CopperPilot/desktop-computer-retro/reviews/README.md

# Reviews

- [Design gates](gates.md): every deterministic check and its result.
- [Compact all-in-one CM5 desktop computer: main board](review-desktop-main.md): 0 P0, 0 P1, 0 P2
- [Compact all-in-one CM5 desktop computer: front SD card and brightness encoder sub-board](review-desktop-front_io.md): 0 P0, 0 P1, 0 P2
- [Compact 58-key mechanical desktop keyboard: main board](review-keyboard-main.md): 0 P0, 0 P1, 1 P2
- [Single-button rectangular optical USB mouse: main board](review-mouse-main.md): 0 P0, 0 P1, 0 P2
- [Independent judge](judge.md): the build compared with the reference photos.
- [Build film review](film.md): the film watched frame by frame by a separate critic.
- [KiCad ERC and DRC](kicad): the raw JSON reports for every board.
