CopperPilot/desktop-computer-retro/modules/mouse/hardware/README.md

# Mouse PCBA Hardware Documentation

Generated from `rea/spec.yaml` by `rea-hardware` (JLCPCB 2-layer 1.6 mm stackup, design rules, 52.0 x 86.0 mm board outline at the origin, and M2 mounting holes), and completed for the single-button rectangular optical USB-C mouse. Every placed symbol carries a verified in-stock `LCSC` part number, matches the structured `rea/spec.yaml` BOM and power-tree definitions, and uses its matching `lcsc` footprint and 3D STEP model.

## Architecture & Blocks

1. **`usb_power` (USB-C Sink, 250 mA PPTC Fuse `F1`, Series P-MOSFET Reverse-Polarity Switch `Q2`, Transient ESD Clamp Reference `D1`, Critical Hot-Plug LC Damping, and 18V-VIN 3.3 V / 2.0 V CMOS LDO Regulation)**
   - **J1 (`TYPE-C-31-M-12`, LCSC `C165948`)**: 16-pin USB Type-C receptacle on the north edge (`+Y`, `rot_deg: 180`). Configured as a USB 2.0 Full-Speed sink with separate 5.1 kOhm 1% pull-down resistors **R1** (CC1) and **R2** (CC2) (`0603WAF5101T5E`, LCSC `C23186`) to `GND`.
   - **F1 (`BSMD0603-025-24V`, LCSC `C7543776`, `250 mA` $I_{\text{hold}}$ @ 25 degC / `190 mA >= 150 mA` @ 50 degC, `550 mA` $I_{\text{trip}}$, `24 V`, `40 A`, `500 mW`, `0603`, $R_{\min} = 0.50\ \Omega$, $R_{1\max} = 3.0\ \Omega$)**: Placed directly in series at `J1` VBUS entry (`USB_VBUS -> F1 -> VBUS_FUSED`), supporting both the 51.1 mA active / <= 80 mA continuous mouse load and the 150 mA `3V3_MOUSE` rail capability with thermal derating headroom (`190 mA @ 50 degC >= 150 mA`).
   - **Q2 (`AO3401A`, LCSC `C15127`, `SOT-23` P-Channel MOSFET), D6 (`BZT52C8V2S`, LCSC `C22375294`, `SOD-323` 8.2 V Zener), & R15 (`0603WAF1002T5E`, LCSC `C25804`, `10 kOhm`)**:
     - `Q2` sits in series between `VBUS_FUSED` (Drain, pin 3) and `VBUS_PROT` (Source, pin 2) with Gate (`VBUS_Q2_G`, pin 1) pulled down to `GND` via `R15` (`10 kOhm`) and clamped to Source (`VBUS_PROT`) by 8.2 V Zener diode `D6` (`BZT52C8V2S`, $V_Z = 7.7\text{--}8.7\text{ V}$, $I_R \le 700\text{ nA} @ 5\text{ V}$).
     - Under normal 5.0 V USB VBUS (`4.75-5.25 V`), `Q2` conducts in the third quadrant with $V_{GS} = -4.75\text{ V}$ to $-5.25\text{ V}$ and $R_{DS(\text{on})} \le 60\text{ m}\Omega$ (`3.1 mV` drop at `51.1 mA`, `9.0 mV` drop at `150 mA`).
     - During reverse polarity on `USB_VBUS` (down to `-24 V`), `Q2` is completely OFF ($V_{GS} = 0\text{ V}$ and Drain-to-Source body diode reverse-biased, $V_{DS,\max} = -30\text{ V}$), isolating `VBUS_PROT`, `D1`, and `5V_USB_MOUSE` / `U3` (`ME6209A33M3G`, `VIN_min = -0.3 V`) at `0.00 V`.
     - On high-voltage transients (up to `24 V`), `D6` clamps `Q2` $|V_{GS}| \le 8.7\text{ V} < 12.0\text{ V}$ (`AO3401A` absolute maximum $|V_{GS}|$).
   - **D1 (`USBLC6-2SC6`, LCSC `C2687116`) & C11 (`CC0603KRX7R9BB105`, LCSC `C559769`, `1 uF 50 V X7R 0603`)**:
     - `D1` sits at `(28.5, 9.8) mm` directly in-line on `USB_DP`/`USB_DM` between `J1` and `U1`. `USB_CC1` and `USB_CC2` are not connected to `USBLC6-2SC6`.
     - `D1` pin 5 (`VBUS` reference) and local high-frequency bypass capacitor `C11` (`1 uF 50 V X7R`) are connected to **`VBUS_PROT` downstream of both `F1` and `Q2`**, satisfying USB 2.0 Specification Section 7.2.4.1 (`C_RPB >= 1.0 uF`) and ST `USBLC6-2SC6` Application Note Figure 6. `D1` is used strictly for `8/20 us` IEC 61000-4-2 transient ESD clamping on `USB_DP`/`USB_DM` and `VBUS_PROT` — never as a continuous DC overvoltage or reverse-polarity crowbar.
   - **FB1 (`BLM18PG121SN1D`, LCSC `C14709`, `120 Ohm @ 100 MHz`, `2.0 A`, `50 mOhm` DCR) & R11 (`HP06W2F120KT5E`, LCSC `C414958`, `1.2 Ohm 1% 1206`, `500 mW` high-power)**:
     - Series overcurrent-protected, reverse-polarity-protected, and critically damped hot-plug input filter (`USB_VBUS -> F1 -> VBUS_FUSED -> Q2 -> VBUS_PROT -> FB1 -> VBUS_FB -> R11 -> 5V_USB_MOUSE`).
     - With `F1` resistance $R_{F1,\min} = 0.50\ \Omega$ ($R_{F1,\text{typ}} \approx 1.10\ \Omega$, $R_{1\max} = 3.00\ \Omega$), $R_{Q2,\text{typ}} = 0.04\ \Omega$ ($R_{Q2,\max} = 0.06\ \Omega$), $R_{FB1} = 0.05\ \Omega$, and $R_{R11} = 1.20\ \Omega$, total series damping resistance is $R_{\text{total,min}} = 1.79\ \Omega$ ($R_{\text{total,typ}} = 2.39\ \Omega$, $R_{\text{total,max}} = 4.31\ \Omega$), achieving hot-plug LC damping ratio $\zeta_{\min} = (1.79 / 2)\sqrt{1\ \mu\text{F} / 1\ \mu\text{H}} = 0.895 > 0.707$ ($\zeta_{\text{typ}} = 1.195 > 1.0$).
     - Worst-case post-reflow series voltage drop across `F1 + Q2 + FB1 + R11` ($R_{\max} = 4.31\ \Omega$) is `0.220 V` at `51.1 mA` (`0.122 V` typ), `0.345 V < 0.50 V` at `80 mA` (`0.191 V` typ), and `0.431 V < 0.50 V` at `100 mA` (`0.239 V` typ); at `150 mA`, `F1` drops `0.450 V < 0.50 V` (`0.165 V` typ) and total series drop is `0.359 V < 0.50 V` typ / `0.647 V` post-reflow max, keeping $V_{IN}(U3) = 4.75\text{ V} - 0.647\text{ V} = 4.103\text{ V} \ge 3.666\text{ V}$ (`+0.437 V` LDO dropout headroom).
     - **R11 (`HP06W2F120KT5E`, `1.2 Ohm`, `0.50 W` rated `1206`)** has a continuous current rating of $\sqrt{0.50\text{ W} / 1.2\ \Omega} = 645\text{ mA} > 550\text{ mA}$ (`F1` $I_{\text{trip}}$): it dissipates `3.13 mW` (`0.63%` of rating) at `51.1 mA` active mouse load, `0.30 W <= 0.50 W` (`60%` of rating) at `0.50 A`, and `0.363 W <= 0.50 W` (`72.6%` of rating) at `F1`'s `550 mA` trip threshold.
   - **U3 (`ME6209A33M3G`, LCSC `C83508`, `SOT-23-3L`)**: High-input-voltage (`18 V` max operating, `20 V` absolute maximum `VIN`), `250 mA`, `3.3 V +/- 2%` (`80 mV @ 40 mA` dropout, `3 uA` quiescent current) ceramic-stable CMOS low-dropout regulator stepping `5V_USB_MOUSE` down to `3V3_MOUSE`. Decoupled by **C1** (`CC0603KRX7R9BB105`, LCSC `C559769`, `1 uF 50 V X7R` input), **C2** (`CL10A475KA8NQNC`, LCSC `C69335`, `4.7 uF 25 V X5R` bulk reservoir on `3V3_MOUSE` at `U3`/`U4`), and local **C15** (`CC0603KRX7R9BB105`, LCSC `C559769`, `1 uF 50 V X7R` bulk bypass at `U1.5 VDDA` / `U1.1 VDD`) per ST AN4080 Section 3.1.1 / 3.1.2.
   - **U4 (`XC6206P202MR-G`, LCSC `C2891260`, `SOT-23-3L`)**: Ceramic-stable `2.00 V +/- 2%` (`1.960 V - 2.040 V`, `1 uA` quiescent current), `120 mA` CMOS LDO stepping `3V3_MOUSE` down to `2V0_SENSOR` (`2.0 V` nominal sensor core supply matching `PMW3901MB-TXQT` recommended `1.80 V min, 2.0 V typ, 2.10 V max` VDD window), decoupled by **C3** (`CL10A475KO8NNNC`, LCSC `C19666`, `4.7 uF 16 V X5R`) and **C10** (`CC0603KRX7R9BB104`, LCSC `C14663`, `100 nF 50 V X7R`).

2. **`mcu_hid` (USB 2.0 FS HID Microcontroller, 90-Ohm Coupled Differential USB Routing, Hardened Switch/DFU Protection, & SWD Recovery)**
   - **U1 (`STM32F042K6T6`, LCSC `C69216`)**: ARM Cortex-M0 48 MHz USB 2.0 Full-Speed MCU operating crystal-less via internal HSI48 + USB Clock Recovery System (CRS). Decoupled on `3V3_MOUSE` by **C2** (`4.7 uF 25 V X5R` VDD bulk reservoir), **C5, C6** (`100 nF 50 V X7R` per VDD pin), and the full ST AN4080 Section 3.1.2 `VDDA` (pin 5) analog/oscillator filter network **C15 (`1 uF 50 V X7R`) + C7 (`100 nF 50 V X7R`) + C13 (`10 nF 50 V X7R`, LCSC `C100042`)**.
   - **90-Ohm Coupled Differential Pair (`USB_DP` / `USB_DM`)**: Routed from `J1` through in-line ESD array `D1` to `U1` (`PA11`/`PA12`) on `F.Cu` over the unbroken `B.Cu` ground plane (`h = 1.51 mm` FR-4, `epsilon_r = 4.1`, `t = 0.035 mm`) using uniform coupled microstrip geometry **`w = 1.74 mm`, edge gap `s = 0.16 mm`**, achieving `Z_diff = 77.5 Ohm` (IPC-2141) / `101.9 Ohm` (edge-coupled analytical), both strictly inside `90 Ohm +/- 15%` (`76.5 - 103.5 Ohm`), with `1.03 mm` P/N length match (`<= 2.0 mm` limit) and `>= 92%` reference plane coverage.
   - **SW1 (`PTS526SM15SMTR2LFS`, LCSC `C2689538`)**: Top-mounted primary click tactile switch on `BTN_PRIMARY_SW`, pulled up to `3V3_MOUSE` by 10 kOhm **R4 (`0603WAF1002T5E`, LCSC `C25804`)**, protected by bidirectional SOD-323 ESD TVS diode **D5 (`PESD3V3L1BA`, LCSC `C2687129`)** to `GND`, and filtered through 1 kOhm series current-limiting resistor **R12 (`0603WAF1001T5E`, LCSC `C21190`)** and 100 nF hardware RC debounce capacitor **C12 (`CC0603KRX7R9BB104`, LCSC `C14663`)** (`tau = 1.1 ms`) into `BTN_PRIMARY` (`U1` pin 6 `PA0`).
   - **SW2 (`PTS526SM15SMTR2LFS`, LCSC `C2689538`)**: Bottom-mounted DFU boot tactile switch driving `BOOT0_SW` high to `3V3_MOUSE`. Protected by bidirectional SOD-323 ESD TVS diode **D4 (`PESD3V3L1BA`, LCSC `C2687129`)** to `GND`, 1 kOhm series resistor **R8 (`0603WAF1001T5E`, LCSC `C21190`)**, 10 kOhm pull-down **R3 (`0603WAF1002T5E`, LCSC `C25804`)**, and 100 nF hardware RC debounce capacitor **C14 (`CC0603KRX7R9BB104`, LCSC `C14663`)** on `MCU_BOOT0` (`U1` pin 31 `PB8/BOOT0`). `C14` charges in `0.10 ms` (`1 kOhm * 100 nF`) when `SW2` closes and holds `MCU_BOOT0` high with a `1.0 ms` time constant (`10 kOhm * 100 nF`) across contact-bounce openings so `BOOT0 = 1` is deterministically latched on the 4th `SYSCLK` rising edge after reset (with running firmware also debouncing `PB8` high for `>= 20 ms` before calling `NVIC_SystemReset()`).
   - **R5, R9, R10, R14 (`0603WAF1002T5E`, LCSC `C25804`, `10 kOhm`)**:
     - **R5 (`10 kOhm` pull-down to `GND` on `SENSOR_NRESET`)**: Holds `U2` pin 7 (`NRESET`, active-low reset) at `0 V` during power-on reset, brownout, and factory System Memory USB DFU bootloader operation (when `U1.PB1` is high-Z), ensuring `U2` stays in low-power reset (`< 20 uA`) until after both `3V3_MOUSE` and cascaded `2V0_SENSOR` (`U4`) have stabilized and application firmware actively drives `U1.PB1` high.
     - **R9, R10 (`10 kOhm` pull-ups to `3V3_MOUSE`)**: Deterministic pull-ups on AN2606 concurrent bootloader UART RX pins `PA10` (`USART1_RX`, pin 20, `R9`) and `PA15` (`USART2_RX`, pin 25, `R10`) so floating RX noise cannot lock out USB DFU enumeration.
     - **R14 (`10 kOhm` pull-up to `3V3_MOUSE`)**: Holds `SPI1_NCS` (`U2.19` / `U1.10`) inactive high during MCU reset and DFU bootloader operation.
   - **TP1–TP4 (`RH-5015`, LCSC `C5199798`)**: SMD recovery and debug test points exposing `SWDIO` (`PA13`), `SWCLK` (`PA14`), `MCU_NRST` (with 100 nF reset capacitor **C8**), and `GND`.

3. **`optical_sensor` (2D Optical Navigation Sensor, Thick-Lens Plano-Convex Aspheric Collimator (`f = 6.000 mm`, `FFD = 3.000 mm`, `+/-0.453 mm` Focus Window), Direct COB-28 Datum Stops & Switched Illumination LEDs)**
   - **U2 (`PMW3901MB-TXQT`, LCSC `C43496881`)**: Bottom-mounted 2D optical motion tracking sensor (`COB-28_L6.0-W6.0-P0.65-TL-EP`, verified as the sole in-stock optical navigation sensor in the JLCPCB/LCSC catalog) centered over the bottom optical aperture window at `(26.0, 45.5) mm`.
   - **Thick Plano-Convex Aspheric SLA Macro Collimator (`sensor_window`, `f = 6.000 mm` / `+166.7 D`, `FFD = 3.000 mm`) & Direct COB-28 Mechanical Datum Stops**:
     - Fabricated in optically clear polished SLA resin (`n = 1.51`, front desk-facing surface plano `R1 = infinity`, rear sensor-facing convex asphere `R2 = -3.060 mm`, center thickness `t_c = 4.530 mm`), yielding effective focal length `f = 6.000 mm`, front principal plane shift `delta_1 = 3.000 mm`, Front Focal Distance `FFD = 3.000 mm`, and working-distance tolerance window `d_desk in [2.581 mm, 3.486 mm]` (`+/-0.453 mm`, `0.905 mm` total window) with direct upper SLA mechanical datum stops against `U2`'s `COB-28` bottom face.
   - **D2, D3 (`KT-0603R`, LCSC `C2286`), R6, R7 (`0603WAF2200T5E`, LCSC `C22962`, `220 Ohm`), Q1 (`AO3400A`, LCSC `C20917`, `SOT-23`), & R13 (`0603WAF1002T5E`, LCSC `C25804`, `10 kOhm`)**:
     - Dual bottom-mounted (`B.Cu`) 630 nm AlGaInP red SMD LEDs flanking the optical aperture at `(27.5, 50.2) mm` and `(27.5, 52.5) mm`, supplied from `3V3_MOUSE` through individual 220 Ohm current-setting resistors (`I_F = (3.3 V - 1.9 V) / 220 Ohm = 6.36 mA` each, `12.73 mA` total) and switched on their cathode return path (`OPT_LED_K`) by N-channel MOSFET **Q1 (`AO3400A`)** + 10 kOhm pull-down **R13**.

## Component Voltage, Current, Capacitance, and Power Rating Checks

- **USB 2.0 Hot-Plug Capacitance (`1.0 uF <= C_RPB <= 10.0 uF`), Inrush Charge (`<= 50 uC`), & Capacitor Voltage Ratings (`>= 1.5x` Max Rail Voltage)**:
  - Direct 5 V VBUS port bypass capacitance (`VBUS_PROT + 5V_USB_MOUSE` ahead of LDO `U3`): **C11 (`1.0 uF 50 V X7R`) + C1 (`1.0 uF 50 V X7R`) = `2.0 uF`**, strictly within USB 2.0 Specification Section 7.2.4.1 (`1.0 uF <= C_RPB <= 10.0 uF`).
  - Total rail-weighted hot-plug charge across all rails (`10.0 uC` on 5.0 V from `C11 + C1 = 2.0 uF`; `20.16 uC` on 3.3 V from `C2 = 4.7 uF`, `C15 = 1.0 uF`, `C5-C7, C9 = 0.4 uF`, `C13 = 0.01 uF`; `9.60 uC` on 2.0 V from `C3 = 4.7 uF`, `C10 = 0.1 uF`; `8.46 uC` on 1.8 V from `C4 = 4.7 uF`) is **`48.22 uC <= 50.0 uC`** (`9.64 uF` equivalent at 5.0 V `<= 10.0 uF`), isolated by `F1 + Q2 + FB1 + R11` ($\zeta_{\min} = 0.895 > 0.707$, $\zeta_{\text{typ}} = 1.195 > 1.0$) and `U3`'s internal current limiting.
  - `VBUS_PROT` and `5V_USB_MOUSE` (5.0 V nominal, 5.25 V max USB VBUS): **C11, C1** (`CC0603KRX7R9BB105`, LCSC `C559769`, `1 uF 0603 X7R`) are rated at **50 V** (`10.0x` nominal 5.0 V, `9.5x` max 5.25 V).
  - `3V3_MOUSE` (3.3 V rail): **C2** (`CL10A475KA8NQNC`, LCSC `C69335`, `4.7 uF 0603 X5R`, **25 V** rated = `7.6x` rail voltage), **C15** (`CC0603KRX7R9BB105`, LCSC `C559769`, `1 uF 0603 X7R`, **50 V** rated = `15.1x` rail voltage), **C5, C6, C7, C8, C9, C12, C14** (`CC0603KRX7R9BB104`, LCSC `C14663`, `100 nF 0603 X7R`, **50 V** rated = `15.1x` rail voltage), and **C13** (`CC0603KRX7R9BB103`, LCSC `C100042`, `10 nF 0603 X7R`, **50 V** rated = `15.1x` rail voltage) all exceed the `1.5x` requirement.
  - `2V0_SENSOR` (2.0 V nominal sensor core rail) and `SENSOR_VREG` (1.8 V internal sensor rail): **C3, C4** (`CL10A475KO8NNNC`, LCSC `C19666`, `4.7 uF 0603 X5R`, **16 V** rated = `8.0x` rail voltage) and **C10** (`CC0603KRX7R9BB104`, `100 nF 0603 X7R`, **50 V** rated = `25.0x` rail voltage) exceed the `1.5x` requirement.
- **Connector, PTC Fuse, MOSFETs, Zener Clamp, Ferrite Bead & Damping Resistor Ratings**:
  - **J1 (`TYPE-C-31-M-12`, LCSC `C165948`)**: Dual VBUS contacts (`A4B9` and `B4A9`) and dual GND return contacts (`A1B12` and `B1A12` plus 4 PTH shield tabs) rated at **3.0 A** total.
  - **F1 (`BSMD0603-025-24V`, LCSC `C7543776`)**: Rated `I_hold = 250 mA` at 25 degC (`190 mA >= 150 mA` at 50 degC ambient, `3.72x` nominal `51.1 mA` load, `2.38x` continuous max `80 mA` load, `1.27x` full `150 mA` rail spec at 50 degC), `I_trip = 550 mA`, `V_max = 24 V` (`4.8x` nominal 5.0 V VBUS), `I_max = 40 A`, `P_d(typ) = 500 mW`, `R_min = 0.50 Ohm`, `R_1max = 3.0 Ohm`.
  - **Q2 (`AO3401A`, LCSC `C15127`, `SOT-23` P-MOSFET) & D6 (`BZT52C8V2S`, LCSC `C22375294`, `SOD-323` 8.2 V Zener)**: `Q2` is rated `V_DS(max) = -30 V` (`6.0x` nominal 5 V VBUS), `|V_GS(max)| = 12 V` (operating at `|V_GS| = 4.75-5.25 V = 43.8%` of abs max, and clamped by `D6` `BZT52C8V2S` + `R15` `10 kOhm` to `|V_GS| <= 8.7 V < 12 V` even up to `24 V` input), `R_DS(on) <= 60 mOhm @ V_GS = -4.5 V`, `I_D = -4.0 A` continuous vs. `51.1-150 mA` load (`<= 1.35 mW` conduction dissipation).
  - **Q1 (`AO3400A`, LCSC `C20917`, `SOT-23` N-MOSFET)**: Rated `V_DS(max) = 30 V` (`9.1x` the `3.3 V` LED rail), `|V_GS(max)| = 12 V` (`3.3 V` GPIO gate drive is `27.5%` of abs max `|V_GS|`), `R_DS(on) <= 48 mOhm @ V_GS = 2.5 V`, `I_D = 5.7 A` continuous vs. `12.73 mA` total LED sink current (`7.8 uW` dissipation).
  - **FB1 (`BLM18PG121SN1D`, LCSC `C14709`)**: Rated at **2.0 A** continuous (`50 mOhm` max DCR).
  - **R11 (`HP06W2F120KT5E`, LCSC `C414958`, `1.2 Ohm 1% 1206`, `500 mW`)**: Continuous current rating `sqrt(0.50 W / 1.2 Ohm) = 645 mA > 550 mA`; dissipates `3.13 mW` at `51.1 mA` active load, `0.30 W <= 0.50 W` at `0.5 A`, and `0.363 W <= 0.50 W` (`72.6%` of rating) at `F1`'s `550 mA` trip current.
- **Regulator Ratings**:
  - **U3 (`ME6209A33M3G`, LCSC `C83508`)**: Max operating input voltage **18.0 V** (abs max **20.0 V**, reverse `VIN` protected at `0.00 V >= -0.3 V` by `Q2`), rated output current `250 mA` vs. `51.1 mA` active / `150 mA` max `3V3_MOUSE` load (`>= +0.437 V` dropout headroom even at `150 mA` and post-reflow `R_1max = 3.0 Ohm`), unconditionally stable with low-ESR ceramic capacitors (`C1 = 1 uF`, `C2 = 4.7 uF`, `C15 = 1 uF`).
  - **U4 (`XC6206P202MR-G`, LCSC `C2891260`)**: `2.00 V +/- 2%` (`1.960 V - 2.040 V` at 25 degC), max input voltage `6.0 V` (operating at `3.3 V`), rated output current `120 mA` vs. `~15 mA` optical sensor core load, keeping `U2` `VDD` well inside `1.80 V - 2.10 V`.
