CopperPilot/desktop-computer-retro/reviews/judge.md

# Independent judge

A separate agent compares the renders of the finished design with the reference photos, without seeing the design files or the other agents' notes.

**Overall 8/10** · form 8 · features 8 · requirements 8 (pass mark 7).

## Differences from the reference

- The desktop uses an 8.0-inch 4:3 IPS LCD panel (162.6x122.0 mm active window) instead of a full 9-inch 4:3 CRT-style display (184x138 mm), resulting in slightly wider front bezel margins around the screen.
- The external black 65 W USB-C PD power adapter block (psu) sits beside the rear-left of the desktop and is partially visible sticking out to the left of the desktop housing in docs/render-front.png.
- On the desktop front face, the 3.5-inch media recess houses a narrower 26x4.5 mm SD card slot opening where coplanar XY mounting of the front_io PCB leaves the green board surface visible behind the 3 mm slot collar, and an extra 20x10 mm rectangular recess sits on the lower-left front bezel above the under-chin brightness wheel.
- The keyboard enclosure has vertical slab-sided outer walls with keycaps recessed nearly flush inside the top cutout rather than standing tall above a broadly chamfered two-step bezel frame.
- On the mouse, the taupe primary button cap stands ~1.7 mm proud of the top shell rather than sitting flush within a recessed pocket.

## Requirements

| Id | Verdict | Note |
|---|---|---|
| R1 | met | The 247x300x346 mm vertical beige all-in-one desktop enclosure matches the 1984 reference silhouette and proportions, including the backward-tilted upper screen plane, deep sloped 4:3 CRT bezel recess, front horizontal media drive groove with diskette notch, under-chin brightness control wheel, top carry handle recess, side louvers, and rear I/O ports. |
| R2 | met | Raspberry Pi Compute Module 5 sits on dual 100-pin DF40C mezzanine sockets on the 4-layer rear carrier PCB with a complete end-to-end power path from the external 65 W USB-C PD adapter (autonomous resistor-strapped 15 V CH224A PD sink -> AO3407A P-FET load switch -> SY8205FCC 5 V / 5 A synchronous buck feeding CM5 5 V pins, TLV62569DBVR 3.3 V buck, and switched 5 V USB VBUS to the keyboard and mouse), MIPI DSI display drive with TPS61165 backlight boost, dedicated USB-C OTG flashing port + nRPIBOOT button, and RP1 USB host ports. |
| R3 | met | The separate 338x148x48 mm beige compact mechanical keyboard rests flat in front of the desktop in the proper desk orientation, populated with 58 Cherry MX-style switches in a 5x14 RP2040 diode matrix, 58 sculpted keycaps with dark legends, and a rear USB-C cable connecting P_KB_DEV to desktop host port P_KB. |
| R4 | met | The separate 62x97x37 mm rectangular beige single-button optical USB mouse rests flat to the right of the keyboard, with a wide taupe rectangular primary click button actuating SW1, bottom PMW3901MB-TXQT optical navigation sensor over the bottom lens window, STM32F042K6T6 USB HID MCU with 3.3 V LDO, and a north-edge USB-C cable connecting P_MOUSE_DEV to desktop host port P_MOUSE. |

## Features

| Id | Verdict | Note |
|---|---|---|
| F1 | approximate | Recessed 4:3 CRT-style display window and IPS LCD panel are properly seated inside the sloped upper front bezel recess, but use an 8.0-inch 4:3 panel (162.6x122.0 mm active area) rather than the full 9-inch (184x138 mm) window. |
| F2 | approximate | Horizontal 3.5-inch media slot recess with right-side diskette notch frames the push-push SD card socket (J_SD) facing straight out through the front bezel opening, though coplanar XY mounting of the front_io PCB leaves the flat green board surface visible at the back of the 3 mm slot collar. |
| F3 | approximate | Knurled brightness control wheel engages rotary encoder SW_ENC on front_io and protrudes 5 mm under the lower-left chin overhang, though an extra 20x10 mm rectangular recess is cut into the front bezel face above the chin. |
| F4 | ok | All 58 sculpted mechanical keycaps with dark legends and Cherry MX switches sit in the classic 5-row stepped layout (14+14+13+12+5) facing upward on the desk with push actuators aligned over every switch stem. |
| F5 | ok | Wide 36x22 mm taupe rectangular primary button cap sits near the front-top edge of the sloped mouse shell and its internal plunger directly actuates top-mounted tactile switch SW1. |
| F6 | ok | Rear USB-C PD power input receptacle (P_PWR / J_PWR) faces straight out through the rear desktop opening with its oval mouth and tongue visible and connects via power_cable to the external 65 W USB-C PD adapter. |
