CopperPilot/desktop-computer-retro/reviews/review-desktop-front_io.md

# Design review: Compact all-in-one CM5 desktop computer: front SD card and brightness encoder sub-board

Datasheet-level review of the schematic and layout by CopperPilot's independent review agent (`validate`). Severity: **P0** must be fixed before fabrication, **P1** should be fixed, **P2** worth a look.

Result: **0 P0**, **0 P1**, **0 P2**.

No findings.
