CopperPilot/desktop-computer-retro/reference/README.md

# Reference

What the CopperPilot agents were given: the prompt in [prompt.md](prompt.md) and the photos below.

Reference photos of a commercial product, used here only for comparison. All rights belong to their owners; this project is not affiliated with or endorsed by the product's maker.

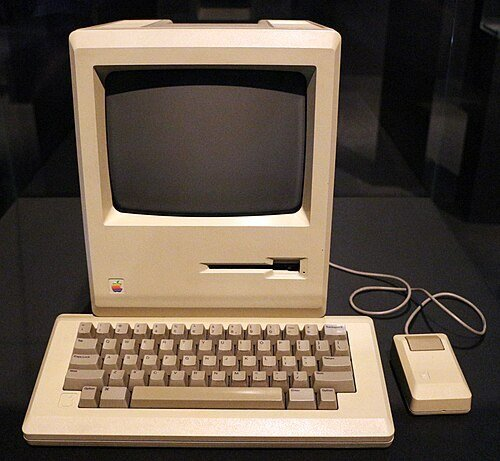
[picture p9: reference/photos/front.jpg]
front

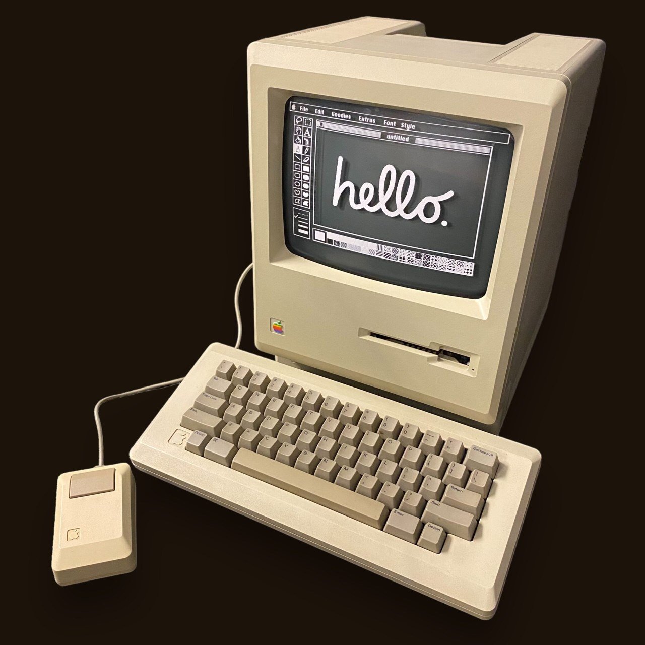
[picture p10: reference/photos/three_quarter_dark.jpg]
three_quarter_dark

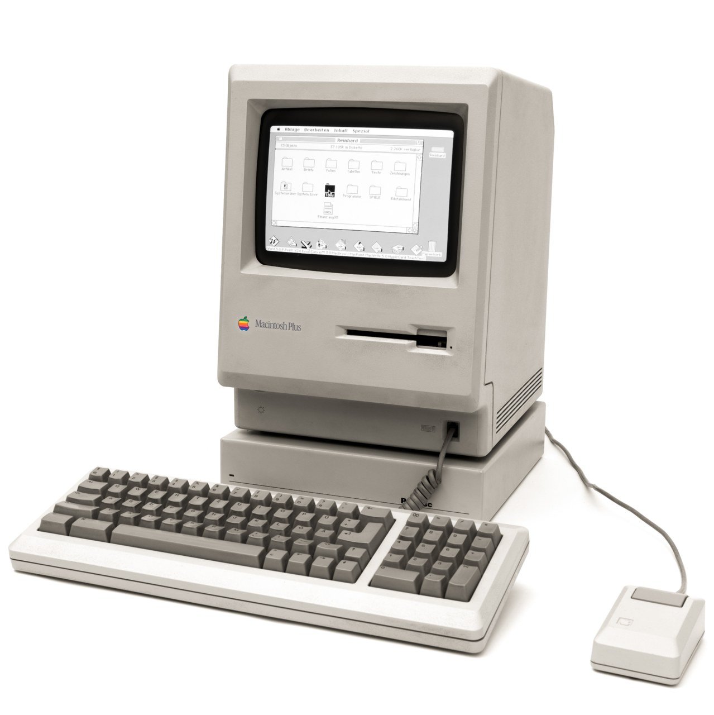
[picture p11: reference/photos/three_quarter_light.jpg]
three_quarter_light
