CopperPilot/desktop-computer-retro/docs/images/thumbnail.gif

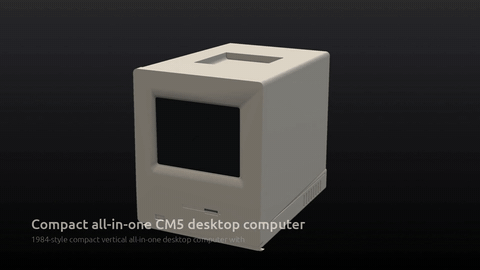
docs/images/thumbnail.gif
