CopperPilot/desktop-computer-retro/modules/mouse/fab/mouse-bom.csv

Comment | Designator | Footprint | LCSC Part #
1uF | C1,C11,C15 | C0603 | C559769
100nF | C5,C6,C7,C8,C9,C10,C12,C14 | C0603 | C14663
10nF | C13 | C0603 | C100042
4.7uF | C2 | C0603 | C69335
4.7uF | C3,C4 | C0603 | C19666
USBLC6-2SC6 | D1 | SOT-23-6_L2.9-W1.6-P0.95-LS2.8-BL | C2687116
KT-0603R | D2,D3 | LED-SMD_L1.6-W0.8-R-RD | C2286
PESD3V3L1BA | D4,D5 | SOD-323_L1.7-W1.3-LS2.6-BI | C2687129
BZT52C8V2S | D6 | SOD-323_L1.7-W1.3-LS2.6-RD-1 | C22375294
BSMD0603-025-24V | F1 | F0603 | C7543776
BLM18PG121SN1D | FB1 | L0603 | C14709
TYPE-C-31-M-12 | J1 | USB-C_SMD-TYPE-C-31-M-12_1 | C165948
AO3400A | Q1 | SOT-23-3_L2.9-W1.3-P1.90-LS2.4-BR | C20917
AO3401A | Q2 | SOT-23_L2.9-W1.3-P1.90-LS2.4-BR | C15127
5.1k | R1,R2 | R0603 | C23186
10k | R3,R4,R5,R9,R10,R13,R14,R15 | R0603 | C25804
1.2R | R11 | R1206 | C414958
1k | R8,R12 | R0603 | C21190
220R | R6,R7 | R0603 | C22962
PTS526SM15SMTR2LFS | SW1,SW2 | SW-SMD_4P-L5.2-W5.2-P3.70-LS6.4 | C2689538
STM32F042K6T6 | U1 | LQFP-32_L7.0-W7.0-P0.80-LS9.0-BL | C69216
PMW3901MB-TXQT | U2 | COB-28_L6.0-W6.0-P0.65-TL-EP | C43496881
ME6209A33M3G | U3 | SOT-23-3_L2.9-W1.6-P1.90-LS2.8-BR | C83508
XC6206P202MR-G | U4 | SOT-23-3_L2.9-W1.6-P1.90-LS2.8-BR | C2891260
