CopperPilot/desktop-computer-retro/modules/desktop/fab/compact-cm5-desktop-bom.csv

Comment | Designator | Footprint | LCSC Part #
10uF | C_3V3_1,C_3V3_IN,C_3V3_OUT1,C_3V3_OUT2,C_BL_IN,C_KB_VBUS,C_MOUSE_VBUS,C_VIN1,C_VIN2 | C0805 | C33546007
100nF | C_3V3_2,C_3V3_3,C_3V3_HF,C_5V4,C_BOOT_VBUS,C_BUCK_BST,C_BUCK_EN,C_CC_KB,C_CC_MOUSE,C_CM5_1V8,C_CM5_5V,C_DSI_3V3,C_HDMI_5V,C_KB_DEC,C_MOUSE_DEC,C_PD_SS,C_VIN3 | C0402 | C307331
47uF | C_5V1,C_5V2,C_5V3 | C0805 | C76636
220nF | C_BL_COMP | C0402 | C915854
1uF 50V | C_BL_OUT | C0805 | C91185
22nF | C_BUCK_SS | C0402 | C1532
1uF | C_BUCK_VREG,C_DSI_IN,C_HDMI_IN,C_PD_VHV | C0603 | C15849
100uF | C_CM5_BULK | CAP-SMD_L7.3-W4.3_SA11CM470A19R55XXX | C135491
47uF | C_PD_BULK | CAP-SMD_L7.3-W4.3-FD | C2761441
1uF | C_PD_IN | C0805 | C91185
B5819W | D_3V3_CLAMP | SOD-123F_L2.7-W1.6-LS3.8-RD-1 | C2943878
MBR0560 | D_BL | SOD-123_L2.8-W1.8-LS3.7-RD | C77338
PTVS36VS1UR,115 | D_BL_A | SOD-123_L2.6-W1.7-LS3.5-RD | C171823
PTVSLC3D3V3B | D_BL_FB | SOD-323_L1.8-W1.3-LS2.5-BI | C246774
TSD05CDYFR | D_BOOT_CC1,D_BOOT_CC2,D_KB_TVS1,D_KB_TVS2,D_MOUSE_TVS1,D_MOUSE_TVS2,D_PD_CC1,D_PD_CC2,D_SW_BOOT,D_SW_PWR | SOD-323_L1.8-W1.3-LS2.5-BI | C20611048
USBLC6-2SC6 | D_ESD_BOOT,D_ESD_KB,D_ESD_MOUSE | SOT-23-6_L2.9-W1.6-P0.95-LS2.8-BL | C2827654
TPD4E05U06DQAR | D_ESD_PWR,D_HDMI_ESD1,D_HDMI_ESD2,D_HDMI_ESD3 | USON-10_L2.5-W1.0-P0.50-BL | C138714
PTVS15VS1UR,115 | D_PD_VBUS | SOD-123_L2.6-W1.7-LS3.5-RD | C513104
B4B-PH-SM4-TB | J_BL | CONN-SMD_B4B-PH-SM4-TB-LF-SN | C160354
TYPE-C-31-D-06 | J_BOOT,J_KB,J_MOUSE,J_PWR | USB-C-SMD_TYPE-C-31-D-06 | C2689964
FH12-22S-0.5SH | J_DSI,J_FIO | FPC-SMD_22P-P0.50_FH12-22S-0.5SH-55 | C597981
HYC79-HDMIA19-105 | J_HDMI | HDMI-SMD_HYC79-HDMIA19-105 | C711353
2.2uH | L_3V3 | IND-SMD_L4.0-W4.0 | C370436
22uH | L_BL | IND-SMD_L4.0-W4.0_SLW4010S | C83472
4.7uH | L_BUCK | IND-SMD_L5.4-W5.2 | C436535
BSS138 | Q_3V3_DIS,Q_3V3_INV | SOT-23-3_L2.9-W1.3-P1.90-LS2.4-BR | C78284
2N7002 | Q_KB_EN,Q_MOUSE_EN | SOT-23-3_L2.9-W1.3-P1.90-LS2.4-BR | C8545
AO3407A | Q_PD_SW | SOT-23_L2.9-W1.3-P1.90-LS2.4-BR | C347478
1k | R_3V3_BLEED,R_DSI_DIS,R_ENC_A,R_ENC_B,R_ENC_SW,R_PD_VHV | R0402 | C11702
33R | R_3V3_DIS,R_SD_CLK,R_SD_CMD,R_SD_DAT0,R_SD_DAT1,R_SD_DAT2,R_SD_DAT3 | R0402 | C25105
10k | R_3V3_DIS_PU,R_3V3_EN,R_BUCK_FB2,R_DSI_OC,R_KB_DIS,R_KB_OC,R_MOUSE_DIS,R_MOUSE_OC | R0402 | C25744
100k | R_3V3_EN_PD,R_3V3_FB1,R_BL_PD,R_BUCK_EN1,R_DSI_EN,R_KB_EN,R_MOUSE_EN,R_PD_PG,R_PD_PG2,R_SD_CMD_PU,R_SD_DAT0_PU,R_SD_DAT1_PU,R_SD_DAT2_PU,R_SD_DAT3_PU,R_SD_PWR_PD,R_VBUS_EN | R0402 | C25741
22.1k | R_3V3_FB2 | R0402 | C43473
4.7k | R_BL_FB,R_KB_PORT,R_MOUSE_PORT | R0402 | C25900
0.91R | R_BL_SET | R0805 | C17478
5.1k | R_BOOT_CC1,R_BOOT_CC2 | R0402 | C25905
20k | R_BUCK_EN2 | R0402 | C25765
73.2k | R_BUCK_FB1 | R0402 | C26986
1.8k | R_DSI_SCL,R_DSI_SDA | R0402 | C25871
0R | R_FIO_RET1,R_FIO_RET2 | R0402 | C17168
910k | R_KB_VDET,R_MOUSE_VDET | R0402 | C25800
56k | R_PD_CFG1 | R0402 | C114756
PTS526SM15SMTR2LFS | SW_BOOT,SW_PWR | SW-SMD_4P-L5.2-W5.2-P3.70-LS6.4 | C2689538
TLV62569DBVR | U_3V3 | SOT-23-5_L3.0-W1.7-P0.95-LS2.8-BR | C141836
TPS61165DBVR | U_BL | SOT-23-6_L2.9-W1.6-P0.95-LS2.8-BR | C58756
SY8205FCC | U_BUCK | SOIC-8_L5.0-W4.0-P1.27-LS6.0-BL-EP2.0 | C111875
TUSB320LIRWBR | U_CC_KB,U_CC_MOUSE | X2QFN-12_L1.6-W1.6-P0.40-TL | C2836598
DF40C-100DS-0.4V(51) | U_CM5 | Raspberry-Pi-5-Compute-Module | C597931
CH224A | U_PD | ESSOP-10_L4.9-W3.9-P1.0-LS6.0-TL-EP | C42459160
TPS2051BDBVR | U_SW_DSI | SOT-23-5_L3.0-W1.7-P0.95-LS2.8-BR | C24593
AP2331SA-7 | U_SW_HDMI | SOT-23-3_L2.9-W1.3-P1.90-LS2.4-BR | C500764
TPS2041BDBVR | U_SW_KB,U_SW_MOUSE | SOT-23-5_L3.0-W1.7-P0.95-LS2.8-BR | C51386
