CopperPilot/desktop-computer-retro/modules/keyboard/fab/compact-58key-keyboard-bom.csv

Comment | Designator | Footprint | LCSC Part #
2.2uF | C1 | C0805 | C19110
100nF | C5,C6,C7,C8,C9,C10,C11,C12,C13,C14,C17 | C0402 | C1525
12pF | C15,C16 | C0402 | C1547
4.7uF | C2 | C0805 | C1779
1uF | C3,C4 | C0402 | C52923
1N4148W | D1,D2,D3,D4,D5,D6,D7,D8,D9,D10,D11,D12,D13,D14,D15,D16,D17,D18,D19,D20,D21,D22,D23,D24,D25,D26,D27,D28,D29,D30,D31,D32,D33,D34,D35,D36,D37,D38,D39,D40,D41,D42,D43,D44,D45,D46,D47,D48,D49,D50,D51,D52,D53,D54,D55,D56,D57,D58 | SOD-123F_L2.7-W1.6-LS3.8-RD | C81598
PTVS5V0S1UR-FS | D60 | SOD-123FL_L2.7-W1.8-LS3.8-RD | C5380694
500mA | F1 | F0805 | C910822
TYPE-C-31-M-12 | J1 | USB-C_SMD-TYPE-C-31-M-12_1 | C165948
5.1k | R1,R2 | R0402 | C25905
27R | R3,R4 | R0402 | C25156
1k | R5,R6 | R0402 | C11702
10k | R7,R8 | R0402 | C25744
CPG151101D06 | SW1,SW2,SW3,SW4,SW5,SW6,SW7,SW8,SW9,SW10,SW11,SW12,SW13,SW16,SW17,SW18,SW19,SW20,SW21,SW22,SW23,SW24,SW25,SW26,SW27,SW30,SW31,SW32,SW33,SW34,SW35,SW36,SW37,SW38,SW39,SW40,SW43,SW44,SW45,SW46,SW47,SW48,SW49,SW50,SW51,SW52 | SW_Cherry_MX_1.00u_PCB | C49234237
CPG151101D06 | SW14 | SW_Cherry_MX_2.00u_PCB | C49234237
CPG151101D06 | SW15,SW28,SW55,SW57 | SW_Cherry_MX_1.50u_PCB | C49234237
CPG151101D06 | SW29 | SW_Cherry_MX_1.75u_PCB | C49234237
CPG151101D06 | SW41,SW42 | SW_Cherry_MX_2.25u_PCB | C49234237
CPG151101D06 | SW53 | SW_Cherry_MX_2.75u_PCB | C49234237
CPG151101D06 | SW54,SW58 | SW_Cherry_MX_1.25u_PCB | C49234237
CPG151101D06 | SW56 | SW_Cherry_MX_6.25u_PCB | C49234237
TS-1187A-B-A-B | SW59 | SW-SMD_4P-L5.1-W5.1-P3.70-LS6.5-TL_H1.5 | C318884
RP2040 | U1 | LQFN-56_L7.0-W7.0-P0.4-EP | C2040
W25Q128JVSIQ | U2 | SOIC-8_L5.3-W5.3-P1.27-LS8.0-BL | C97521
LDL1117S33R | U3 | SOT-223-4_L6.5-W3.5-P2.30-LS7.0-BR | C435835
USBLC6-2SC6 | U4 | SOT-23-6_L2.9-W1.6-P0.95-LS2.8-BL | C2827654
ABM8-272-T3 | Y1 | CRYSTAL-SMD_4P-L3.2-W2.5-BL | C20625731
