CopperPilot/desktop-computer-retro/modules/desktop/fab/front_io/compact-cm5-desktop-front_io-bom.csv

Comment | Designator | Footprint | LCSC Part #
10uF | C1,C8 | C0603 | C3038124
100nF | C2,C3,C4,C5,C6,C9,C10,C11,C12,C13,C14,C17,C18 | C0402 | C131394
100pF | C15,C16 | C0402 | C1546
22uF | C7 | C0805 | C45783
PTVSLC3D3V3B | D1 | SOD-323_L1.8-W1.3-LS2.5-BI | C246774
RB751V40T1G | D2,D3,D4,D5,D6 | SOD-323_L1.8-W1.3-LS2.5-RD | C154819
SD-106M | J_SD | SD-SMD_SD-106M | C266603
FH12-22S-0.5SH | J_SUB_FIO | FPC-SMD_22P-P0.50_FH12-22S-0.5SH-55 | C597981
BSS138 | Q1,Q2,Q3,Q4 | SOT-23-3_L2.9-W1.3-P1.90-LS2.4-BR | C78284
47k | R1,R2,R3,R4,R5 | R0402 | C25792
10k | R6,R7,R8,R9,R10,R11,R18,R19,R20,R21,R23,R24,R34,R39 | R0402 | C25744
22R | R12,R14,R15,R37,R38,R40 | R0402 | C25092
470R | R13,R29,R30,R32 | R0402 | C25117
33R | R16,R17,R25,R26,R27 | R0402 | C25105
56k | R22,R35 | R0402 | C25796
0R | R28,R36 | R0402 | C17168
1k | R31,R33 | R0402 | C11702
EC11J1525402 | SW_ENC | SW-SMD_EC11J1525402 | C209762
AP22653W6-7 | U1 | SOT-23-6_L2.9-W1.6-P0.95-LS2.8-BR | C2158037
RCLAMP3324P.TNT | U2,U3,U4,U6 | DFN2510-10_L2.5-W1.0-P0.50-BL | C1976652
SN74LVC3G17DCTR | U5,U8 | MSOP-8_L2.9-W2.8-P0.65-LS4.0-BL | C18213
SN74CB3Q3245PWR | U7 | TSSOP-20_L6.5-W4.4-P0.65-LS6.4-BL | C470961
SN74LVC1G97DBVR | U9 | SOT-23-6_L2.9-W1.6-P0.95-LS2.8-BR | C128411
