CopperPilot/desktop-computer-retro/modules/desktop/case/out/rf_vent_window.stl

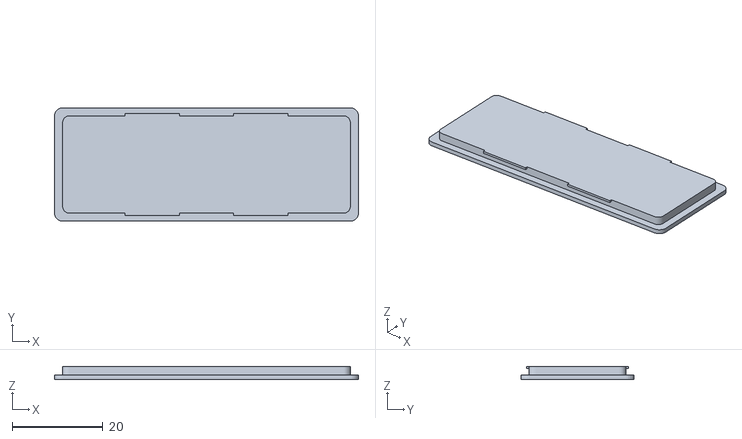
[picture p13: CAD file, 2026-11-03]
modules/desktop/case/out/rf_vent_window.stl
67.0 x 25.0 x 2.90
