CopperPilot/desktop-computer-retro/modules/desktop/fab/compact-cm5-desktop.step

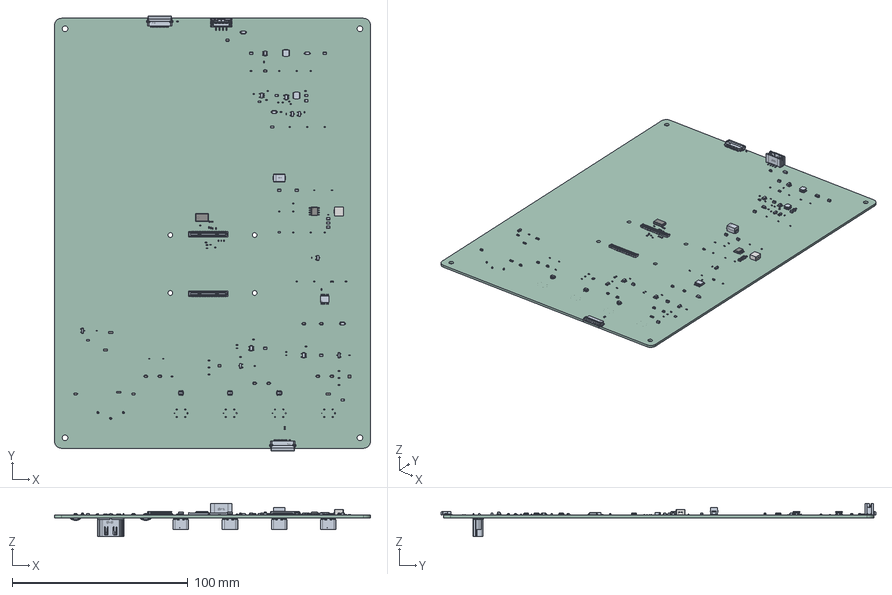
[picture p14: CAD file, 2026-11-03]
modules/desktop/fab/compact-cm5-desktop.step
180.0 x 247.7 x 18.9 mm
R0402_L1.0-W0.5-H0.4 x 52
USON-10_L2.5-W1.0-H0.6-P0.50 x 4
SOD-323_L1.8-W1.3-LS2.5-BI x 11
R0805_L2.0-W1.3-H0.6
10164227-1001A1RLF x 2
零件39
IND-SMD_L5.4-W5.2-H3.0
CAP-SMD_L7.3-W4.3_SA11CM470A19R55XXX
X2QFN-12_L1.6-W1.6-H0.4-P0.40-TL x 2
compact-cm5-desktop_PCB
