CopperPilot/desktop-computer-retro/modules/desktop/fab/front_io/compact-cm5-desktop-front_io.step

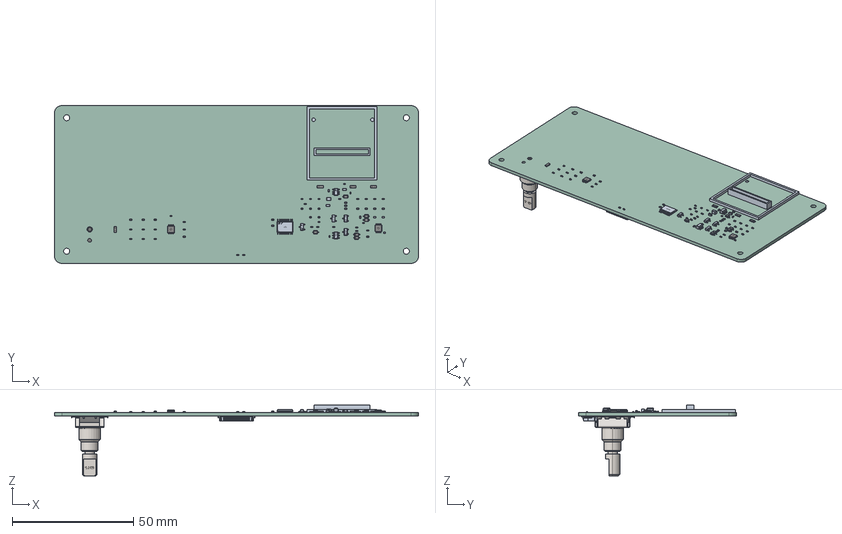
[picture p15: CAD file, 2026-11-03]
modules/desktop/fab/front_io/compact-cm5-desktop-front_io.step
150.0 x 65.0 x 29.1 mm
R0402_L1.0-W0.5-H0.4 x 40
MSOP-8_L2.9-W2.8-P0.65-LS4.0-BL x 2
零件2 x 5
DFN-10_L2.5-W1.0-H0.5-P0.50 x 4
SOD-323_L1.8-W1.3-LS2.5-BI
SW-SMD_EC11J1525402-L15.0-W18.0-H24.5-P2.5
compact-cm5-desktop-front_io_PCB
