CopperPilot/desktop-computer-retro/modules/desktop/fab/mech/display_window.step

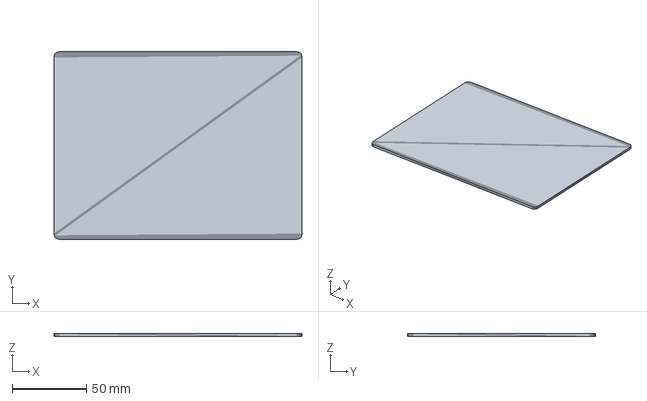
[picture p16: CAD file, 2026-11-03]
modules/desktop/fab/mech/display_window.step
166.6 x 126.0 x 2.00 mm
