CopperPilot/desktop-computer-retro/modules/keyboard/case/out/bootsel_button.stl

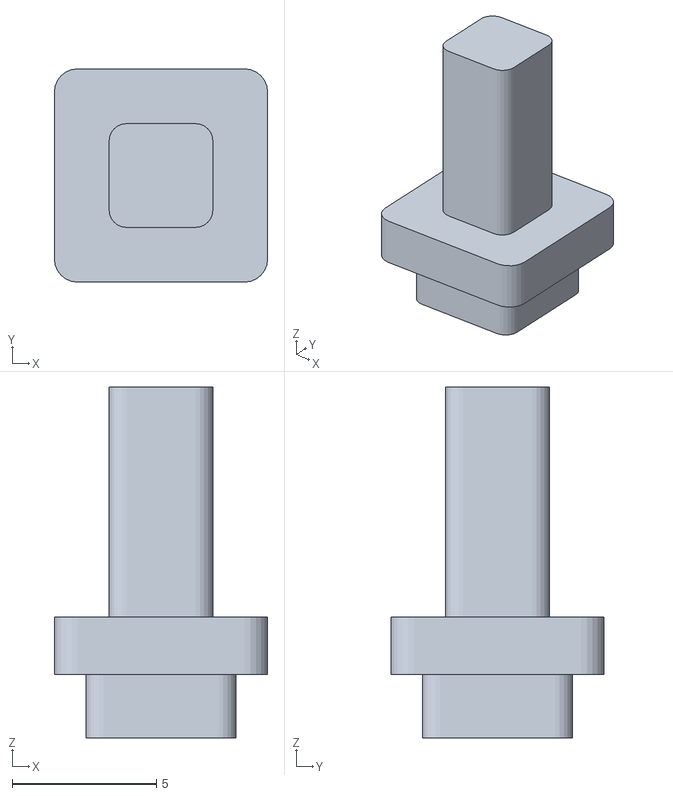
[picture p17: CAD file, 2026-11-03]
modules/keyboard/case/out/bootsel_button.stl
7.40 x 7.40 x 12.2
