CopperPilot/desktop-computer-retro/modules/keyboard/fab/compact-58key-keyboard.step

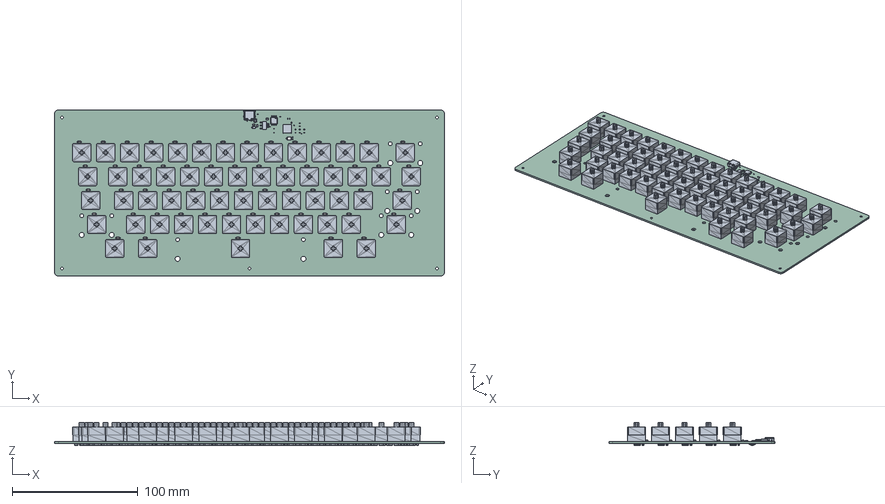
[picture p18: CAD file, 2026-11-03]
modules/keyboard/fab/compact-58key-keyboard.step
310.0 x 132.0 x 18.5 mm
SOD-123F_L2.7-W1.6-LS3.8-RD x 58
R0402_L1.0-W0.5-H0.4 x 8
F0805_L2.1-W1.4-H0.8
OSC-SMD_L3.2-W1.5-H0.8
compact-58key-keyboard_PCB
