CopperPilot/desktop-computer-retro/modules/keyboard/fab/mech/bottom_shell.stl

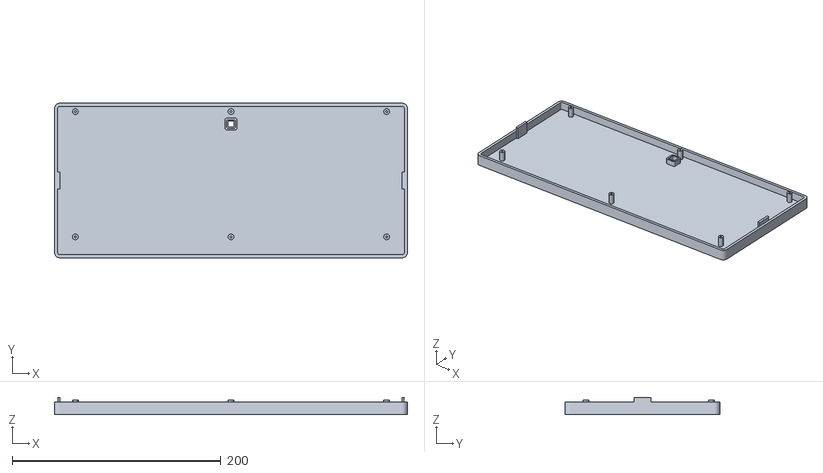
[picture p19: CAD file, 2026-11-03]
modules/keyboard/fab/mech/bottom_shell.stl
338.0 x 148.0 x 16.5
