CopperPilot/desktop-computer-retro/modules/keyboard/hardware/3d/keyswitch_mx.step

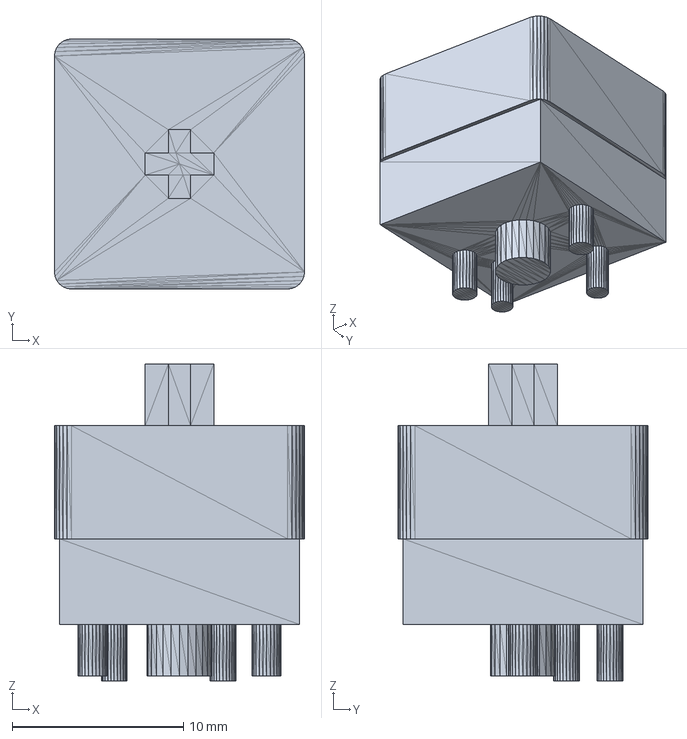
[picture p20: CAD file, 2026-11-03]
modules/keyboard/hardware/3d/keyswitch_mx.step
14.6 x 14.6 x 18.5 mm
