CopperPilot/desktop-computer-retro/modules/mouse/case/out/top_shell.stl

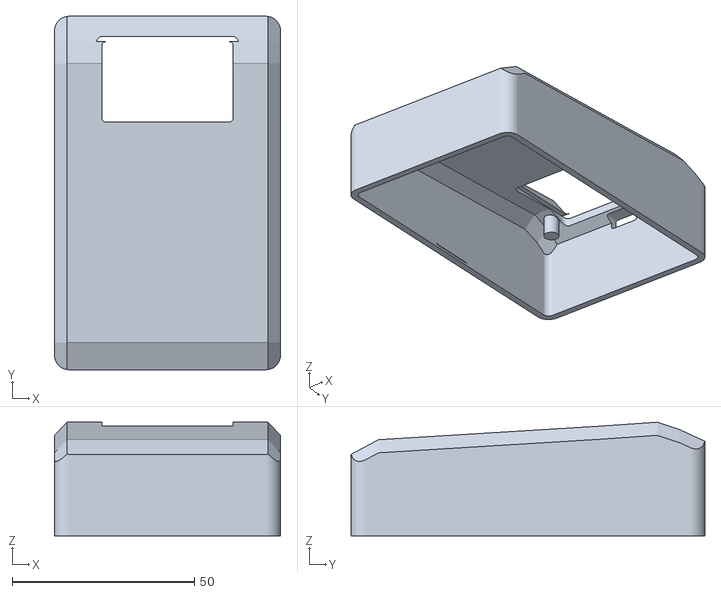
[picture p21: CAD file, 2026-11-03]
modules/mouse/case/out/top_shell.stl
62.0 x 97.0 x 31.2
