CopperPilot/desktop-computer-retro/modules/mouse/fab/mech/primary_button.stl

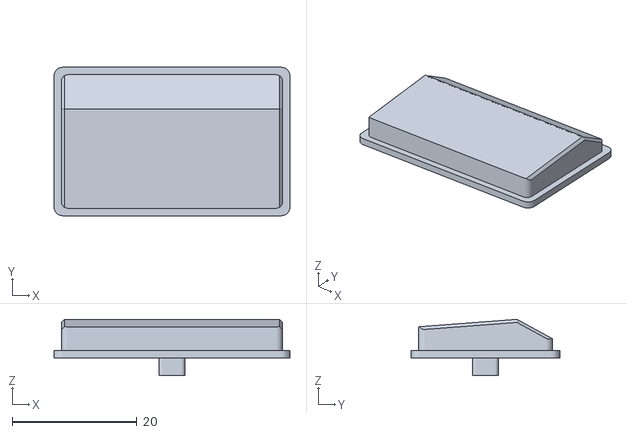
[picture p22: CAD file, 2026-11-03]
modules/mouse/fab/mech/primary_button.stl
37.8 x 23.8 x 9.04
