CopperPilot/desktop-computer-retro/modules/mouse/fab/mouse.step

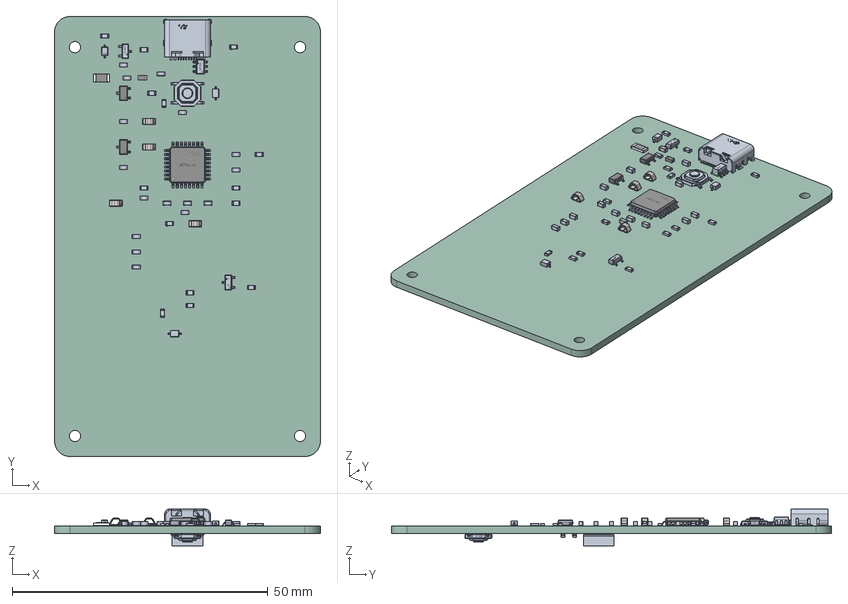
[picture p23: CAD file, 2026-11-03]
modules/mouse/fab/mouse.step
52.0 x 86.0 x 7.21 mm
SOT-23-3L_L2.9-W1.6-H1.1-LS2.8-P0.95 x 2
SMD_RH-5015 x 4
LQFP-32_L7.0-W7.0-H1.4-LS9.0-P0.80
R1206_L3.2-W1.6-H0.6
F0603_L1.7-W0.9-H0.7
LED0603_L1.6-W0.8-H0.6 x 2
mouse_PCB
