CopperPilot/desktop-computer-retro/modules/desktop/case/out/brightness_wheel.stl

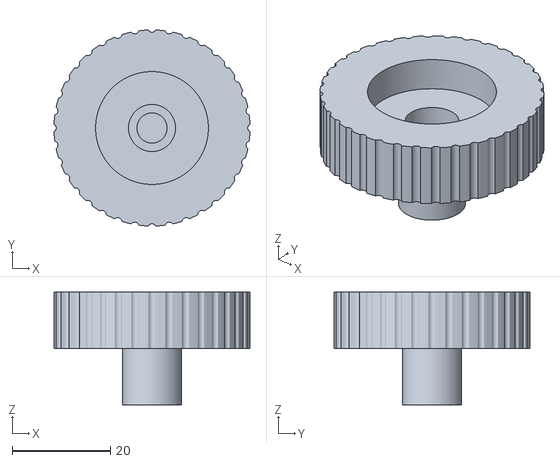
[picture p24: CAD file, 2026-11-03]
modules/desktop/case/out/brightness_wheel.stl
40.0 x 40.0 x 23.0
