CopperPilot/desktop-computer-retro/modules/desktop/fab/mech/front_bezel.stl

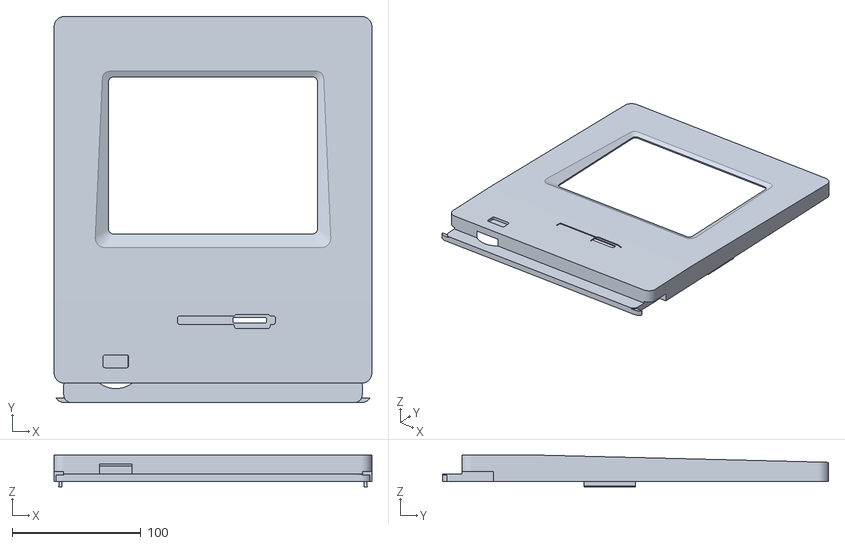
[picture p25: CAD file, 2026-11-03]
modules/desktop/fab/mech/front_bezel.stl
247.0 x 300.0 x 24.5
