CopperPilot/desktop-computer-retro/modules/keyboard/case/out/keycaps_legends.stl

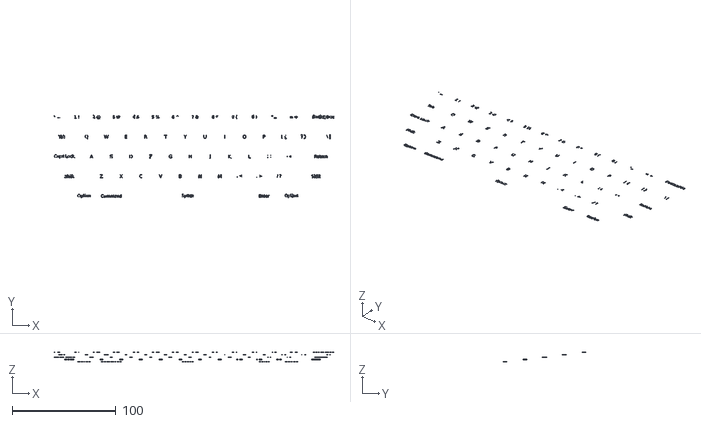
[picture p26: CAD file, 2026-11-03]
modules/keyboard/case/out/keycaps_legends.stl
270.3 x 80.0 x 9.35
