CopperPilot/desktop-computer-retro/modules/mouse/case/out/boot_button.stl

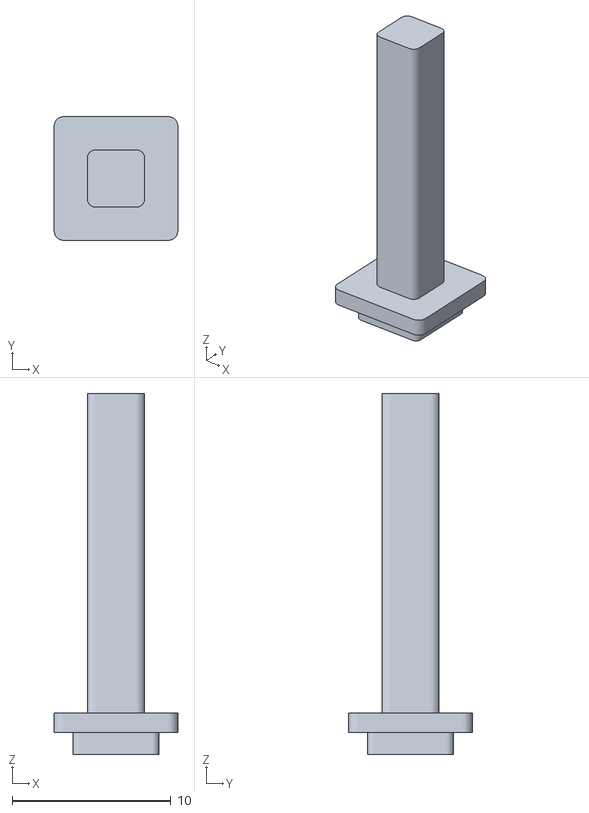
[picture p27: CAD file, 2026-11-03]
modules/mouse/case/out/boot_button.stl
7.80 x 7.80 x 22.7
