CopperPilot/desktop-computer-retro/modules/mouse/fab/mech/sensor_window.stl

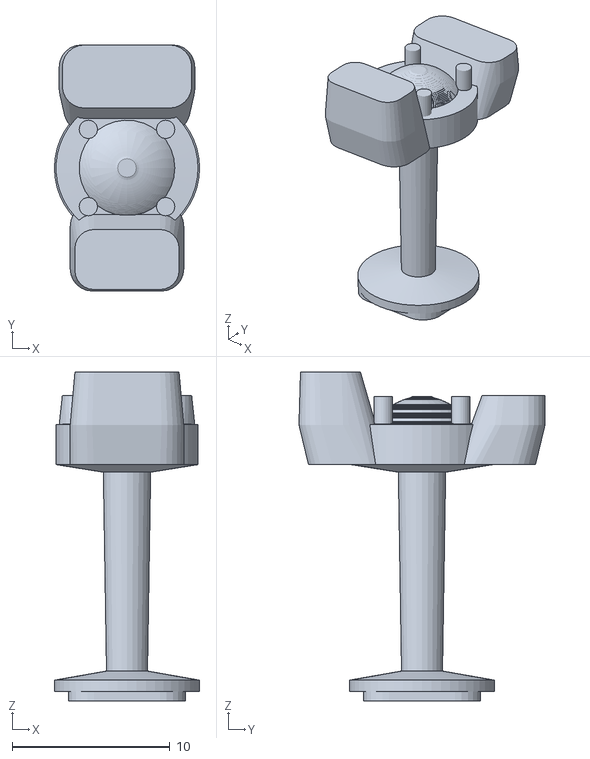
[picture p28: CAD file, 2026-11-03]
modules/mouse/fab/mech/sensor_window.stl
9.20 x 15.6 x 20.9
