CopperPilot/desktop-computer-retro/modules/desktop/fab/mech/rear_bucket.stl

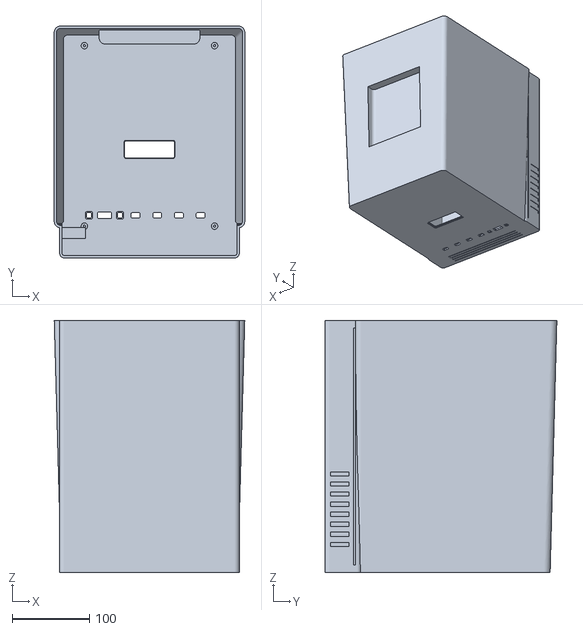
[picture p29: CAD file, 2026-11-03]
modules/desktop/fab/mech/rear_bucket.stl
246.0 x 299.2 x 325.3
