CopperPilot/desktop-computer-retro/modules/keyboard/case/out/top_shell.stl

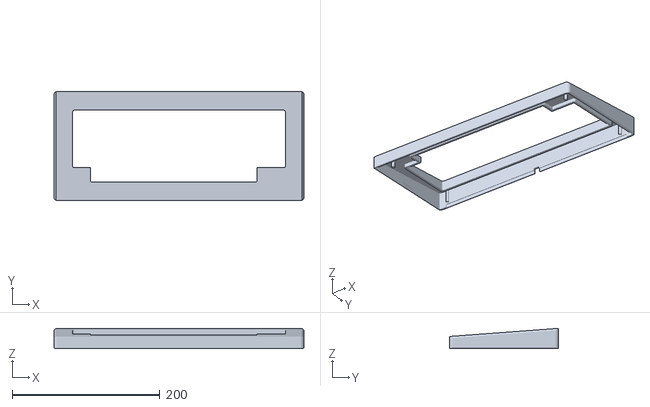
[picture p30: CAD file, 2026-11-03]
modules/keyboard/case/out/top_shell.stl
338.0 x 148.0 x 27.5
