CopperPilot/desktop-computer-retro/modules/mouse/fab/mech/bottom_shell.stl

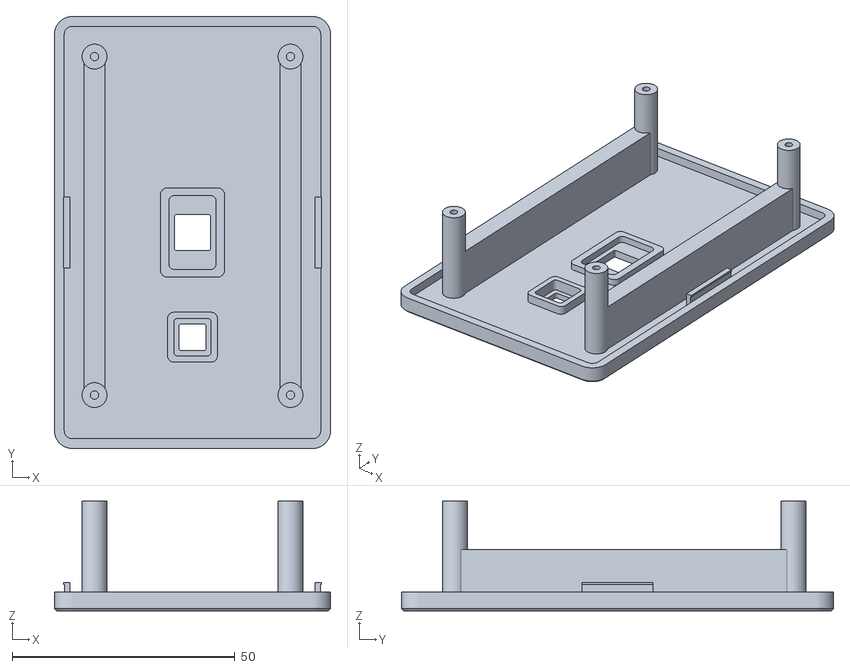
[picture p31: CAD file, 2026-11-03]
modules/mouse/fab/mech/bottom_shell.stl
62.0 x 97.0 x 24.6
