CopperPilot/desktop-computer-retro/modules/keyboard/fab/mech/keycaps.stl

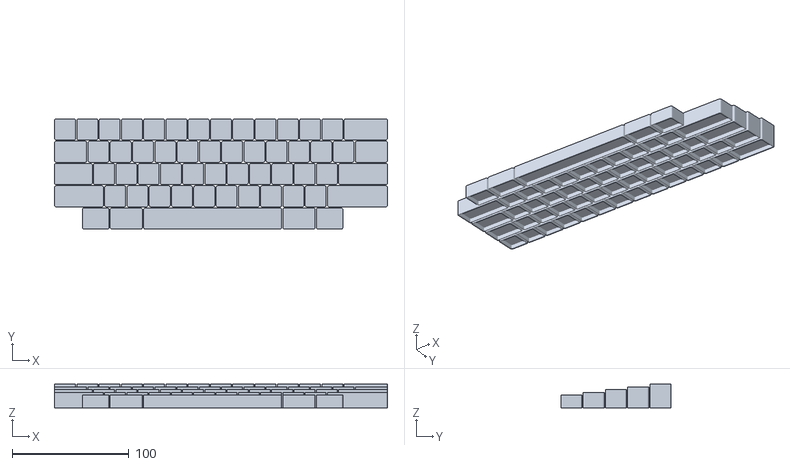
[picture p32: CAD file, 2026-11-03]
modules/keyboard/fab/mech/keycaps.stl
284.8 x 94.2 x 20.4
