CopperPilot/desktop-computer-retro/modules/desktop/fab/mech/rear_buttons.stl

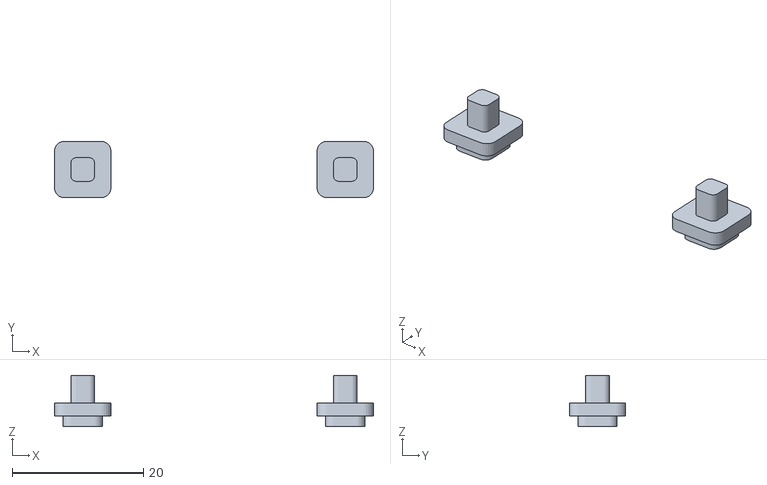
[picture p33: CAD file, 2026-11-03]
modules/desktop/fab/mech/rear_buttons.stl
48.6 x 8.60 x 7.80
