CopperPilot/desktop-computer-retro/(list of files, cad)

Other CAD files:
modules/desktop/case/out/display_window.stl
modules/desktop/case/purchased/cm5_module.stl
modules/desktop/case/purchased/lcd_panel.stl
modules/desktop/fab/mech/display_window.stl
