CopperPilot/desktop-computer-retro/modules/desktop/fab/compact-cm5-desktop-schematic.pdf

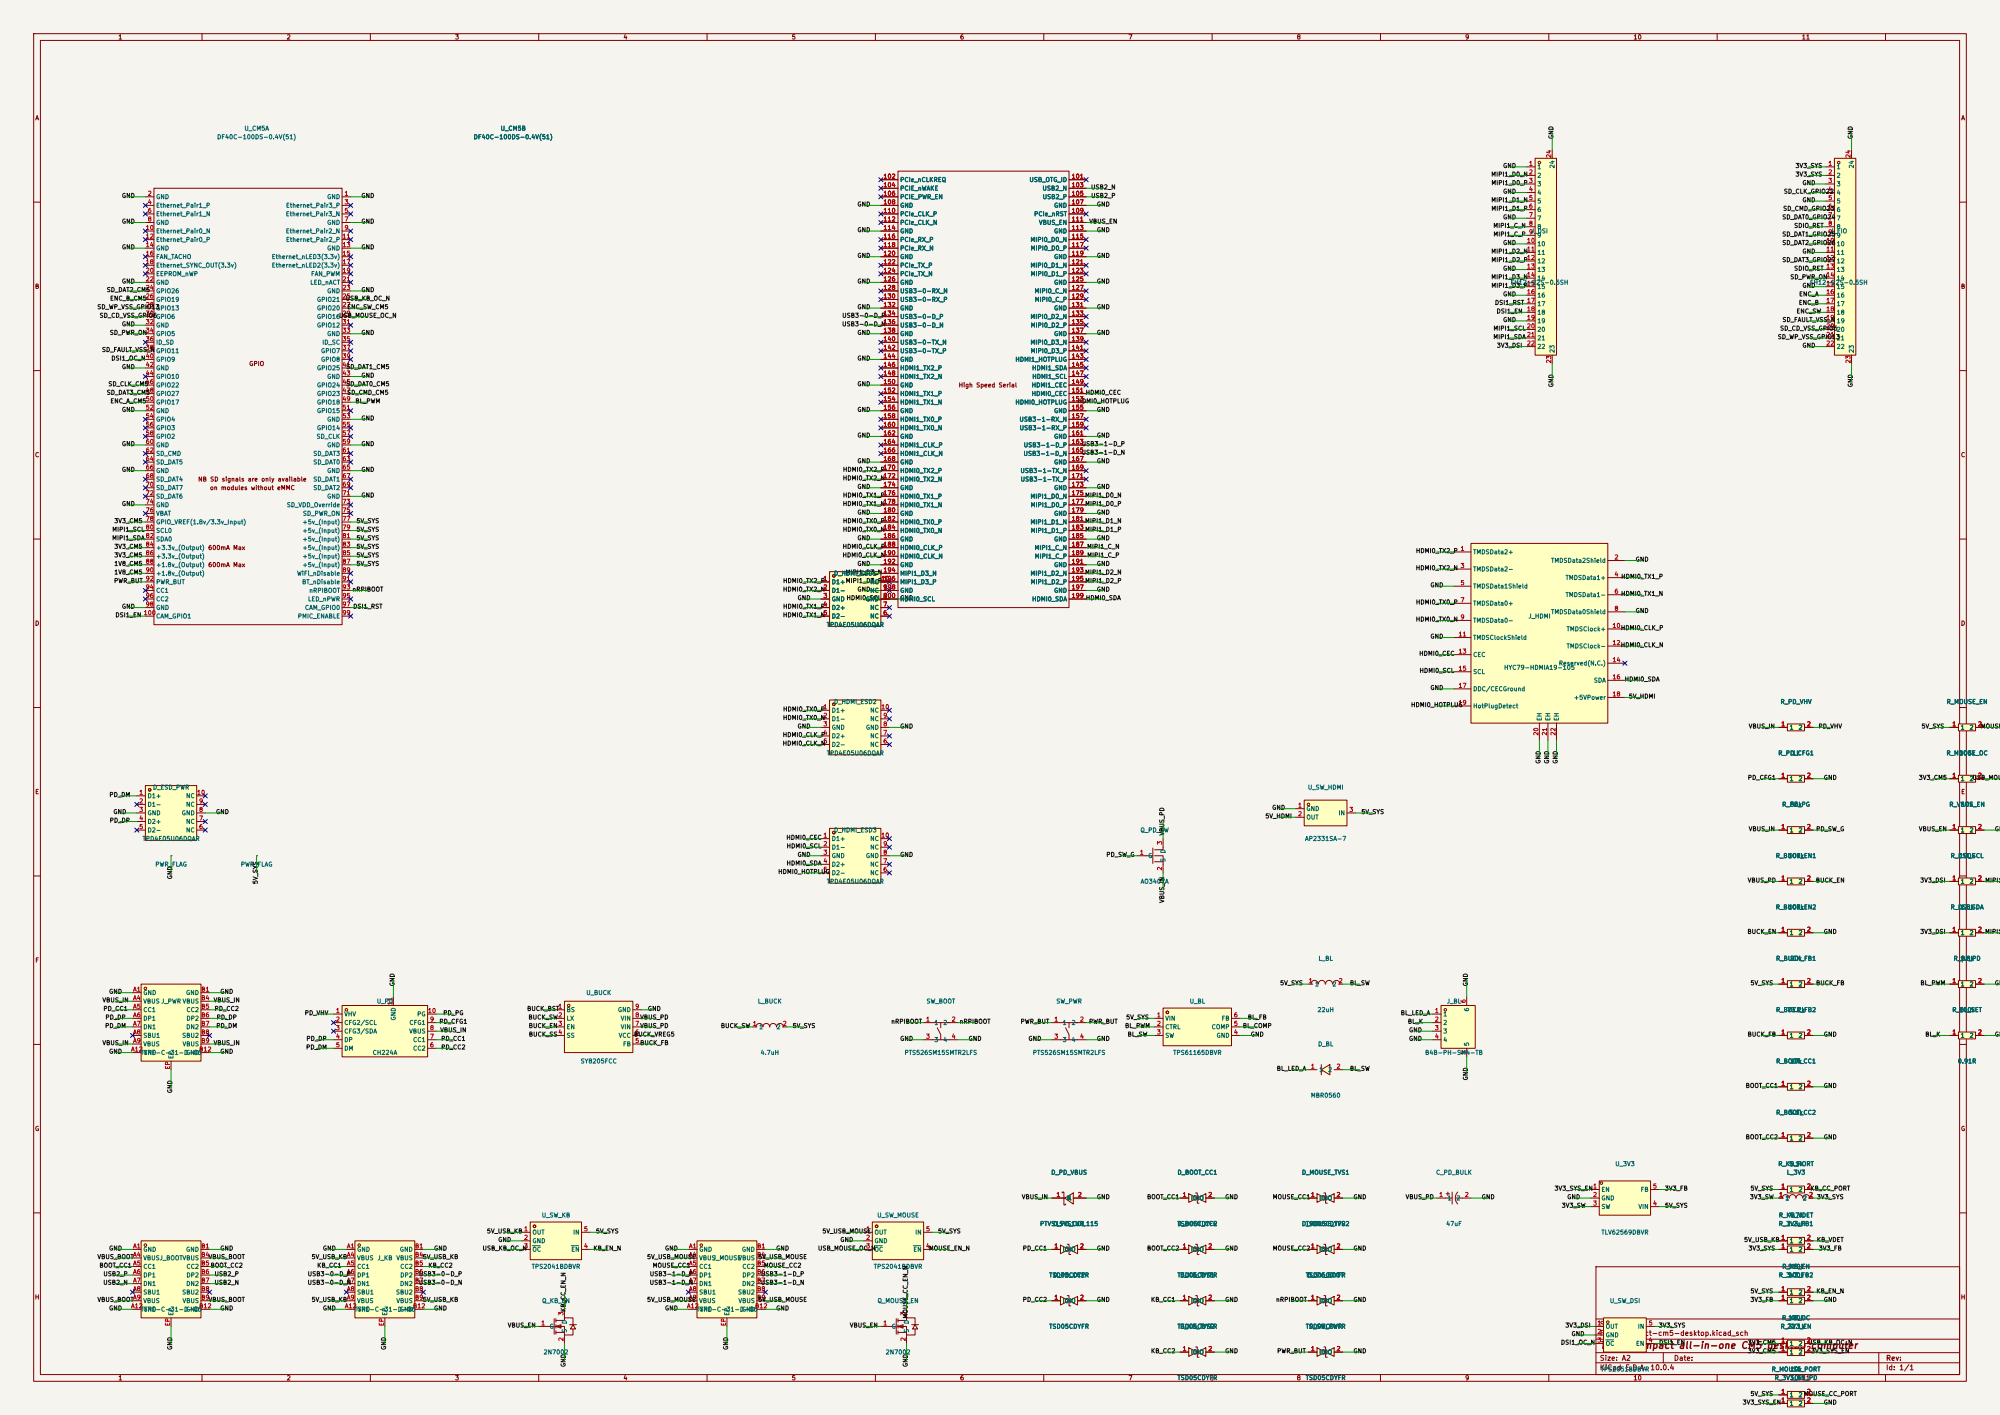
[picture p34: page 1]

600mA Max 600mA Max NB SD signals are only available on modules without eMMC

Sheet: / 2 File: compact-cm5-desktop.kicad_sch | OUT 1 GND IN OC | 5 U_SW_DSI TPS2051BDBVR 2 R_KB_OC 3V3_SYS 22.1k 2 R_3V3_EN 2 R_3V3_EN

3 Title: Compact all-in-one CM5 desktop computer | EN | 4 1 1 3V3_CM5 1 1 | 1 2 2 | USB_KB_OC_N
Size: A2 | 10k 1 | Rev:

KiCad E.D.A. 10.0.4 | | Id: 1/1
