CopperPilot/desktop-computer-retro/modules/keyboard/fab/compact-58key-keyboard-schematic.pdf

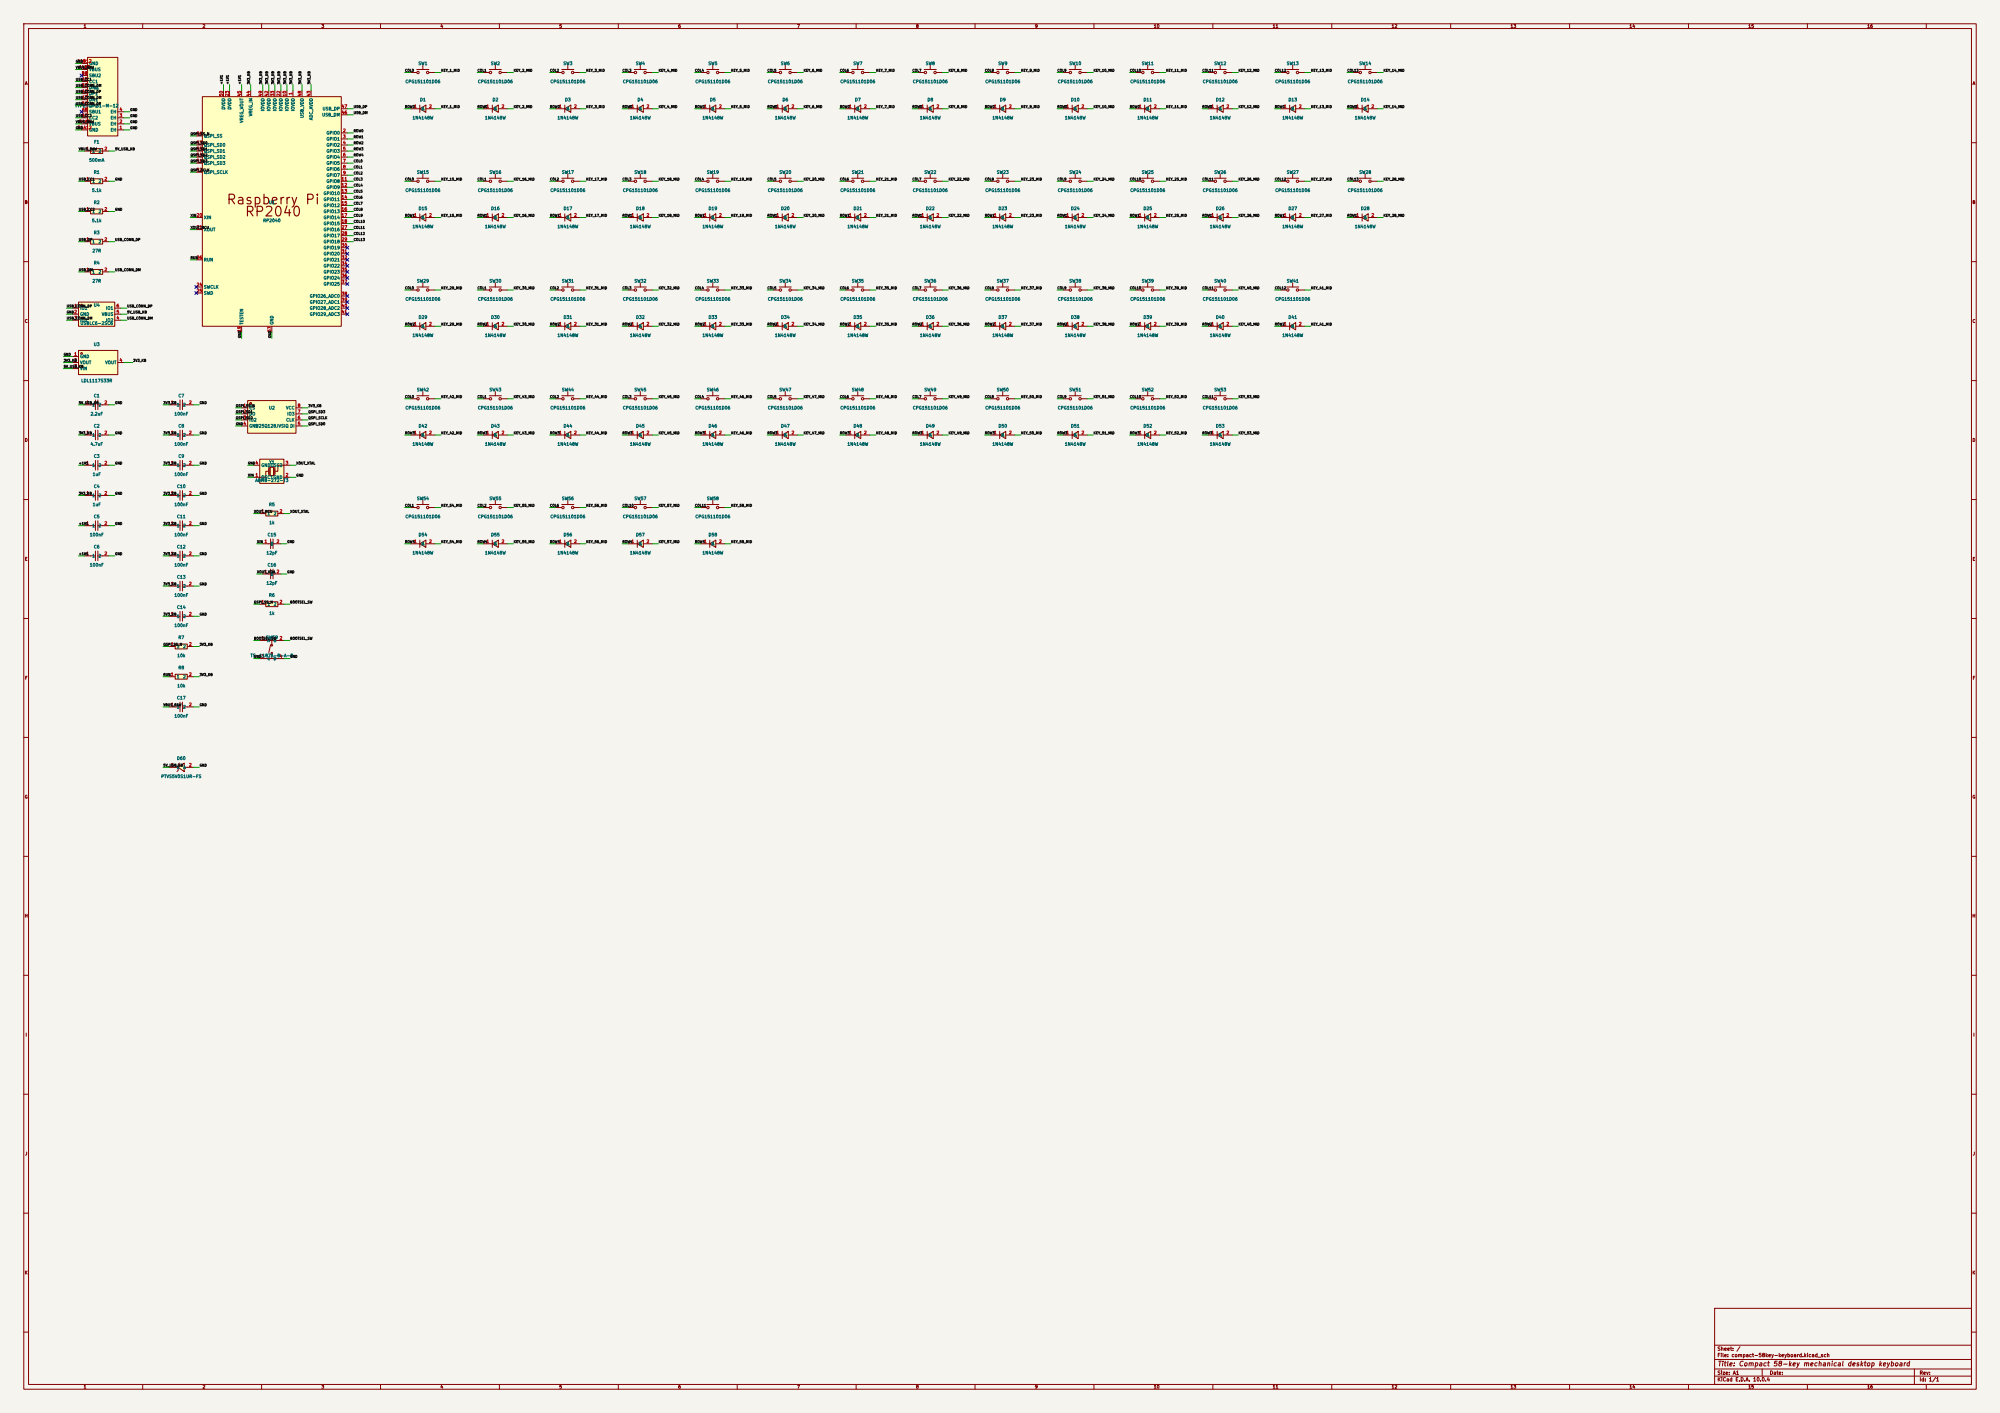
[picture p35: page 1]

Sheet: /
File: compact-58key-keyboard.kicad_sch
Title: Compact 58-key mechanical desktop keyboard

Size: A1 | Rev:
KiCad E.D.A. 10.0.4 | Id: 1/1
