CopperPilot/desktop-computer-retro/modules/mouse/fab/mouse-schematic.pdf

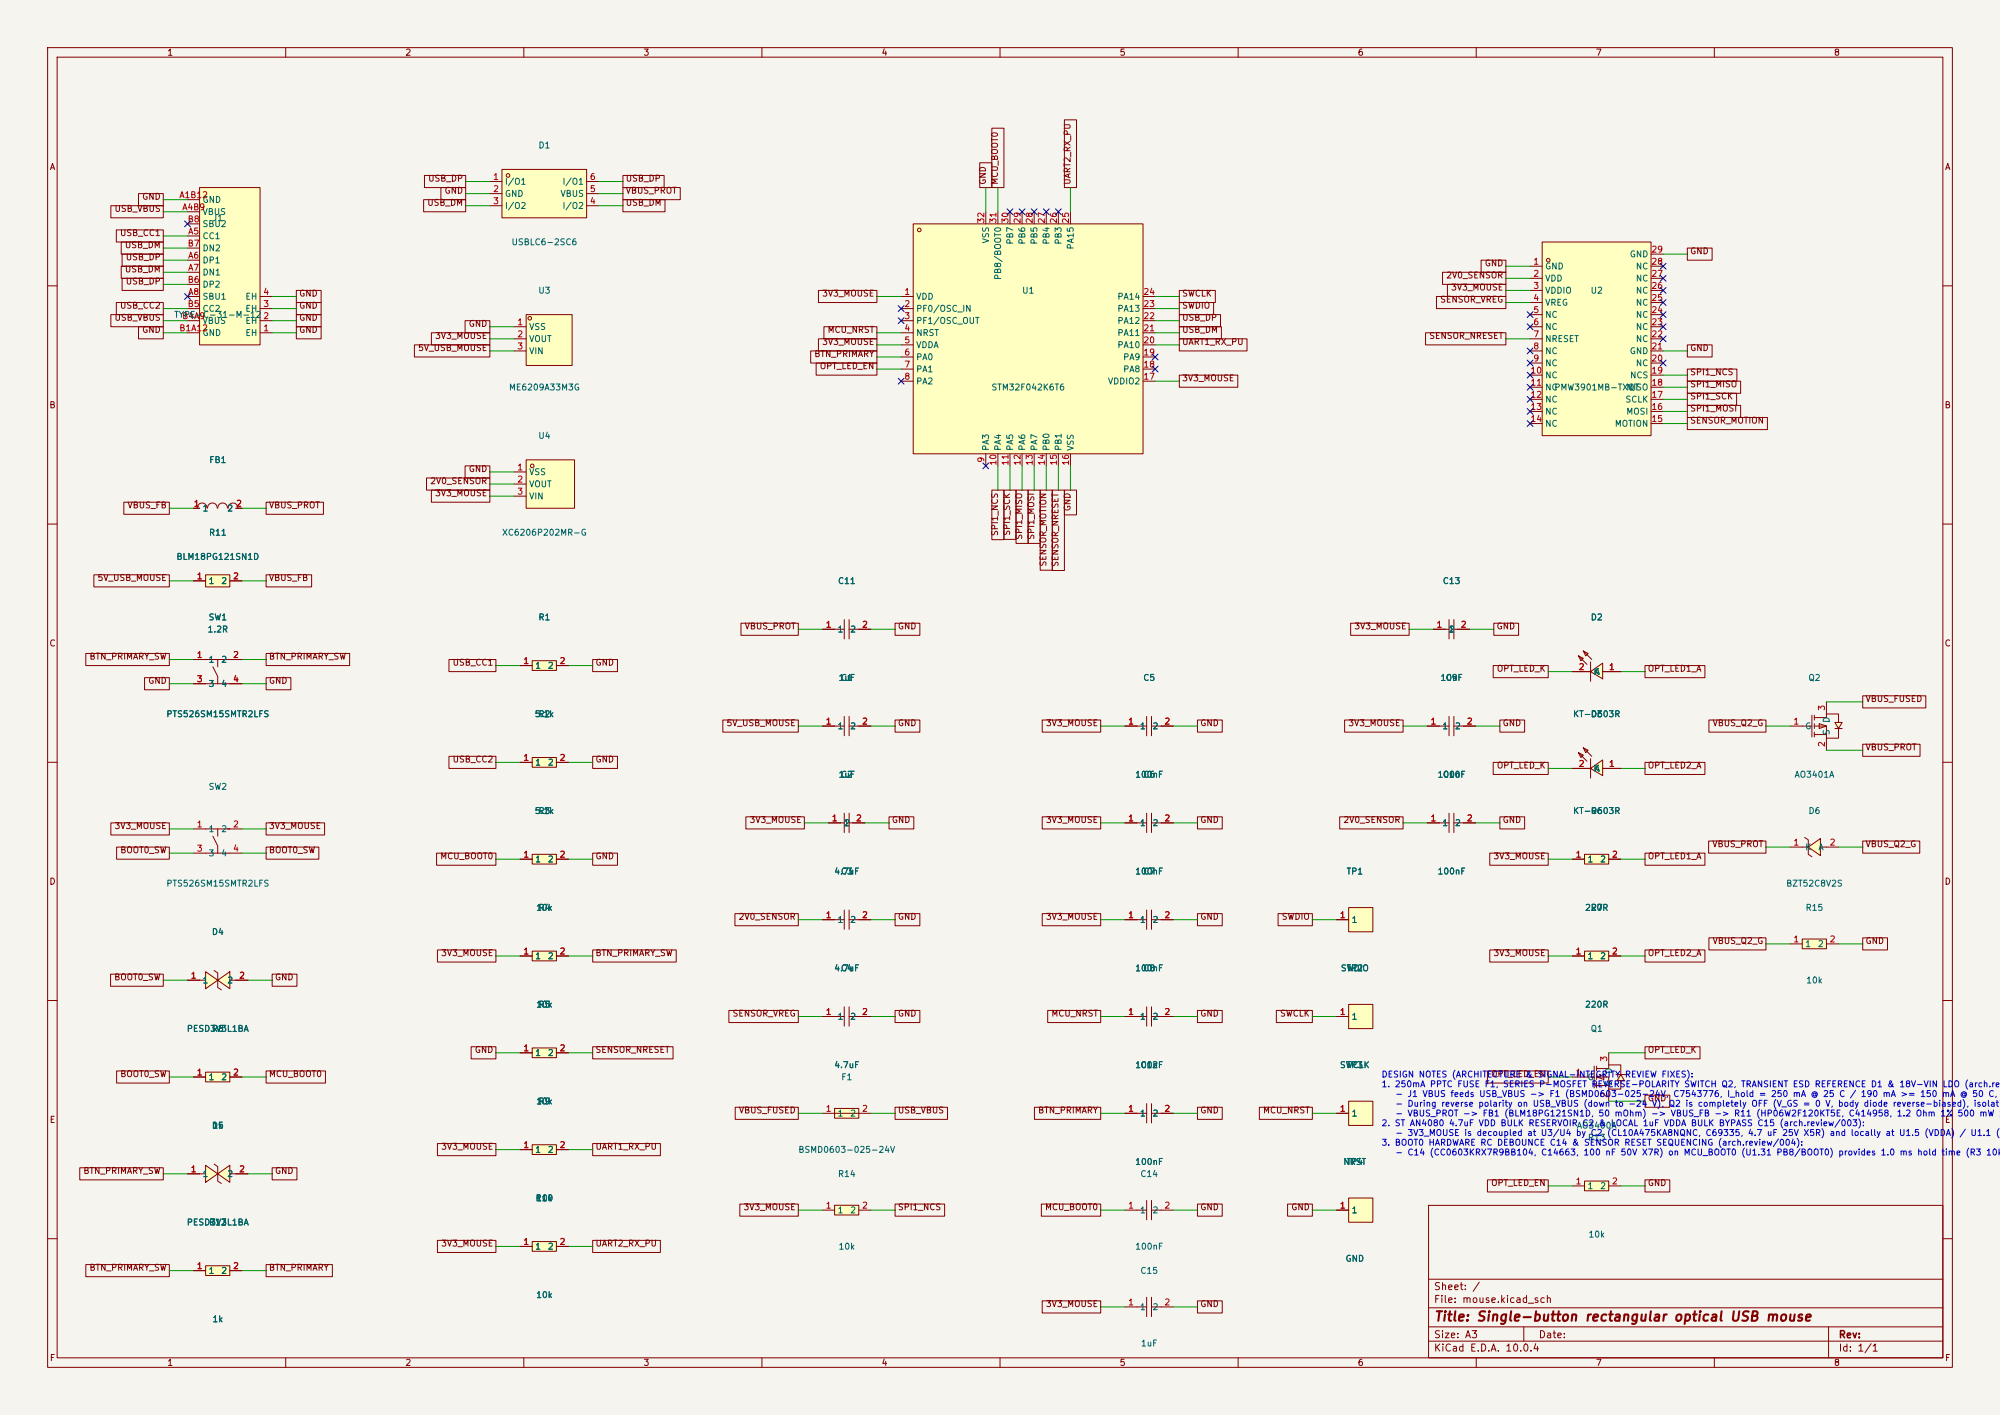
[picture p36: page 1]

Sheet: /
File: mouse.kicad_sch
Title: Single-button rectangular optical USB mouse

Size: A3 | Rev:
KiCad E.D.A. 10.0.4 | Id: 1/1 | F Date:
