CopperPilot/desktop-computer-retro/modules/desktop/hardware/front_io/compact-cm5-desktop-front_io.kicad_pcb

## KiCad design modules/desktop/hardware/front_io/compact-cm5-desktop-front_io.kicad_pcb (2026-11-03)

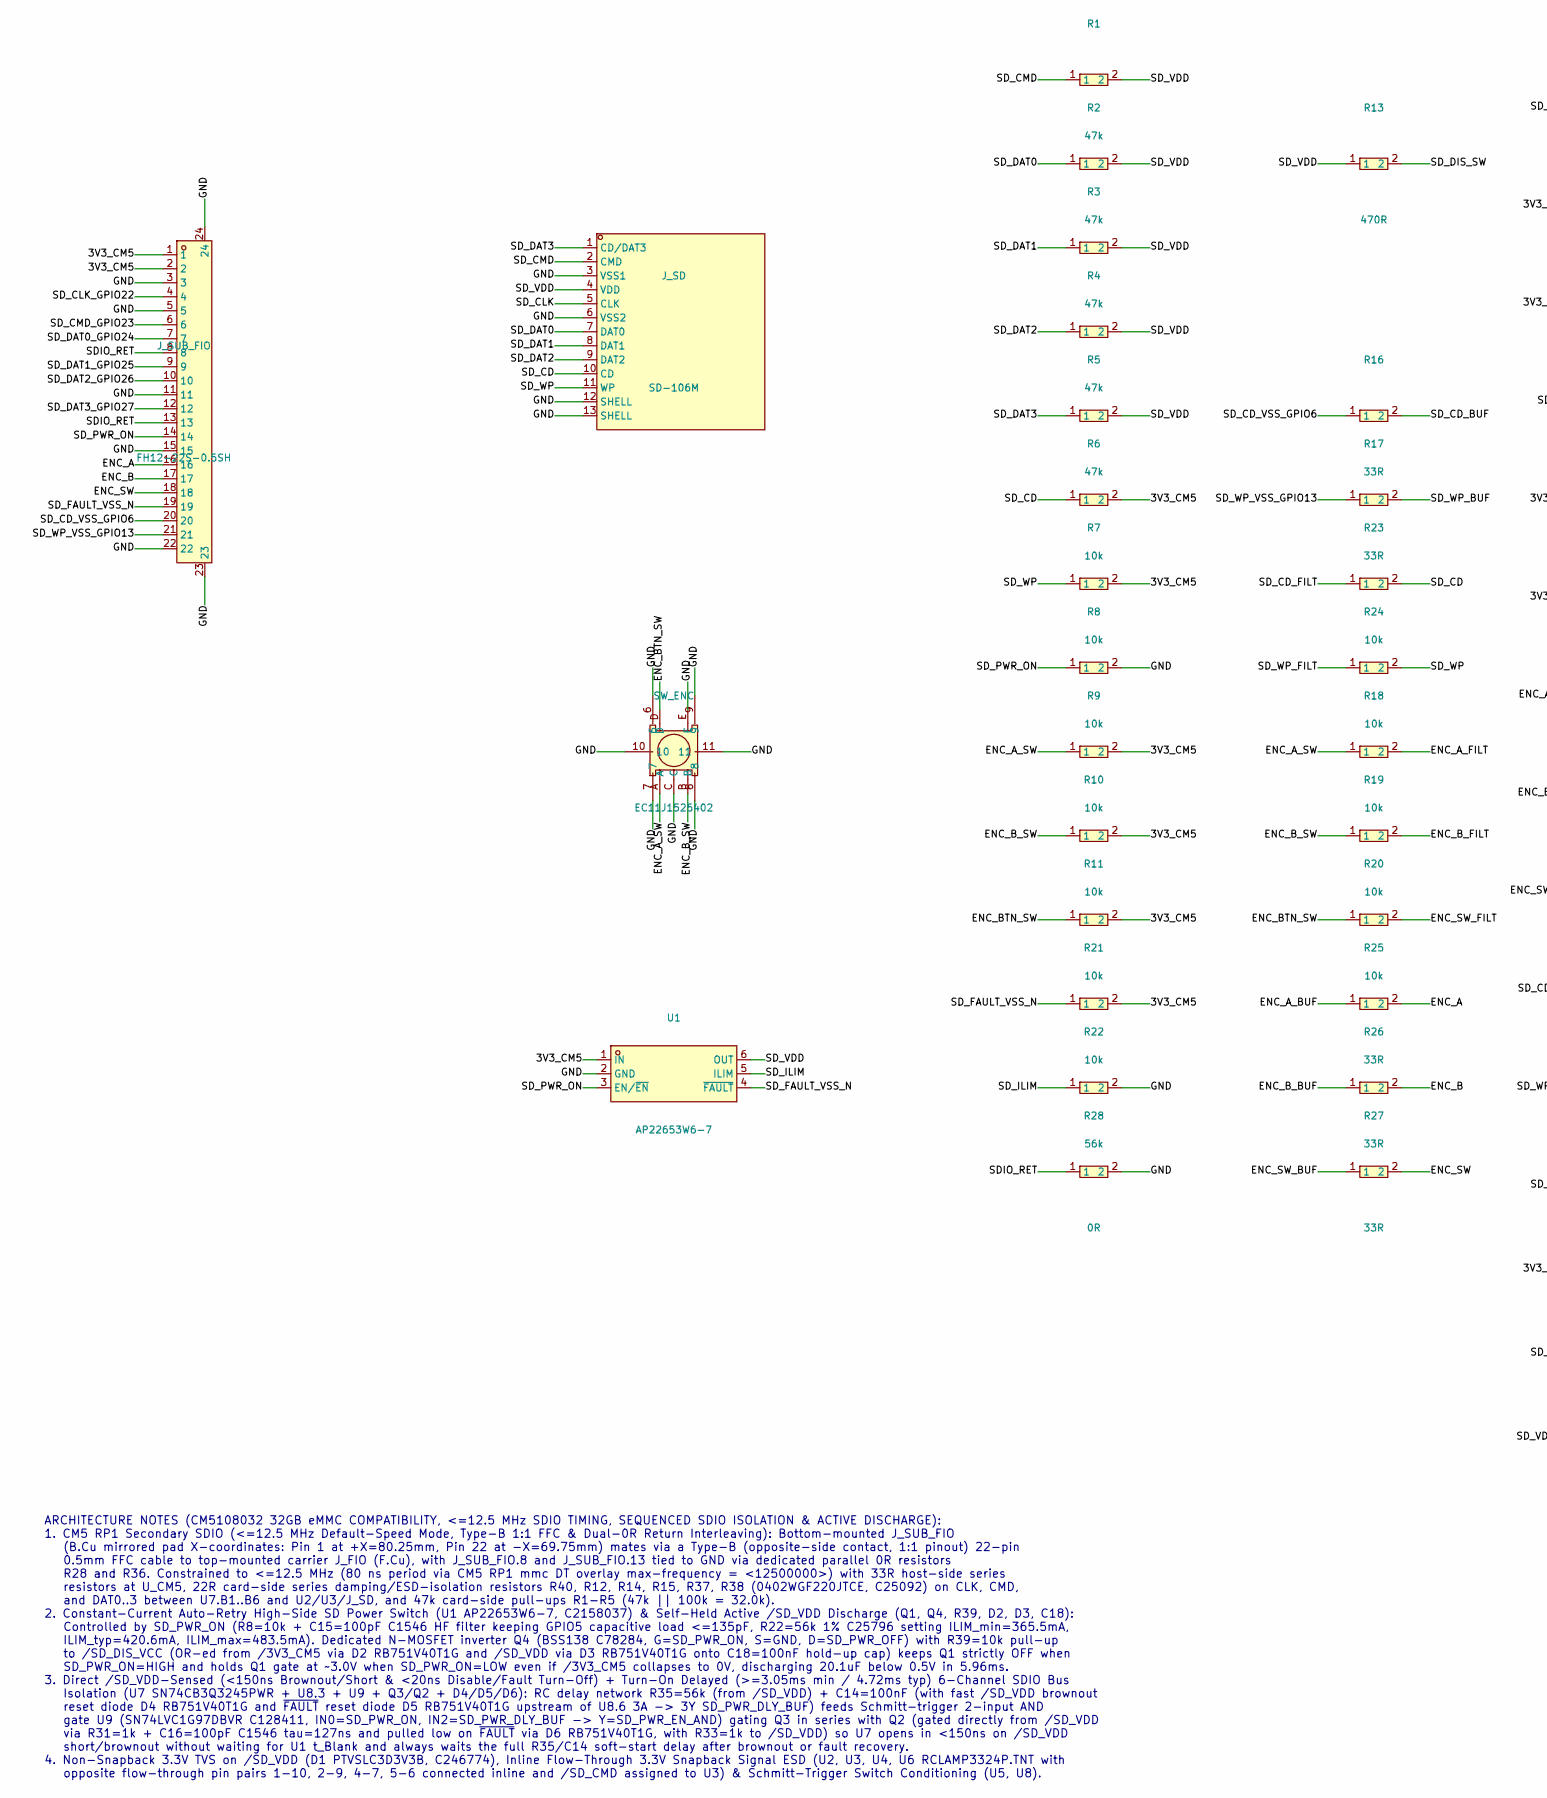
[picture p38: schematic compact-cm5-desktop-front_io.kicad_sch, Compact all-in-one CM5 desktop computer - Front I/O Sub-boa…, part in row 1, column 1]

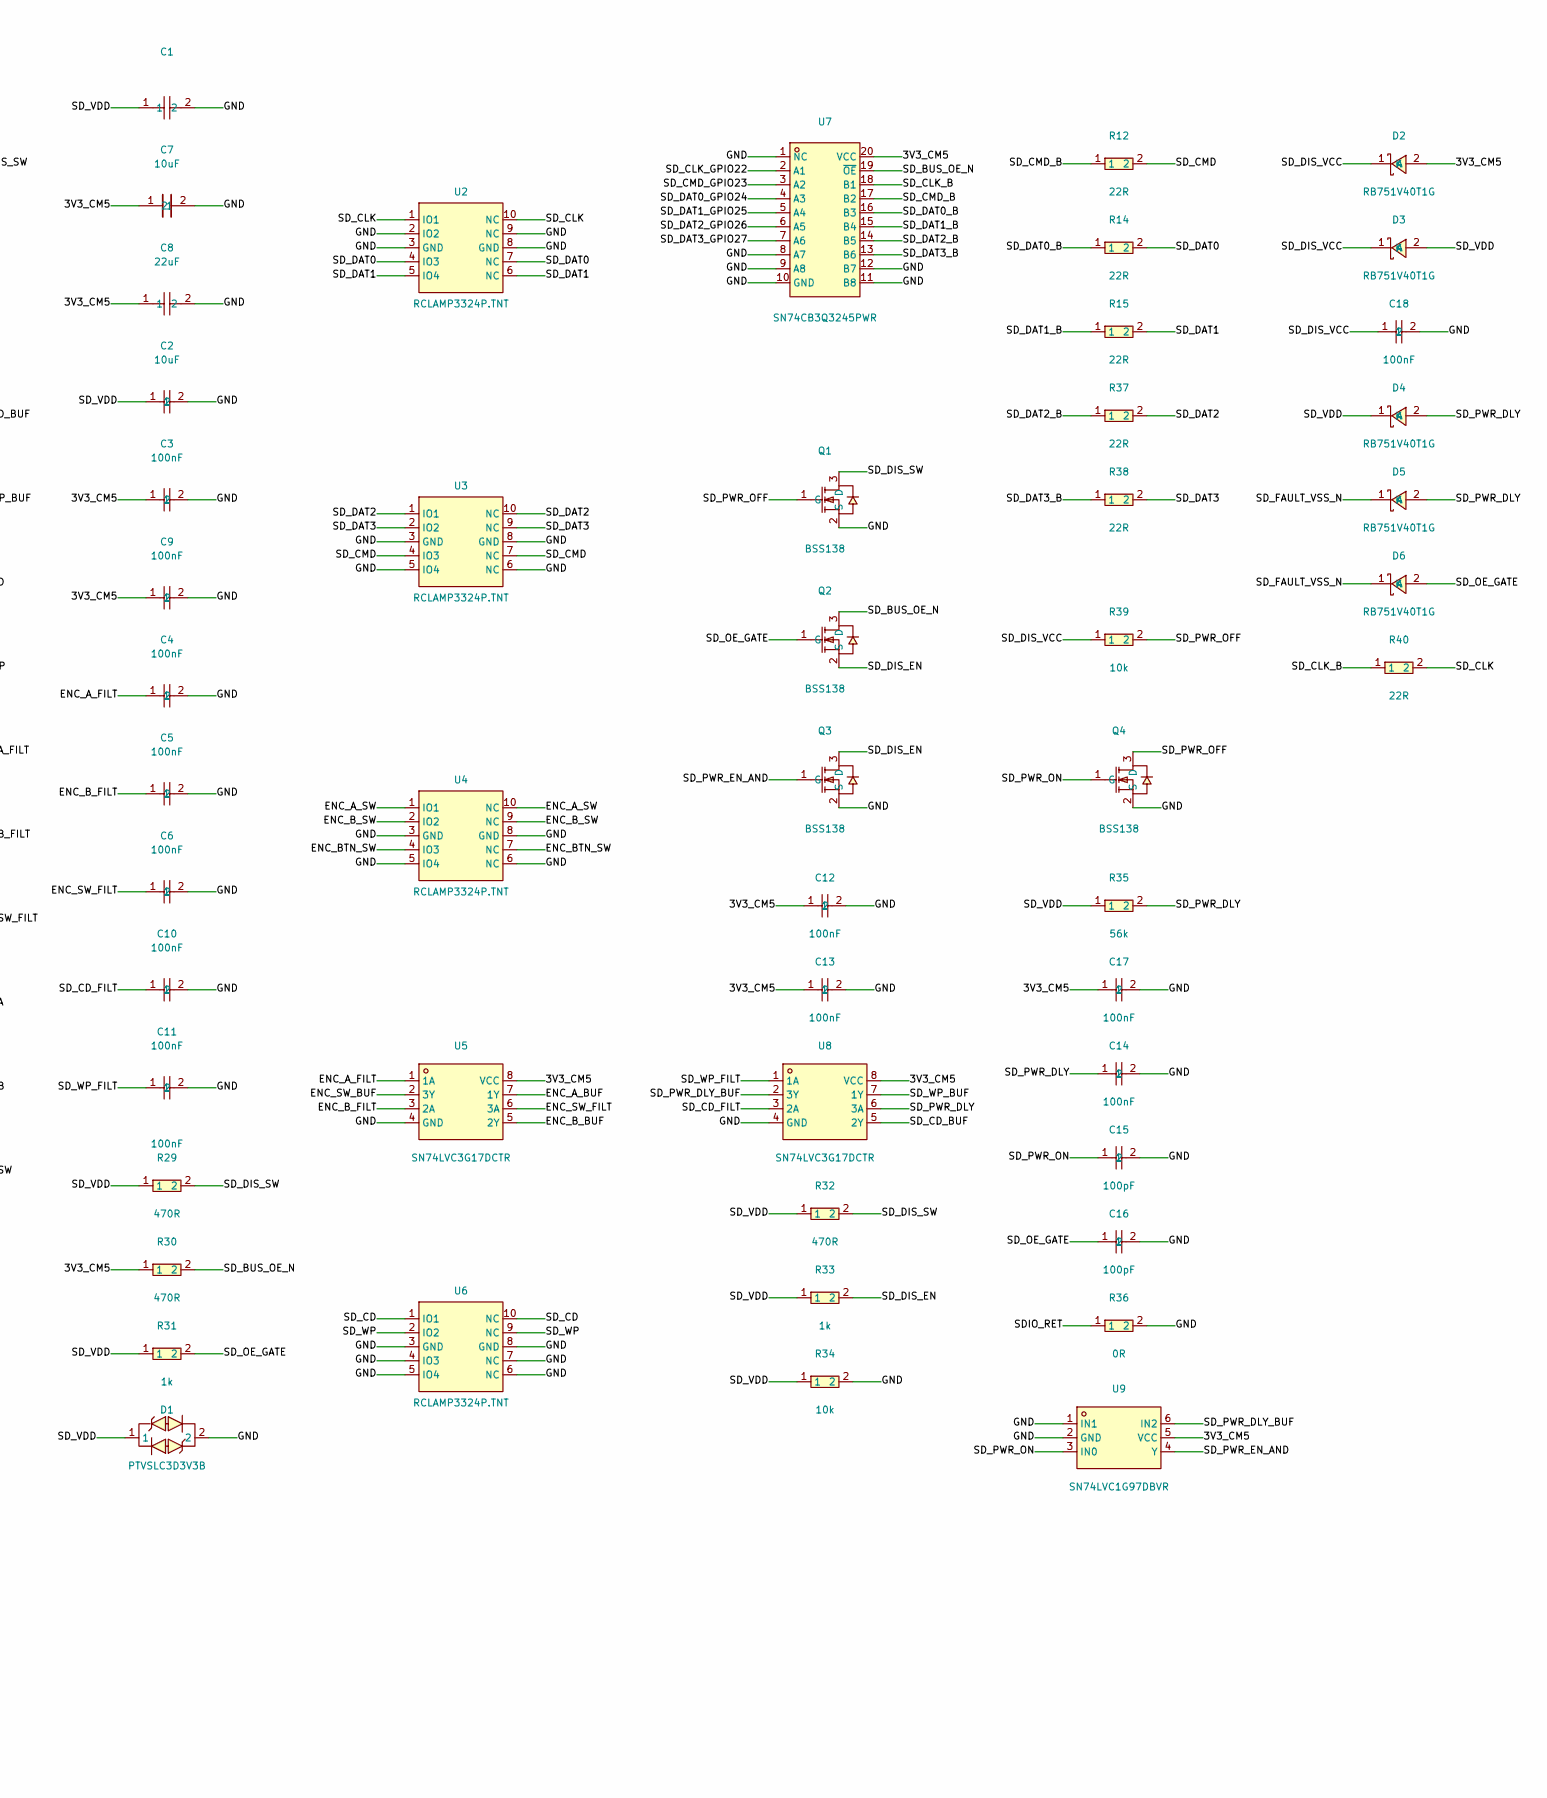
[picture p39: schematic compact-cm5-desktop-front_io.kicad_sch, Compact all-in-one CM5 desktop computer - Front I/O Sub-boa…, part in row 1, column 2]

Parts:
C1, C8: 10uF; C0603; MPN CM105X5R106M25AT; LCSC C3038124
C2, C3, C4, C5, C6, C9, C10, C11, C12, C13, C14, C17, C18: 100nF; C0402; MPN CC0402KRX7R9BB104; LCSC C131394
C7: 22uF; C0805; MPN CL21A226MAQNNNE; LCSC C45783
C15, C16: 100pF; C0402; MPN 0402CG101J500NT; LCSC C1546
D1: PTVSLC3D3V3B; SOD-323_L1.8-W1.3-LS2.5-BI; MPN PTVSLC3D3V3B; LCSC C246774
D2, D3, D4, D5, D6: RB751V40T1G; SOD-323_L1.8-W1.3-LS2.5-RD; MPN RB751V40T1G; LCSC C154819
J_SD: SD-106M; SD-SMD_SD-106M; MPN SD-106M; LCSC C266603
J_SUB_FIO: FH12-22S-0.5SH; FPC-SMD_22P-P0.50_FH12-22S-0.5SH-55; MPN FH12-22S-0.5SH(55); LCSC C597981
Q1, Q2, Q3, Q4: BSS138; SOT-23-3_L2.9-W1.3-P1.90-LS2.4-BR; MPN BSS138; LCSC C78284
R1, R2, R3, R4, R5: 47k; R0402; MPN 0402WGF4702TCE; LCSC C25792
R6, R7, R8, R9, R10, R11, R18, R19, R20, R21, R23, R24, R34, R39: 10k; R0402; MPN 0402WGF1002TCE; LCSC C25744
R12, R14, R15, R37, R38, R40: 22R; R0402; MPN 0402WGF220JTCE; LCSC C25092
R13, R29, R30, R32: 470R; R0402; MPN 0402WGF4700TCE; LCSC C25117
R16, R17, R25, R26, R27: 33R; R0402; MPN 0402WGF330JTCE; LCSC C25105
R22, R35: 56k; R0402; MPN 0402WGF5602TCE; LCSC C25796
R28, R36: 0R; R0402; MPN 0402WGF0000TCE; LCSC C17168
R31, R33: 1k; R0402; MPN 0402WGF1001TCE; LCSC C11702
SW_ENC: EC11J1525402; SW-SMD_EC11J1525402; MPN EC11J1525402; LCSC C209762
U1: AP22653W6-7; SOT-23-6_L2.9-W1.6-P0.95-LS2.8-BR; MPN AP22653W6-7; LCSC C2158037
U2, U3, U4, U6: RCLAMP3324P.TNT; DFN2510-10_L2.5-W1.0-P0.50-BL; MPN RCLAMP3324P.TNT; LCSC C1976652
U5, U8: SN74LVC3G17DCTR; MSOP-8_L2.9-W2.8-P0.65-LS4.0-BL; MPN SN74LVC3G17DCTR; LCSC C18213
U7: SN74CB3Q3245PWR; TSSOP-20_L6.5-W4.4-P0.65-LS6.4-BL; MPN SN74CB3Q3245PWR; LCSC C470961
U9: SN74LVC1G97DBVR; SOT-23-6_L2.9-W1.6-P0.95-LS2.8-BR; MPN SN74LVC1G97DBVR; LCSC C128411

Connections:
/3V3_CM5: C3.1, C7.1, C8.1, C9.1, C12.1, C13.1, C17.1, D2.2 (A), J_SUB_FIO.1, J_SUB_FIO.2, R6.2, R7.2, R9.2, R10.2, R11.2, R21.2, R30.1, U1.1 (IN), U5.8 (VCC), U7.20 (VCC), U8.8 (VCC), U9.5 (VCC)
/ENC_A: J_SUB_FIO.16, R25.2
/ENC_A_BUF: R25.1, U5.7 (1Y)
/ENC_A_FILT: C4.1, R18.2, U5.1 (1A)
/ENC_A_SW: R9.1, R18.1, SW_ENC.A, U4.1 (IO1), U4.10 (NC)
/ENC_B: J_SUB_FIO.17, R26.2
/ENC_BTN_SW: R11.1, R20.1, SW_ENC.D, U4.4 (IO3), U4.7 (NC)
/ENC_B_BUF: R26.1, U5.5 (2Y)
/ENC_B_FILT: C5.1, R19.2, U5.3 (2A)
/ENC_B_SW: R10.1, R19.1, SW_ENC.B, U4.2 (IO2), U4.9 (NC)
/ENC_SW: J_SUB_FIO.18, R27.2
/ENC_SW_BUF: R27.1, U5.2 (3Y)
/ENC_SW_FILT: C6.1, R20.2, U5.6 (3A)
/GND: C1.2, C2.2, C3.2, C4.2, C5.2, C6.2, C7.2, C8.2, C9.2, C10.2, C11.2, C12.2, C13.2, C14.2, C15.2, C16.2, C17.2, C18.2, D1.2, J_SD.3 (VSS1), J_SD.6 (VSS2), J_SD.12 (SHELL), J_SD.13 (SHELL), J_SUB_FIO.3, J_SUB_FIO.5, J_SUB_FIO.11, J_SUB_FIO.15, J_SUB_FIO.22, J_SUB_FIO.23, J_SUB_FIO.24, Q1.2 (S), Q3.2 (S), Q4.2 (S), R8.2, R22.2, R28.2, R34.2, R36.2, SW_ENC.6, SW_ENC.7, SW_ENC.8, SW_ENC.9, SW_ENC.10, SW_ENC.11, SW_ENC.C, SW_ENC.E, U1.2 (GND), U2.2 (IO2), U2.3 (GND), U2.8 (GND), U2.9 (NC), U3.3 (GND), U3.5 (IO4), U3.6 (NC), U3.8 (GND), U4.3 (GND), U4.5 (IO4), U4.6 (NC), U4.8 (GND), U5.4 (GND), U6.3 (GND), U6.4 (IO3), U6.5 (IO4), U6.6 (NC), U6.7 (NC), U6.8 (GND), U7.1 (NC), U7.8 (A7), U7.9 (A8), U7.10 (GND), U7.11 (B8), U7.12 (B7), U8.4 (GND), U9.1 (IN1), U9.2 (GND)
/SDIO_RET: J_SUB_FIO.8, J_SUB_FIO.13, R28.1, R36.1
/SD_BUS_OE_N: Q2.3 (D), R30.2, U7.19 (~OE)
/SD_CD: J_SD.10 (CD), R6.1, R23.2, U6.1 (IO1), U6.10 (NC)
/SD_CD_BUF: R16.2, U8.5 (2Y)
/SD_CD_FILT: C10.1, R23.1, U8.3 (2A)
/SD_CD_VSS_GPIO6: J_SUB_FIO.20, R16.1
/SD_CLK: J_SD.5 (CLK), R40.2, U2.1 (IO1), U2.10 (NC)
/SD_CLK_B: R40.1, U7.18 (B1)
/SD_CLK_GPIO22: J_SUB_FIO.4, U7.2 (A1)
/SD_CMD: J_SD.2 (CMD), R1.1, R12.2, U3.4 (IO3), U3.7 (NC)
/SD_CMD_B: R12.1, U7.17 (B2)
/SD_CMD_GPIO23: J_SUB_FIO.6, U7.3 (A2)
/SD_DAT0: J_SD.7 (DAT0), R2.1, R14.2, U2.4 (IO3), U2.7 (NC)
/SD_DAT0_B: R14.1, U7.16 (B3)
/SD_DAT0_GPIO24: J_SUB_FIO.7, U7.4 (A3)
/SD_DAT1: J_SD.8 (DAT1), R3.1, R15.2, U2.5 (IO4), U2.6 (NC)
/SD_DAT1_B: R15.1, U7.15 (B4)
/SD_DAT1_GPIO25: J_SUB_FIO.9, U7.5 (A4)
/SD_DAT2: J_SD.9 (DAT2), R4.1, R37.2, U3.1 (IO1), U3.10 (NC)
/SD_DAT2_B: R37.1, U7.14 (B5)
/SD_DAT2_GPIO26: J_SUB_FIO.10, U7.6 (A5)
/SD_DAT3: J_SD.1 (CD/DAT3), R5.1, R38.2, U3.2 (IO2), U3.9 (NC)
/SD_DAT3_B: R38.1, U7.13 (B6)
/SD_DAT3_GPIO27: J_SUB_FIO.12, U7.7 (A6)
/SD_DIS_EN: Q2.2 (S), Q3.3 (D), R33.2
/SD_DIS_SW: Q1.3 (D), R13.2, R29.2, R32.2
/SD_DIS_VCC: C18.1, D2.1 (K), D3.1 (K), R39.1
/SD_FAULT_VSS_N: D5.1 (K), D6.1 (K), J_SUB_FIO.19, R21.1, U1.4 (~FAULT)
/SD_ILIM: R22.1, U1.5 (ILIM)
/SD_OE_GATE: C16.1, D6.2 (A), Q2.1 (G), R31.2
/SD_PWR_DLY: C14.1, D4.2 (A), D5.2 (A), R35.2, U8.6 (3A)
/SD_PWR_DLY_BUF: U8.2 (3Y), U9.6 (IN2)
/SD_PWR_EN_AND: Q3.1 (G), U9.4 (Y)
/SD_PWR_OFF: Q1.1 (G), Q4.3 (D), R39.2
/SD_PWR_ON: C15.1, J_SUB_FIO.14, Q4.1 (G), R8.1, U1.3 (EN/~EN), U9.3 (IN0)
/SD_VDD: C1.1, C2.1, D1.1, D3.2 (A), D4.1 (K), J_SD.4 (VDD), R1.2, R2.2, R3.2, R4.2, R5.2, R13.1, R29.1, R31.1, R32.1, R33.1, R34.1, R35.1, U1.6 (OUT)
/SD_WP: J_SD.11 (WP), R7.1, R24.2, U6.2 (IO2), U6.9 (NC)
/SD_WP_BUF: R17.2, U8.7 (1Y)
/SD_WP_FILT: C11.1, R24.1, U8.1 (1A)
/SD_WP_VSS_GPIO13: J_SUB_FIO.21, R17.1

Notes on the sheet:
ARCHITECTURE NOTES (CM5108032 32GB eMMC COMPATIBILITY, <=12.5 MHz SDIO TIMING, SEQUENCED SDIO ISOLATION & ACTIVE DISCHARGE): 1. CM5 RP1 Secondary SDIO (<=12.5 MHz Default-Speed Mode, Type-B 1:1 FFC & Dual-0R Return Interleaving): Bottom-mounted J_SUB_FIO (B.Cu mirrored pad X-coordinates: Pin 1 at +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

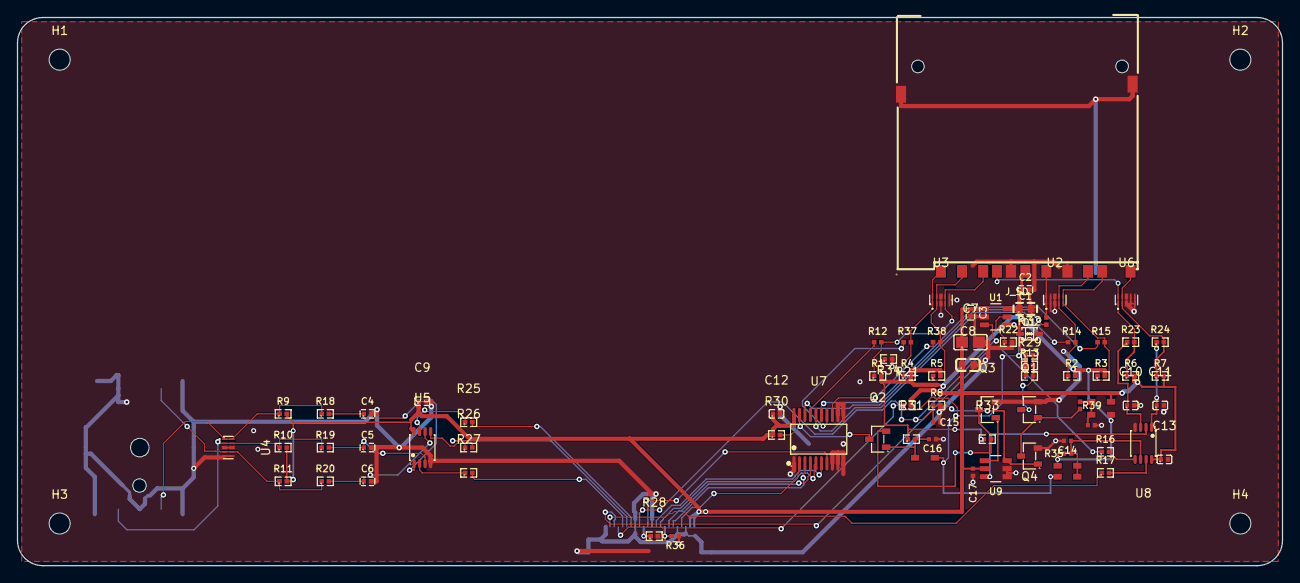
[picture p40: board compact-cm5-desktop-front_io.kicad_pcb from above]

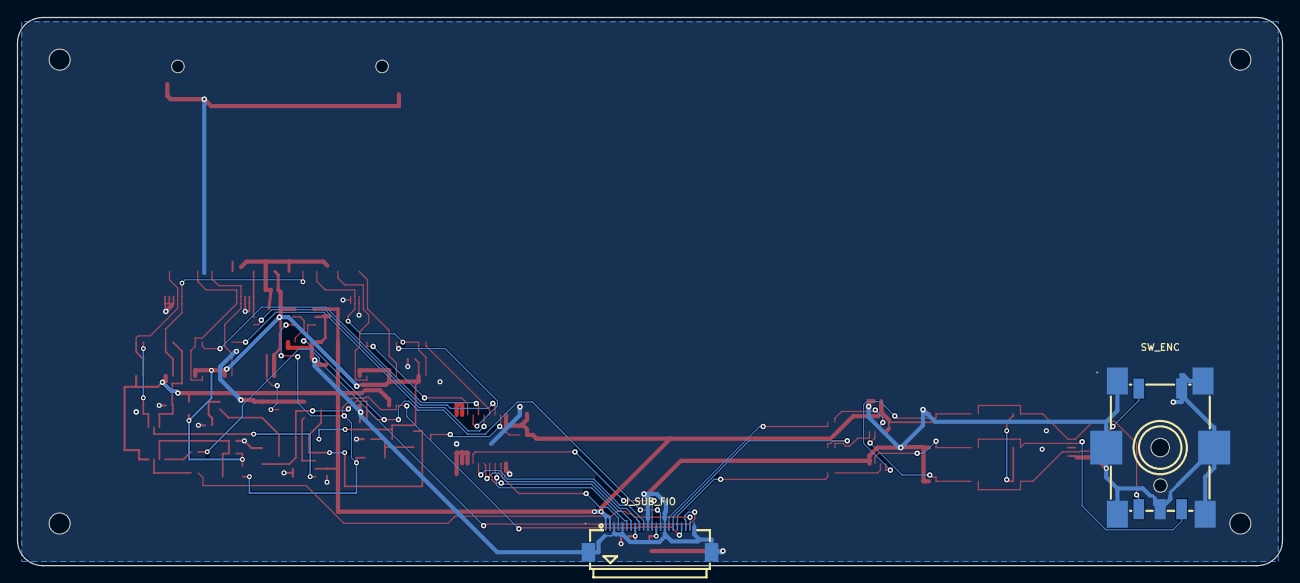
[picture p41: board compact-cm5-desktop-front_io.kicad_pcb from below]

Board: 2 copper layers, 150.0 x 65.0 mm, 84 parts (2 on the bottom side), 54 nets.

Other parts of the board:
H1, H2, H3, H4: 47k; MountingHole_2.5mm
