CopperPilot/desktop-computer-retro/modules/mouse/hardware/mouse.kicad_pcb

## KiCad design modules/mouse/hardware/mouse.kicad_pcb (2026-11-03)

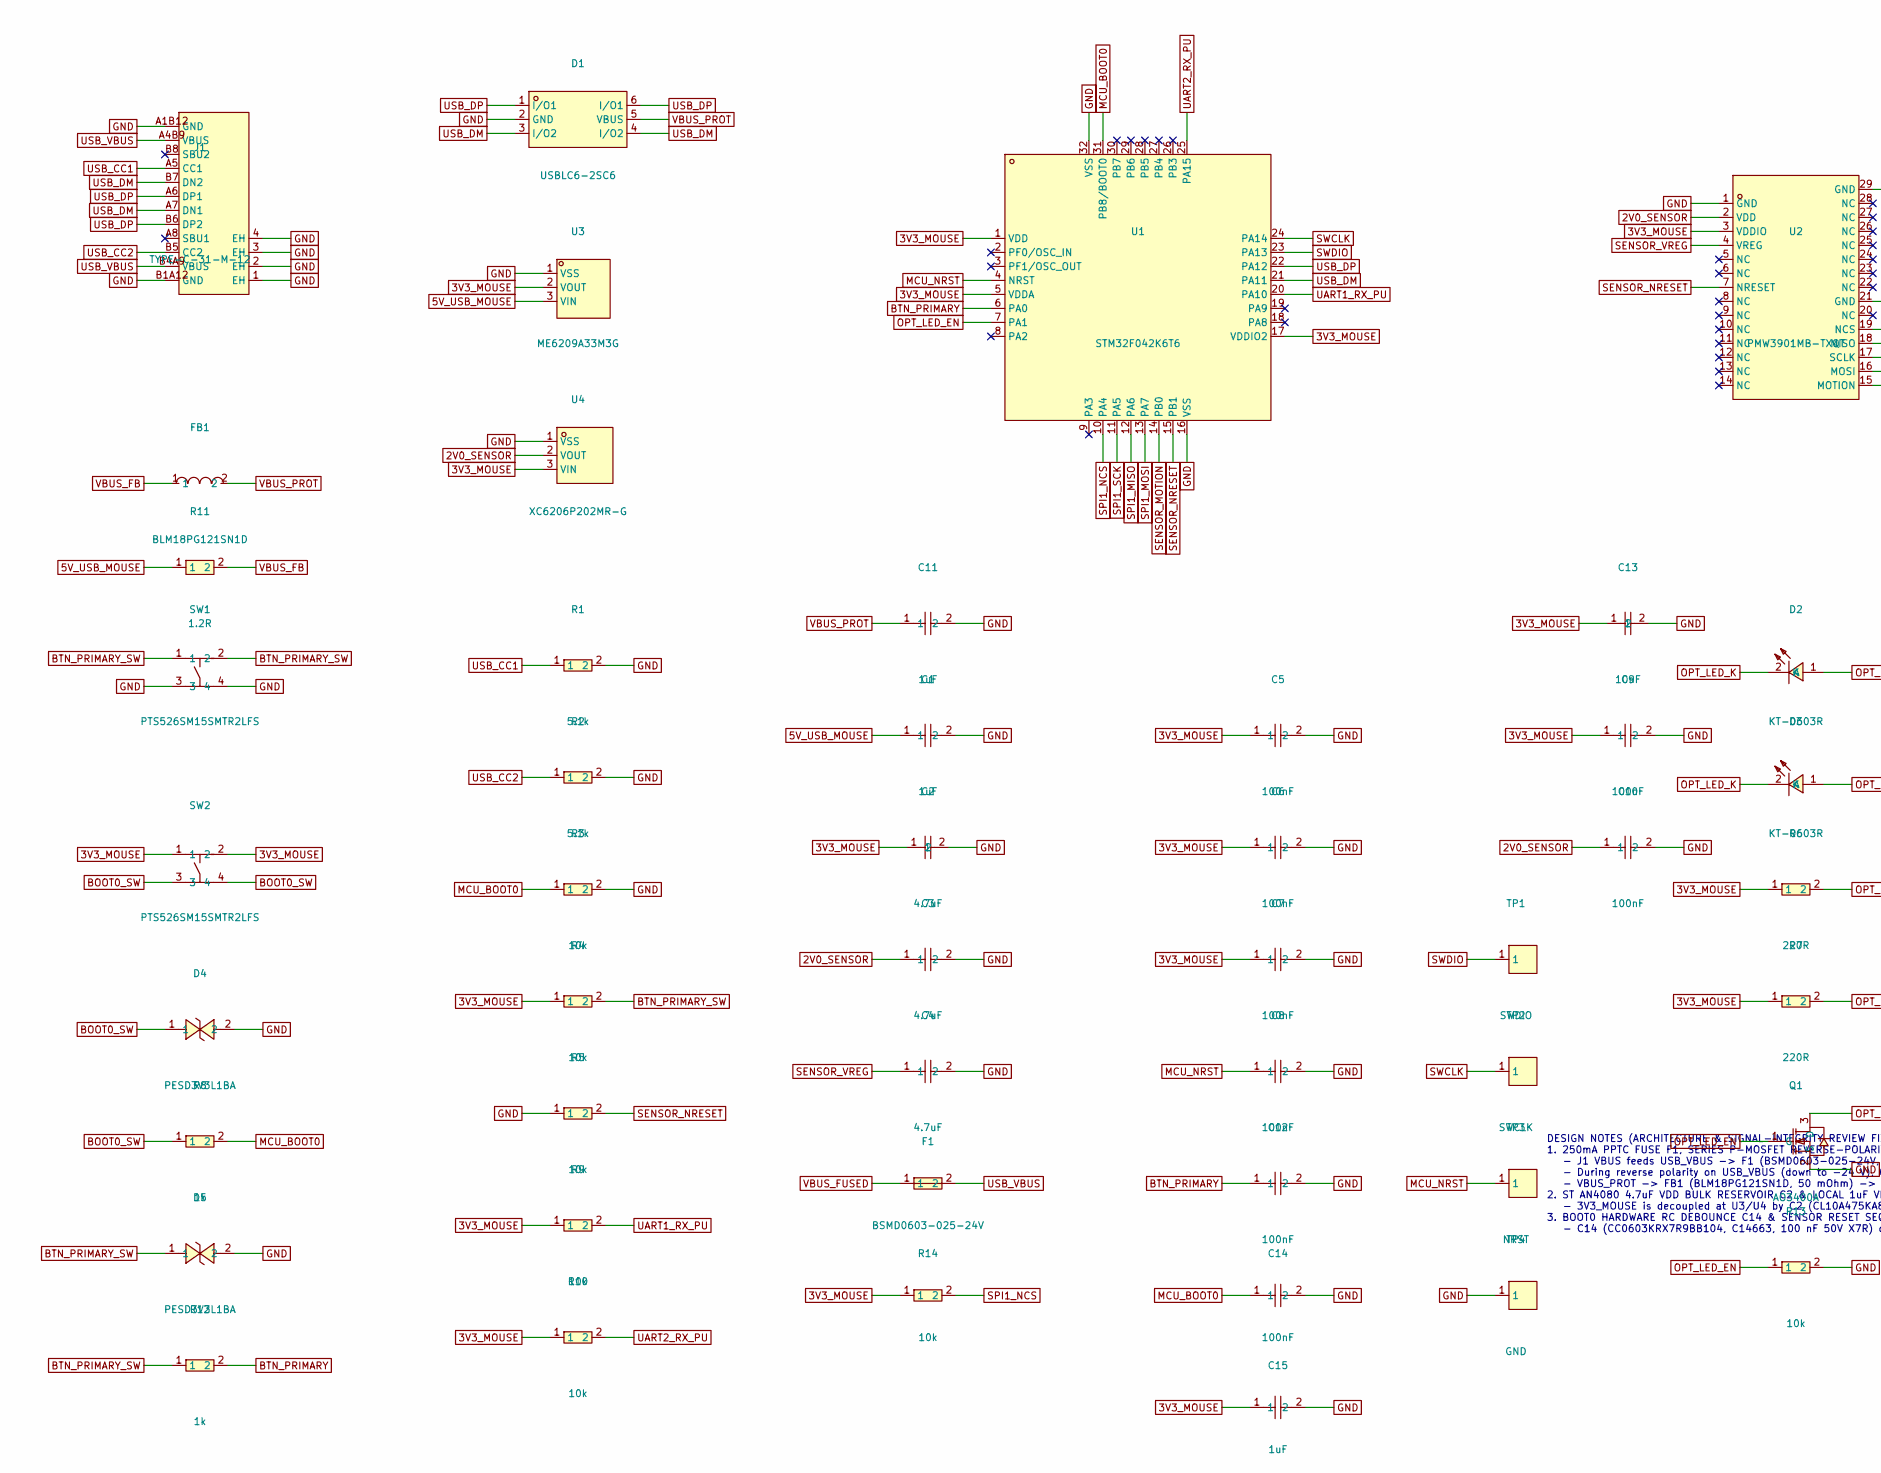
[picture p42: schematic mouse.kicad_sch, Single-button rectangular optical USB mouse, part in row 1, column 1]

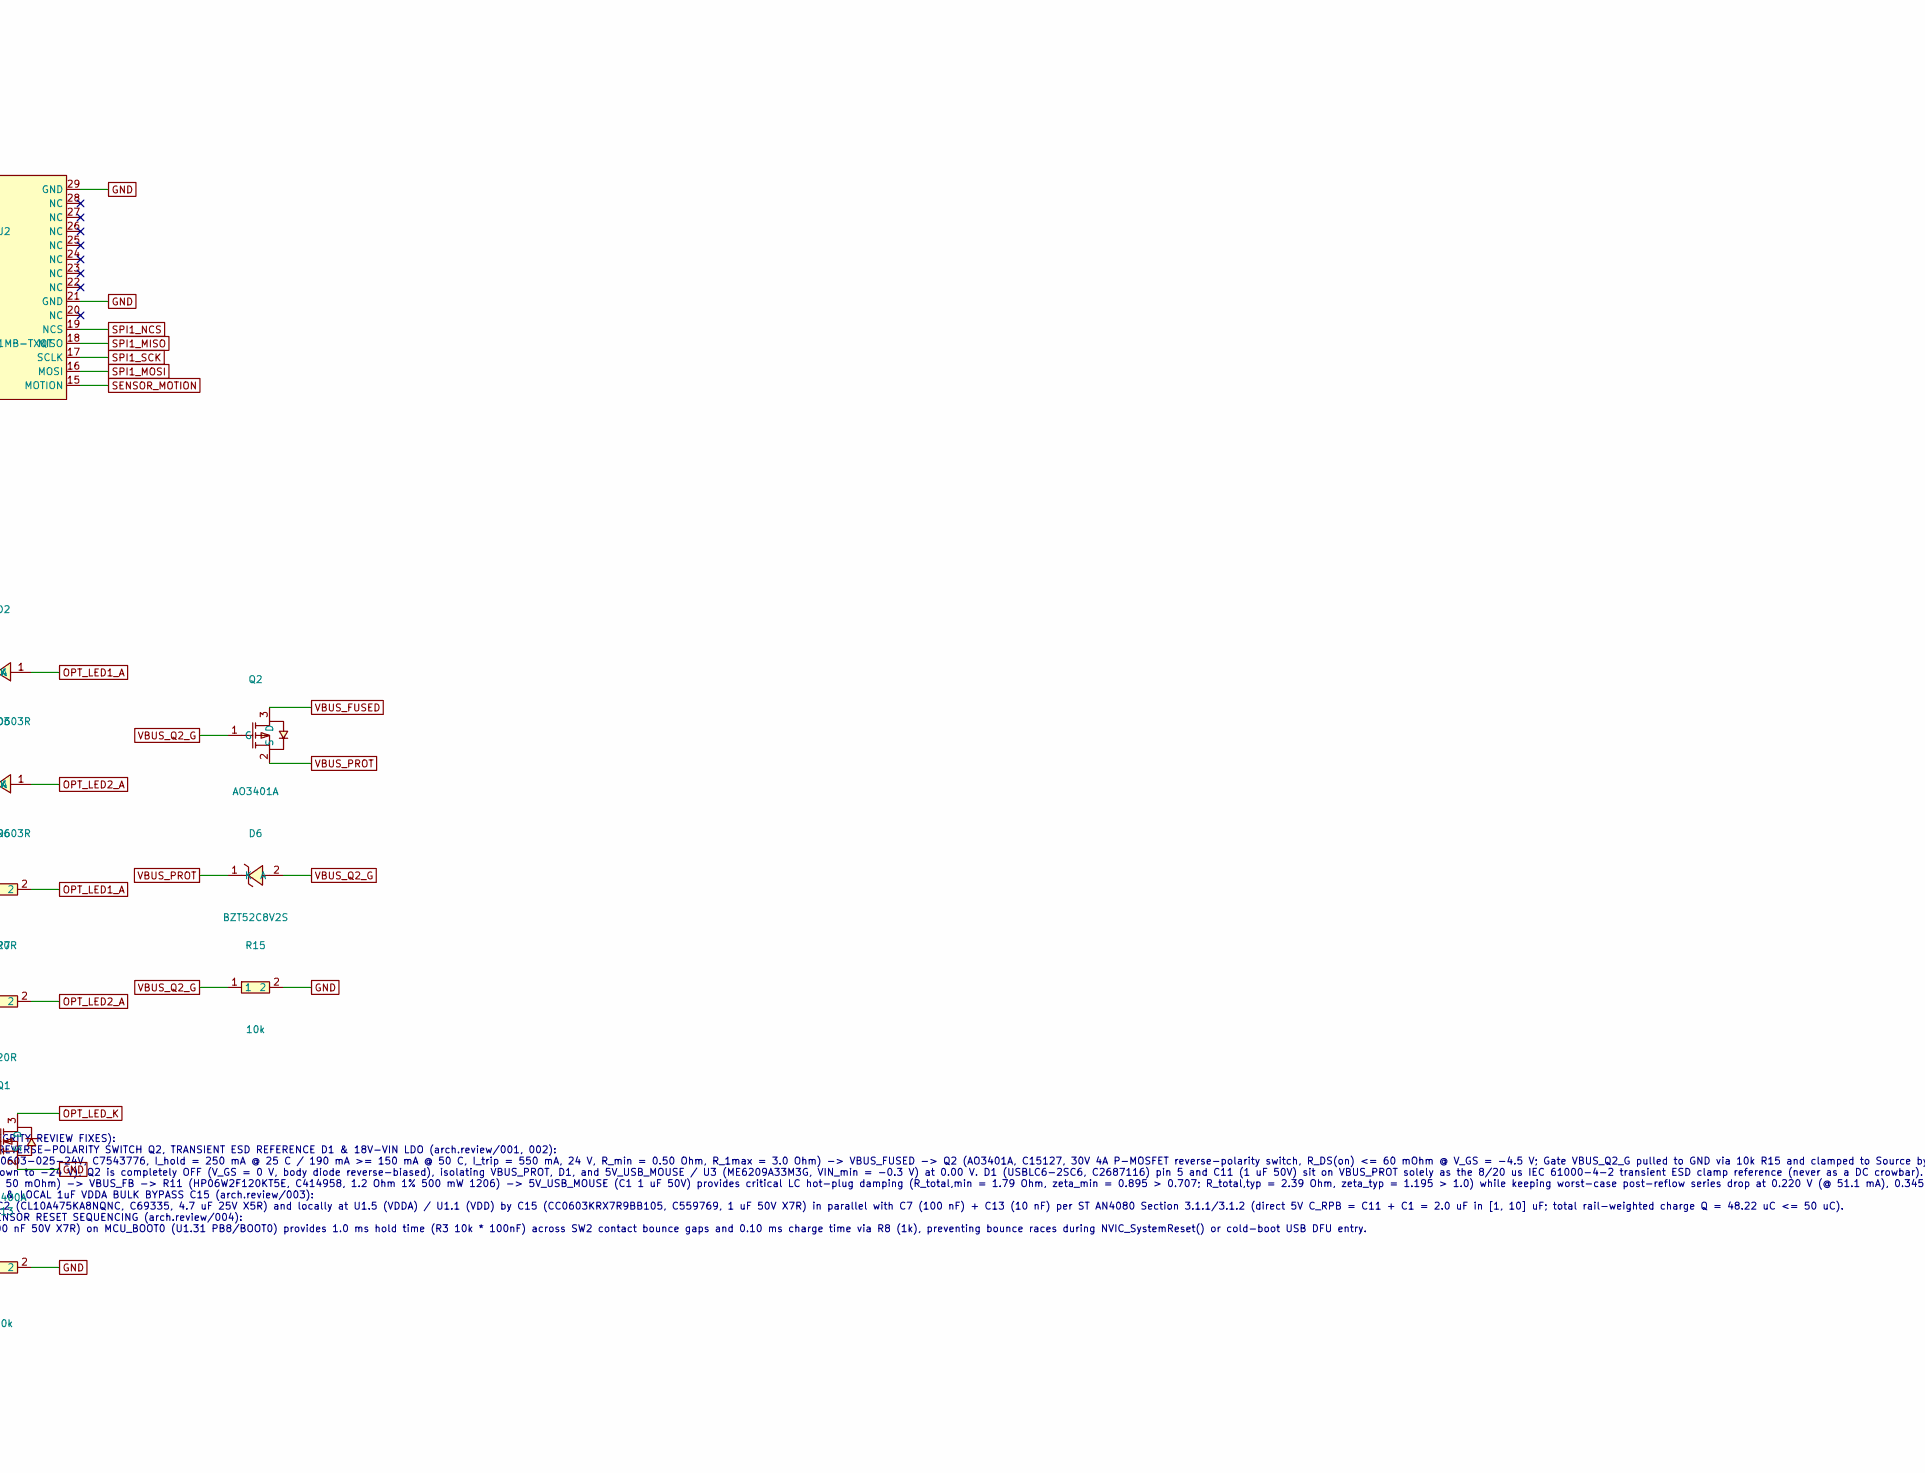
[picture p43: schematic mouse.kicad_sch, Single-button rectangular optical USB mouse, part in row 1, column 2]

Parts:
C1, C11, C15: 1uF; C0603; MPN CC0603KRX7R9BB105; LCSC C559769
C2: 4.7uF; C0603; MPN CL10A475KA8NQNC; LCSC C69335
C3, C4: 4.7uF; C0603; MPN CL10A475KO8NNNC; LCSC C19666
C5, C6, C7, C8, C9, C10, C12, C14: 100nF; C0603; MPN CC0603KRX7R9BB104; LCSC C14663
C13: 10nF; C0603; MPN CC0603KRX7R9BB103; LCSC C100042
D1: USBLC6-2SC6; SOT-23-6_L2.9-W1.6-P0.95-LS2.8-BL; MPN USBLC6-2SC6; LCSC C2687116
D2, D3: KT-0603R; LED-SMD_L1.6-W0.8-R-RD; MPN KT-0603R; LCSC C2286
D4, D5: PESD3V3L1BA; SOD-323_L1.7-W1.3-LS2.6-BI; MPN PESD3V3L1BA; LCSC C2687129
D6: BZT52C8V2S; SOD-323_L1.7-W1.3-LS2.6-RD-1; MPN BZT52C8V2S; LCSC C22375294
F1: BSMD0603-025-24V; F0603; MPN BSMD0603-025-24V; LCSC C7543776
FB1: BLM18PG121SN1D; L0603; MPN BLM18PG121SN1D; LCSC C14709
J1: TYPE-C-31-M-12; USB-C_SMD-TYPE-C-31-M-12_1; MPN TYPE-C-31-M-12; LCSC C165948
Q1: AO3400A; SOT-23-3_L2.9-W1.3-P1.90-LS2.4-BR; MPN AO3400A; LCSC C20917
Q2: AO3401A; SOT-23_L2.9-W1.3-P1.90-LS2.4-BR; MPN AO3401A; LCSC C15127
R1, R2: 5.1k; R0603; MPN 0603WAF5101T5E; LCSC C23186
R3, R4, R5, R9, R10, R13, R14, R15: 10k; R0603; MPN 0603WAF1002T5E; LCSC C25804
R6, R7: 220R; R0603; MPN 0603WAF2200T5E; LCSC C22962
R8, R12: 1k; R0603; MPN 0603WAF1001T5E; LCSC C21190
R11: 1.2R; R1206; MPN HP06W2F120KT5E; LCSC C414958
SW1, SW2: PTS526SM15SMTR2LFS; SW-SMD_4P-L5.2-W5.2-P3.70-LS6.4; MPN PTS526SM15SMTR2LFS; LCSC C2689538
TP1: SWDIO; SMD_RH-5015; MPN RH-5015; LCSC C5199798
TP2: SWCLK; SMD_RH-5015; MPN RH-5015; LCSC C5199798
TP3: NRST; SMD_RH-5015; MPN RH-5015; LCSC C5199798
TP4: GND; SMD_RH-5015; MPN RH-5015; LCSC C5199798
U1: STM32F042K6T6; LQFP-32_L7.0-W7.0-P0.80-LS9.0-BL; MPN STM32F042K6T6; LCSC C69216
U2: PMW3901MB-TXQT; COB-28_L6.0-W6.0-P0.65-TL-EP; MPN PMW3901MB-TXQT; LCSC C43496881
U3: ME6209A33M3G; SOT-23-3_L2.9-W1.6-P1.90-LS2.8-BR; MPN ME6209A33M3G; LCSC C83508
U4: XC6206P202MR-G; SOT-23-3_L2.9-W1.6-P1.90-LS2.8-BR; MPN XC6206P202MR-G; LCSC C2891260

Connections:
2V0_SENSOR: C3.1, C10.1, U2.2 (VDD), U4.2 (VOUT)
3V3_MOUSE: C2.1, C5.1, C6.1, C7.1, C9.1, C13.1, C15.1, R4.1, R6.1, R7.1, R9.1, R10.1, R14.1, SW2.1, SW2.2, U1.1 (VDD), U1.5 (VDDA), U1.17 (VDDIO2), U2.3 (VDDIO), U3.2 (VOUT), U4.3 (VIN)
5V_USB_MOUSE: C1.1, R11.1, U3.3 (VIN)
BOOT0_SW: D4.1, R8.1, SW2.3, SW2.4
BTN_PRIMARY: C12.1, R12.2, U1.6 (PA0)
BTN_PRIMARY_SW: D5.1, R4.2, R12.1, SW1.1, SW1.2
GND: C1.2, C2.2, C3.2, C4.2, C5.2, C6.2, C7.2, C8.2, C9.2, C10.2, C11.2, C12.2, C13.2, C14.2, C15.2, D1.2 (GND), D4.2, D5.2, J1.1 (EH), J1.2 (EH), J1.3 (EH), J1.4 (EH), J1.A1B12 (GND), J1.B1A12 (GND), Q1.2 (S), R1.2, R2.2, R3.2, R5.1, R13.2, R15.2, SW1.3, SW1.4, TP4.1, U1.16 (VSS), U1.32 (VSS), U2.1 (GND), U2.21 (GND), U2.29 (GND), U3.1 (VSS), U4.1 (VSS)
MCU_BOOT0: C14.1, R3.1, R8.2, U1.31 (PB8/BOOT0)
MCU_NRST: C8.1, TP3.1, U1.4 (NRST)
OPT_LED1_A: D2.1 (A), R6.2
OPT_LED2_A: D3.1 (A), R7.2
OPT_LED_EN: Q1.1 (G), R13.1, U1.7 (PA1)
OPT_LED_K: D2.2 (K), D3.2 (K), Q1.3 (D)
SENSOR_MOTION: U1.14 (PB0), U2.15 (MOTION)
SENSOR_NRESET: R5.2, U1.15 (PB1), U2.7 (NRESET)
SENSOR_VREG: C4.1, U2.4 (VREG)
SPI1_MISO: U1.12 (PA6), U2.18 (MISO)
SPI1_MOSI: U1.13 (PA7), U2.16 (MOSI)
SPI1_NCS: R14.2, U1.10 (PA4), U2.19 (NCS)
SPI1_SCK: U1.11 (PA5), U2.17 (SCLK)
SWCLK: TP2.1, U1.24 (PA14)
SWDIO: TP1.1, U1.23 (PA13)
UART1_RX_PU: R9.2, U1.20 (PA10)
UART2_RX_PU: R10.2, U1.25 (PA15)
USB_CC1: J1.A5 (CC1), R1.1
USB_CC2: J1.B5 (CC2), R2.1
USB_DM: D1.3 (I/O2), D1.4 (I/O2), J1.A7 (DN1), J1.B7 (DN2), U1.21 (PA11)
USB_DP: D1.1 (I/O1), D1.6 (I/O1), J1.A6 (DP1), J1.B6 (DP2), U1.22 (PA12)
USB_VBUS: F1.2, J1.A4B9 (VBUS), J1.B4A9 (VBUS)
VBUS_FB: FB1.1, R11.2
VBUS_FUSED: F1.1, Q2.3 (D)
VBUS_PROT: C11.1, D1.5 (VBUS), D6.1 (K), FB1.2, Q2.2 (S)
VBUS_Q2_G: D6.2 (A), Q2.1 (G), R15.1

Notes on the sheet:
DESIGN NOTES (ARCHITECTURE & SIGNAL-INTEGRITY REVIEW FIXES): 1. 250mA PPTC FUSE F1, SERIES P-MOSFET REVERSE-POLARITY SWITCH Q2, TRANSIENT ESD REFERENCE D1 & 18V-VIN LDO (arch.review/001, 002): - J1 VBUS feeds USB_VBUS -> F1 (BSMD0603-025-24V, C7543776, I_hold = 250 mA @ 25 C / 190 mA >= 150 mA @ 50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

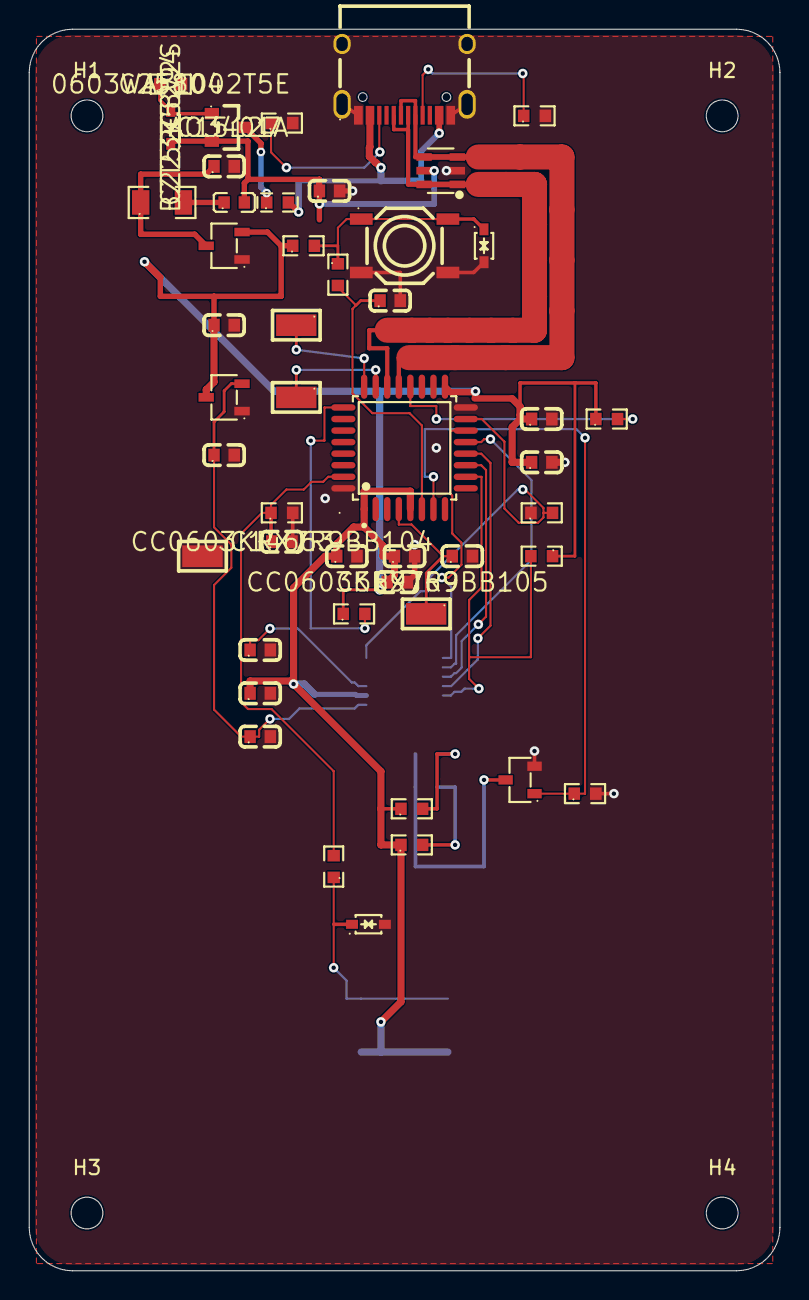
[picture p44: board mouse.kicad_pcb from above]

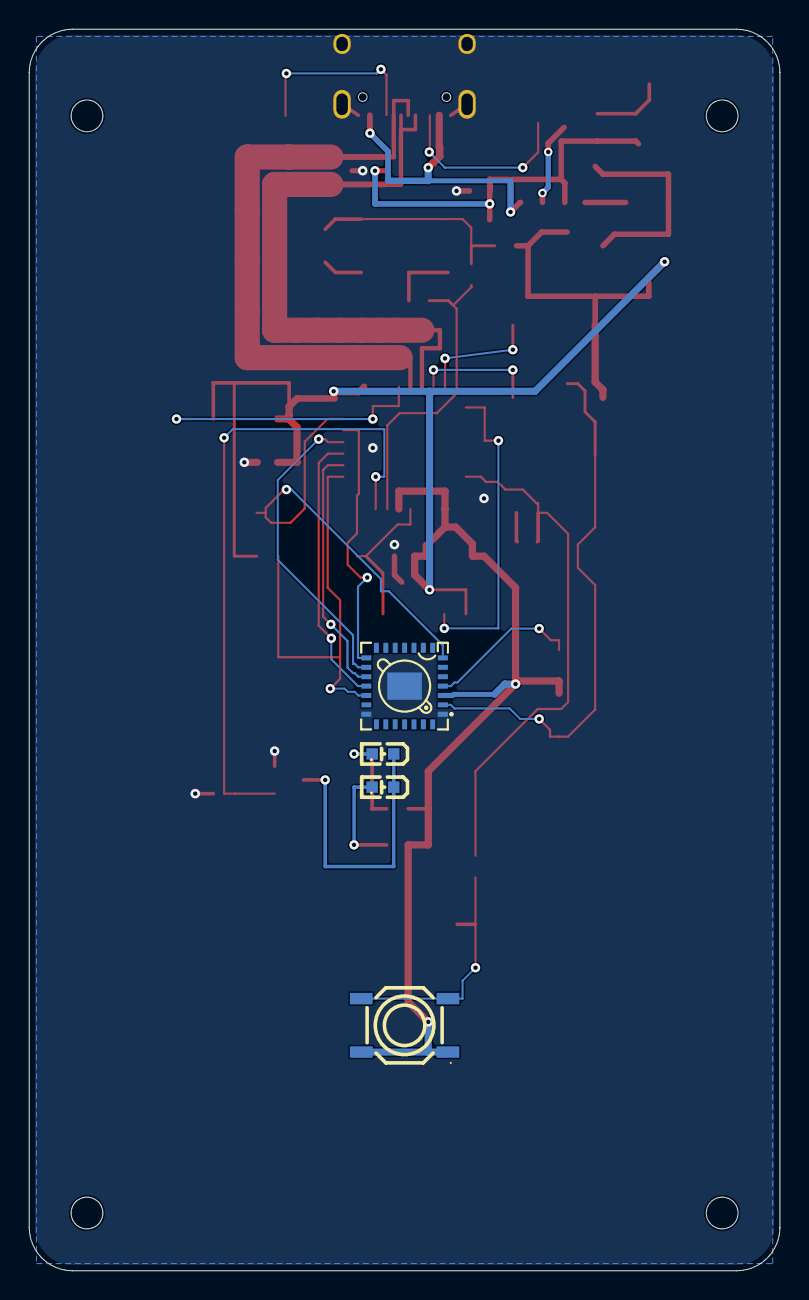
[picture p45: board mouse.kicad_pcb from below]

Board: 2 copper layers, 52.0 x 86.0 mm, 55 parts (4 on the bottom side), 33 nets.

Other parts of the board:
H1, H2, H3, H4: MountingHole_2.2mm_M2
