CopperPilot/desktop-computer-retro/modules/desktop/hardware/compact-cm5-desktop.kicad_pcb

## KiCad design modules/desktop/hardware/compact-cm5-desktop.kicad_pcb (2026-11-03)

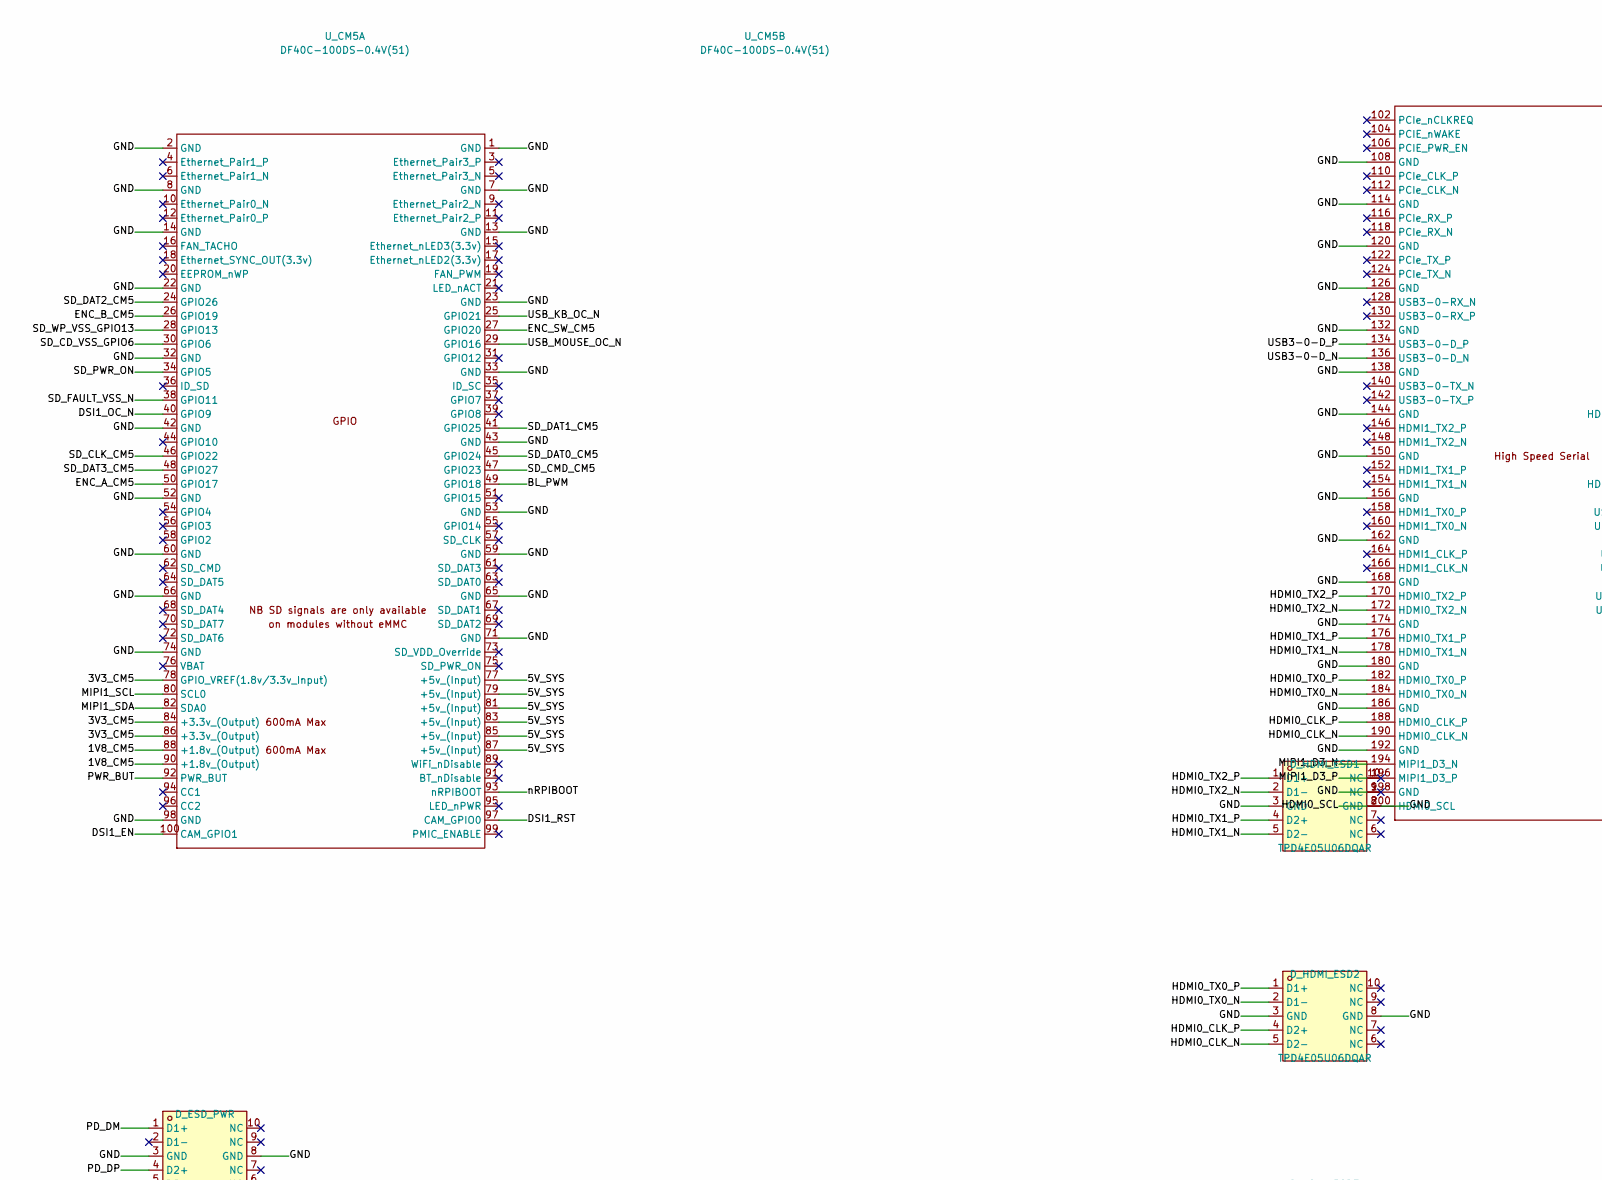
[picture p46: schematic compact-cm5-desktop.kicad_sch, Compact all-in-one CM5 desktop computer, part in row 1, column 1]

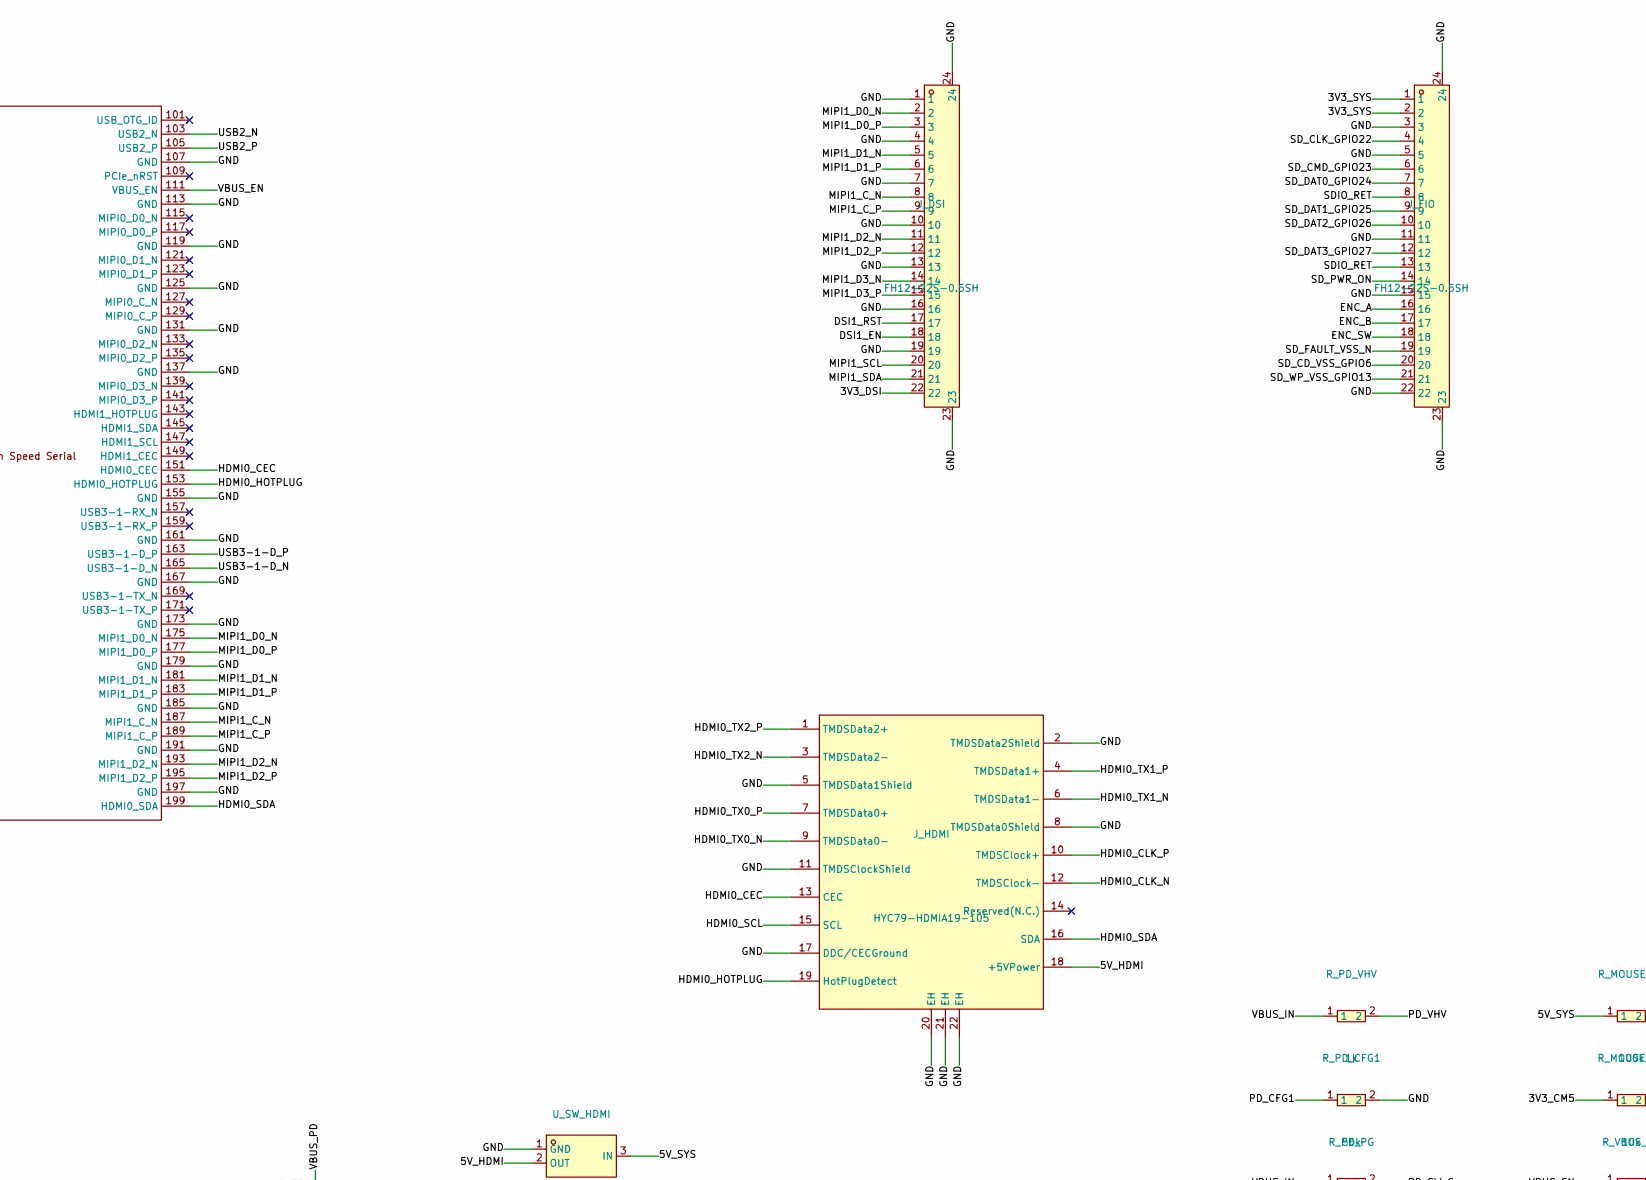
[picture p47: schematic compact-cm5-desktop.kicad_sch, Compact all-in-one CM5 desktop computer, part in row 1, column 2]

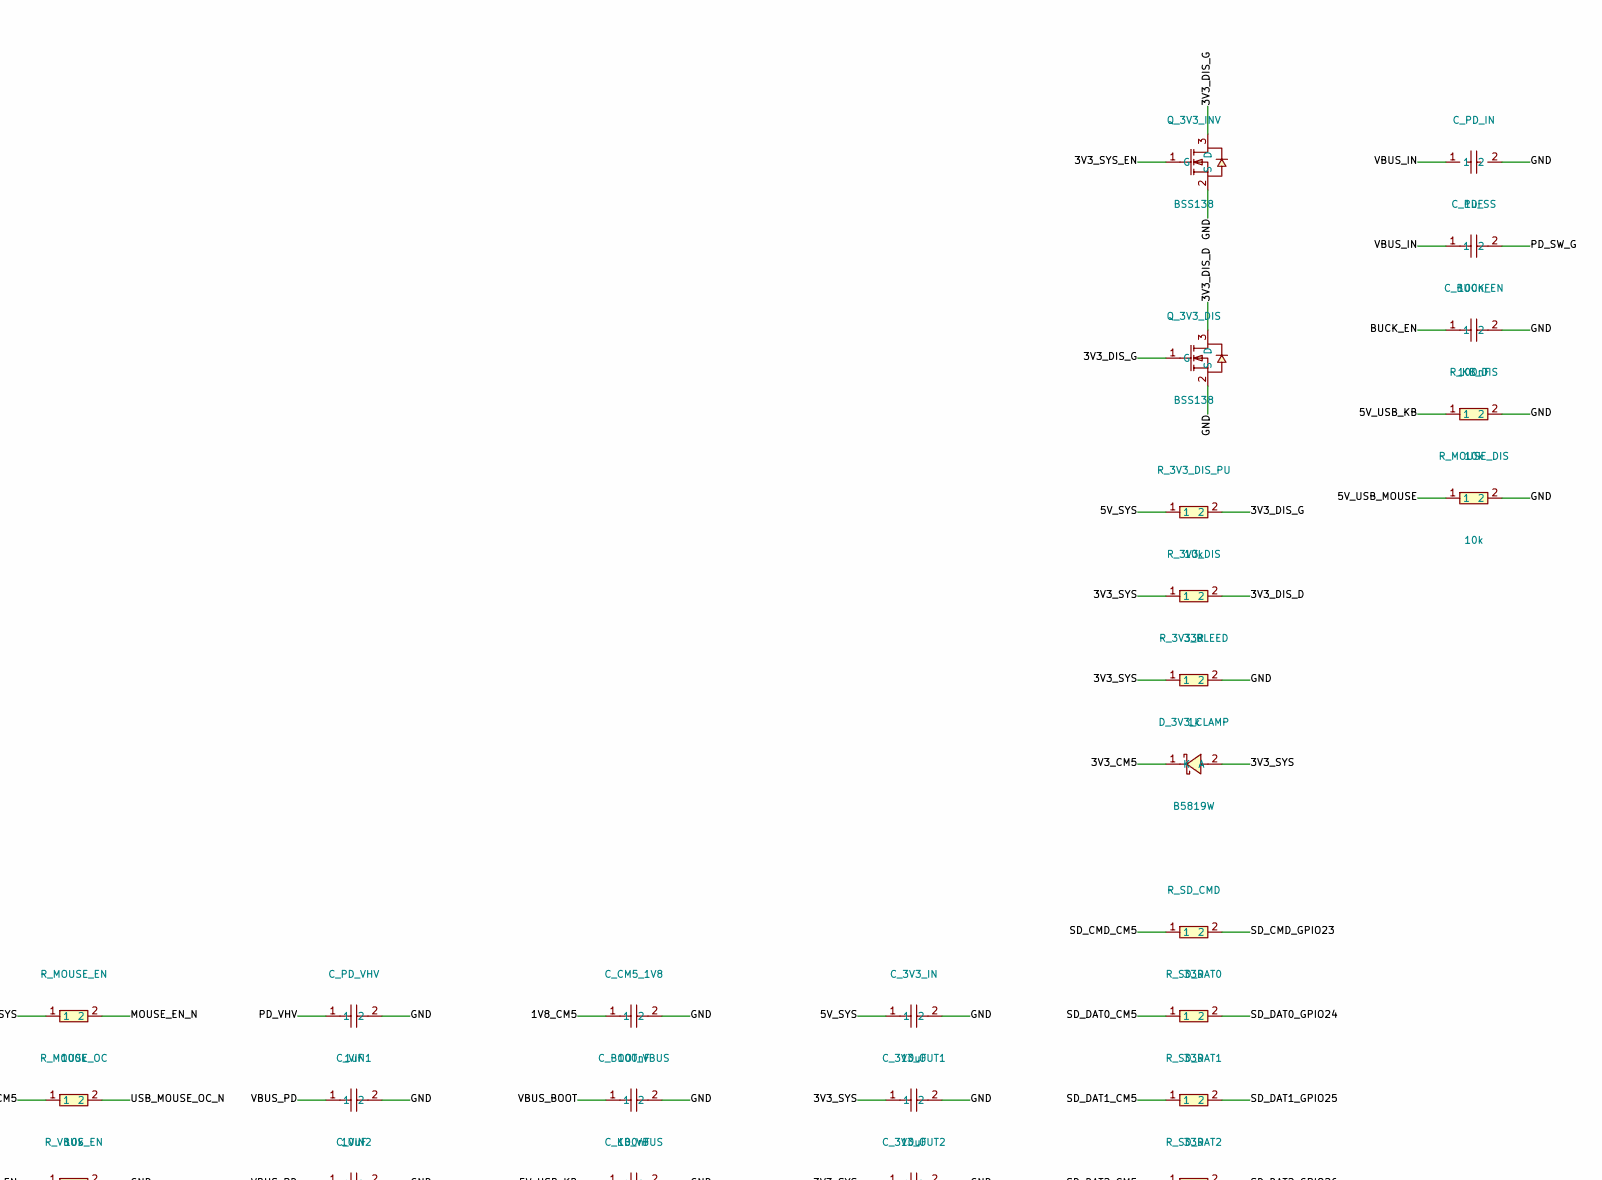
[picture p48: schematic compact-cm5-desktop.kicad_sch, Compact all-in-one CM5 desktop computer, part in row 1, column 3]

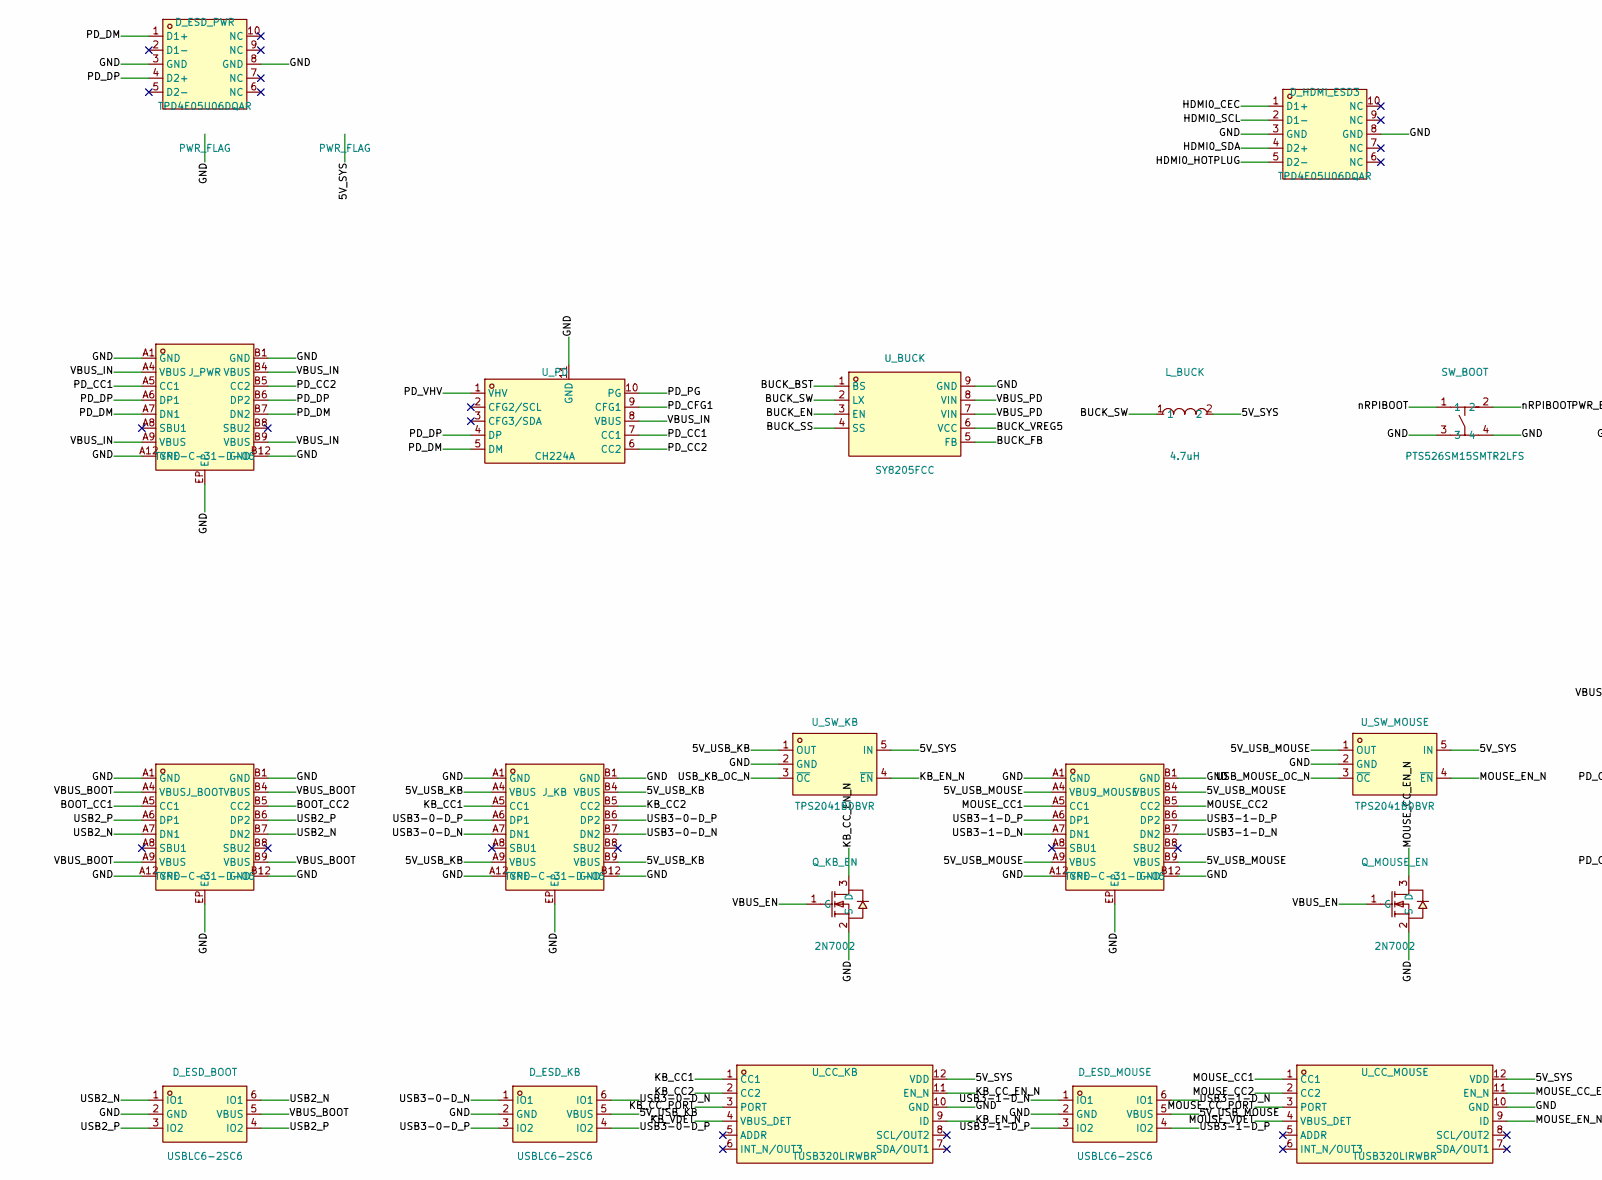
[picture p49: schematic compact-cm5-desktop.kicad_sch, Compact all-in-one CM5 desktop computer, part in row 2, column 1]

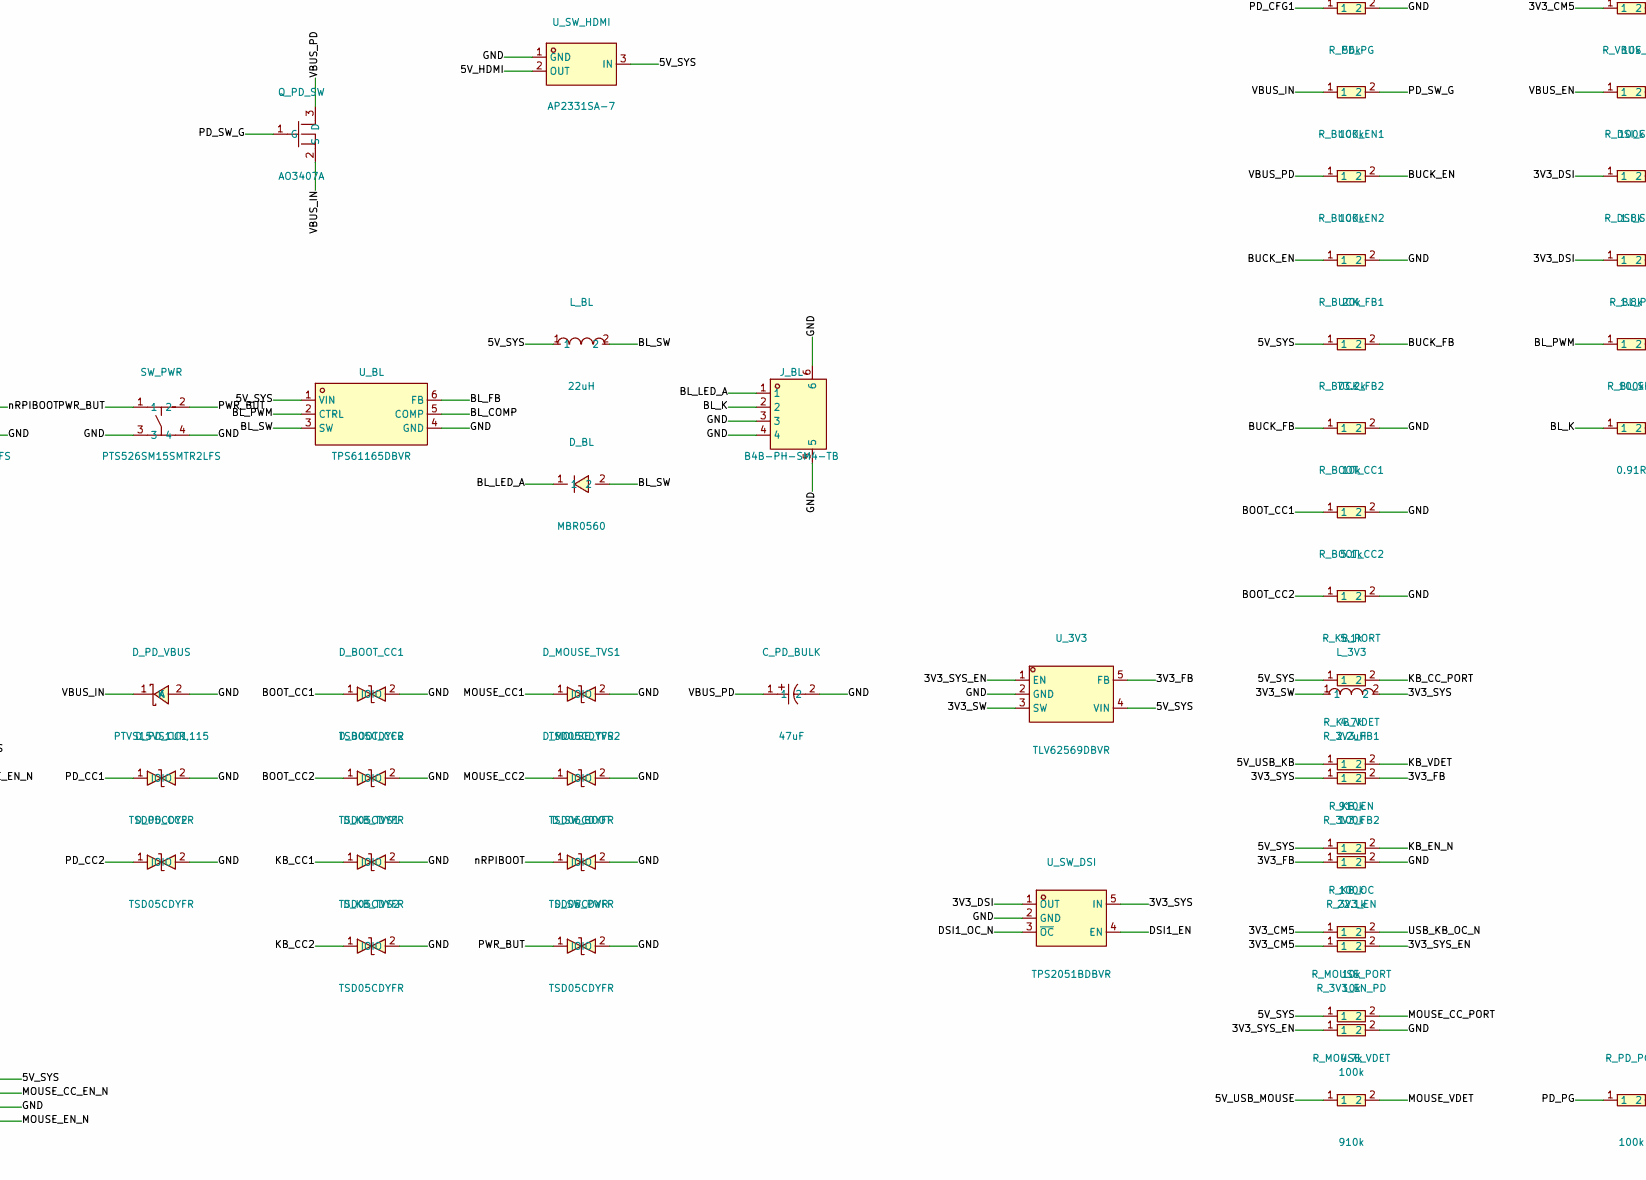
[picture p50: schematic compact-cm5-desktop.kicad_sch, Compact all-in-one CM5 desktop computer, part in row 2, column 2]

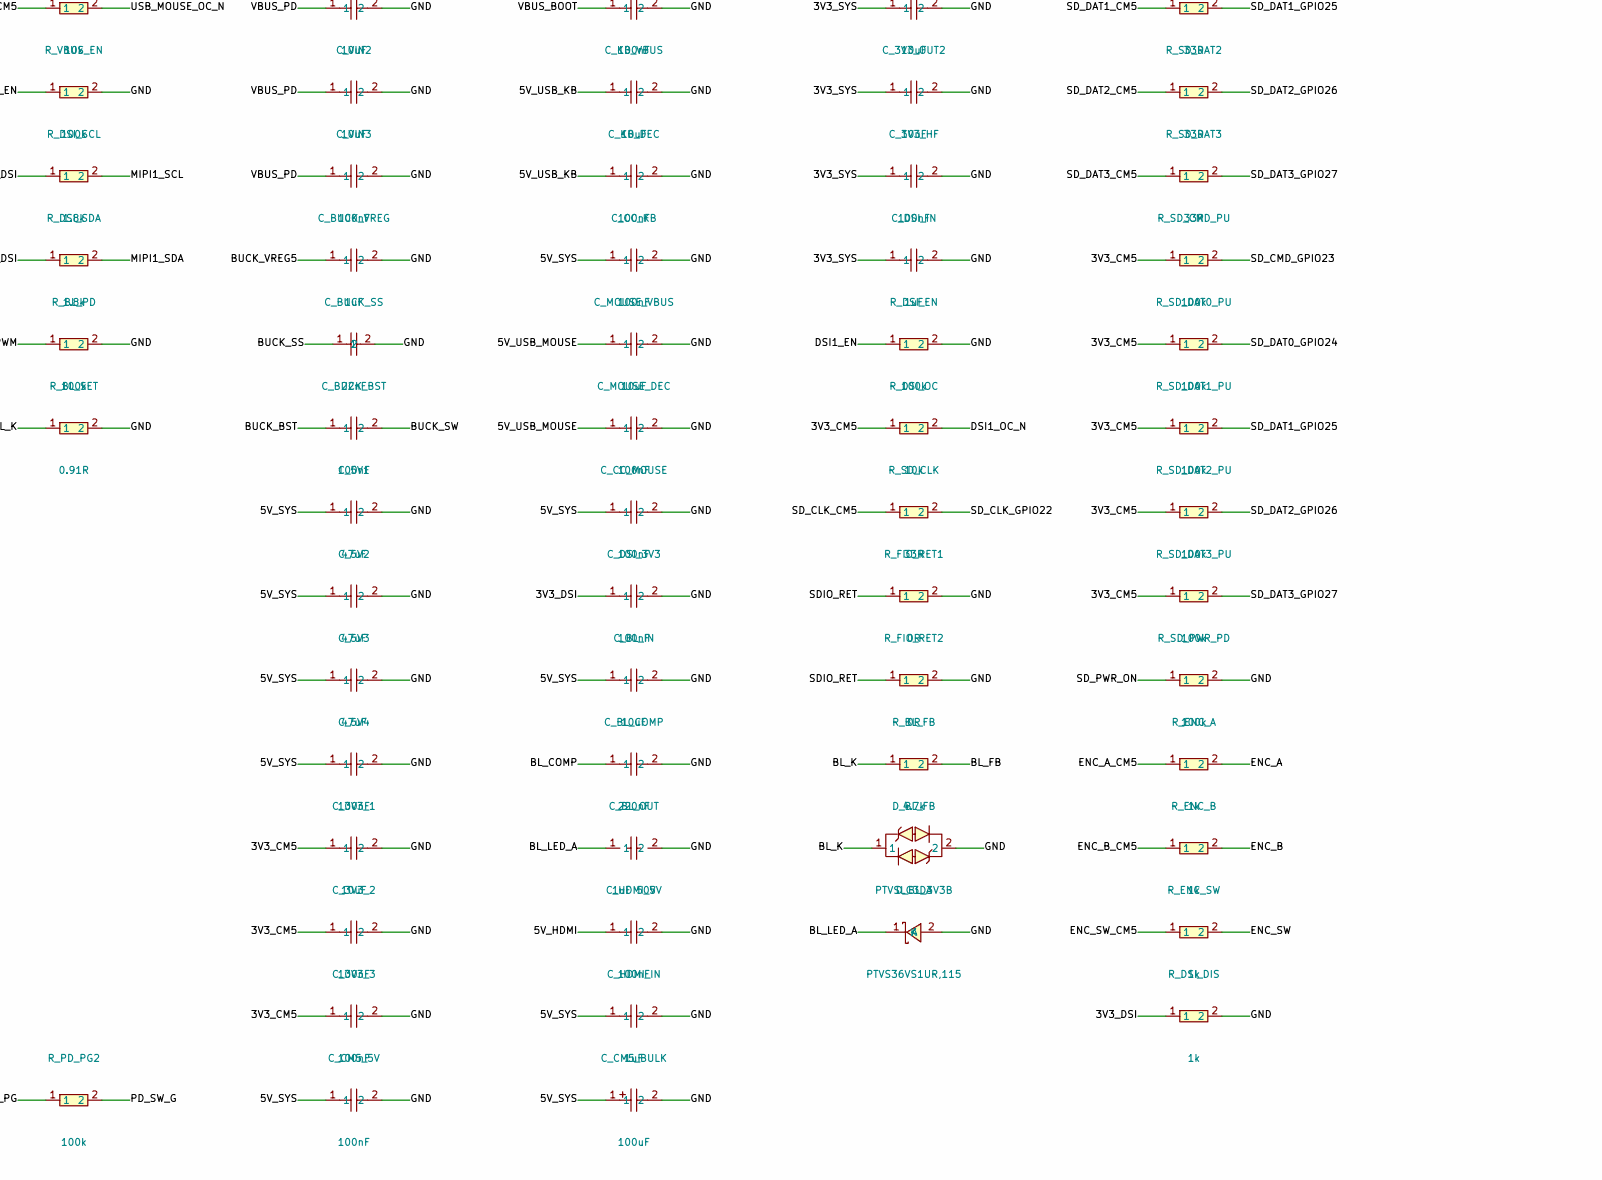
[picture p51: schematic compact-cm5-desktop.kicad_sch, Compact all-in-one CM5 desktop computer, part in row 2, column 3]

Parts:
C_3V3_1, C_3V3_IN, C_3V3_OUT1, C_3V3_OUT2: 10uF; C0805; MPN HGC0805R5106K350NSLJ; LCSC C33546007
C_3V3_2, C_3V3_3, C_3V3_HF, C_5V4: 100nF; C0402; MPN CL05B104KB54PNC; LCSC C307331
C_5V1, C_5V2, C_5V3: 47uF; C0805; MPN C2012X5R1A476MTJ00E; LCSC C76636
C_BL_COMP: 220nF; C0402; MPN TCC0402X7R224K250AT; LCSC C915854
C_BL_IN: 10uF; C0805; MPN HGC0805R5106K350NSLJ; LCSC C33546007
C_BL_OUT: 1uF 50V; C0805; MPN CC0805KKX7R9BB105; LCSC C91185
C_BOOT_VBUS: 100nF; C0402; MPN CL05B104KB54PNC; LCSC C307331
C_BUCK_BST: 100nF; C0402; MPN CL05B104KB54PNC; LCSC C307331
C_BUCK_EN: 100nF; C0402; MPN CL05B104KB54PNC; LCSC C307331
C_BUCK_SS: 22nF; C0402; MPN 0402B223K500NT; LCSC C1532
C_BUCK_VREG: 1uF; C0603; MPN CL10A105KB8NNNC; LCSC C15849
C_CC_KB: 100nF; C0402; MPN CL05B104KB54PNC; LCSC C307331
C_CC_MOUSE: 100nF; C0402; MPN CL05B104KB54PNC; LCSC C307331
C_CM5_1V8, C_CM5_5V: 100nF; C0402; MPN CL05B104KB54PNC; LCSC C307331
C_CM5_BULK: 100uF; CAP-SMD_L7.3-W4.3_SA11CM470A19R55XXX; MPN SA11AM101A19R15XXX; LCSC C135491
C_DSI_3V3: 100nF; C0402; MPN CL05B104KB54PNC; LCSC C307331
C_DSI_IN: 1uF; C0603; MPN CL10A105KB8NNNC; LCSC C15849
C_HDMI_5V: 100nF; C0402; MPN CL05B104KB54PNC; LCSC C307331
C_HDMI_IN: 1uF; C0603; MPN CL10A105KB8NNNC; LCSC C15849
C_KB_DEC: 100nF; C0402; MPN CL05B104KB54PNC; LCSC C307331
C_KB_VBUS: 10uF; C0805; MPN HGC0805R5106K350NSLJ; LCSC C33546007
C_MOUSE_DEC: 100nF; C0402; MPN CL05B104KB54PNC; LCSC C307331
C_MOUSE_VBUS: 10uF; C0805; MPN HGC0805R5106K350NSLJ; LCSC C33546007
C_PD_BULK: 47uF; CAP-SMD_L7.3-W4.3-FD; MPN CA55-D035K476TE150; LCSC C2761441
C_PD_IN: 1uF; C0805; MPN CC0805KKX7R9BB105; LCSC C91185
C_PD_SS: 100nF; C0402; MPN CL05B104KB54PNC; LCSC C307331
C_PD_VHV: 1uF; C0603; MPN CL10A105KB8NNNC; LCSC C15849
C_VIN1, C_VIN2: 10uF; C0805; MPN HGC0805R5106K350NSLJ; LCSC C33546007
C_VIN3: 100nF; C0402; MPN CL05B104KB54PNC; LCSC C307331
D_3V3_CLAMP: B5819W; SOD-123F_L2.7-W1.6-LS3.8-RD-1; MPN B5819W; LCSC C2943878
D_BL: MBR0560; SOD-123_L2.8-W1.8-LS3.7-RD; MPN MBR0560; LCSC C77338
D_BL_A: PTVS36VS1UR,115; SOD-123_L2.6-W1.7-LS3.5-RD; MPN PTVS36VS1UR,115; LCSC C171823
D_BL_FB: PTVSLC3D3V3B; SOD-323_L1.8-W1.3-LS2.5-BI; MPN PTVSLC3D3V3B; LCSC C246774
D_BOOT_CC1, D_BOOT_CC2: TSD05CDYFR; SOD-323_L1.8-W1.3-LS2.5-BI; MPN TSD05CDYFR; LCSC C20611048
D_ESD_BOOT: USBLC6-2SC6; SOT-23-6_L2.9-W1.6-P0.95-LS2.8-BL; MPN USBLC6-2SC6; LCSC C2827654
D_ESD_KB: USBLC6-2SC6; SOT-23-6_L2.9-W1.6-P0.95-LS2.8-BL; MPN USBLC6-2SC6; LCSC C2827654
D_ESD_MOUSE: USBLC6-2SC6; SOT-23-6_L2.9-W1.6-P0.95-LS2.8-BL; MPN USBLC6-2SC6; LCSC C2827654
D_ESD_PWR: TPD4E05U06DQAR; USON-10_L2.5-W1.0-P0.50-BL; MPN TPD4E05U06DQAR; LCSC C138714
D_HDMI_ESD1, D_HDMI_ESD2, D_HDMI_ESD3: TPD4E05U06DQAR; USON-10_L2.5-W1.0-P0.50-BL; MPN TPD4E05U06DQAR; LCSC C138714
D_KB_TVS1, D_KB_TVS2: TSD05CDYFR; SOD-323_L1.8-W1.3-LS2.5-BI; MPN TSD05CDYFR; LCSC C20611048
D_MOUSE_TVS1, D_MOUSE_TVS2: TSD05CDYFR; SOD-323_L1.8-W1.3-LS2.5-BI; MPN TSD05CDYFR; LCSC C20611048
D_PD_CC1, D_PD_CC2: TSD05CDYFR; SOD-323_L1.8-W1.3-LS2.5-BI; MPN TSD05CDYFR; LCSC C20611048
D_PD_VBUS: PTVS15VS1UR,115; SOD-123_L2.6-W1.7-LS3.5-RD; MPN PTVS15VS1UR,115; LCSC C513104
D_SW_BOOT: TSD05CDYFR; SOD-323_L1.8-W1.3-LS2.5-BI; MPN TSD05CDYFR; LCSC C20611048
D_SW_PWR: TSD05CDYFR; SOD-323_L1.8-W1.3-LS2.5-BI; MPN TSD05CDYFR; LCSC C20611048
J_BL: B4B-PH-SM4-TB; CONN-SMD_B4B-PH-SM4-TB-LF-SN; MPN B4B-PH-SM4-TB(LF)(SN); LCSC C160354
J_BOOT: TYPE-C-31-D-06; USB-C-SMD_TYPE-C-31-D-06; MPN TYPE-C-31-D-06; LCSC C2689964
J_DSI: FH12-22S-0.5SH; FPC-SMD_22P-P0.50_FH12-22S-0.5SH-55; MPN FH12-22S-0.5SH(55); LCSC C597981
J_FIO: FH12-22S-0.5SH; FPC-SMD_22P-P0.50_FH12-22S-0.5SH-55; MPN FH12-22S-0.5SH(55); LCSC C597981
J_HDMI: HYC79-HDMIA19-105; HDMI-SMD_HYC79-HDMIA19-105; MPN HYC79-HDMIA19-105; LCSC C711353
J_KB: TYPE-C-31-D-06; USB-C-SMD_TYPE-C-31-D-06; MPN TYPE-C-31-D-06; LCSC C2689964
J_MOUSE: TYPE-C-31-D-06; USB-C-SMD_TYPE-C-31-D-06; MPN TYPE-C-31-D-06; LCSC C2689964
J_PWR: TYPE-C-31-D-06; USB-C-SMD_TYPE-C-31-D-06; MPN TYPE-C-31-D-06; LCSC C2689964
L_3V3: 2.2uH; IND-SMD_L4.0-W4.0; MPN SPH4018H2R2MT; LCSC C370436
L_BL: 22uH; IND-SMD_L4.0-W4.0_SLW4010S; MPN SWPA4030S220MT; LCSC C83472
L_BUCK: 4.7uH; IND-SMD_L5.4-W5.2; MPN PSPMAA0503-4R7M-ANP; LCSC C436535
Q_3V3_DIS, Q_3V3_INV: BSS138; SOT-23-3_L2.9-W1.3-P1.90-LS2.4-BR; MPN BSS138; LCSC C78284
Q_KB_EN: 2N7002; SOT-23-3_L2.9-W1.3-P1.90-LS2.4-BR; MPN 2N7002; LCSC C8545
Q_MOUSE_EN: 2N7002; SOT-23-3_L2.9-W1.3-P1.90-LS2.4-BR; MPN 2N7002; LCSC C8545
Q_PD_SW: AO3407A; SOT-23_L2.9-W1.3-P1.90-LS2.4-BR; MPN AO3407A; LCSC C347478
R_3V3_BLEED: 1k; R0402; MPN 0402WGF1001TCE; LCSC C11702
R_3V3_DIS: 33R; R0402; MPN 0402WGF330JTCE; LCSC C25105
R_3V3_DIS_PU, R_3V3_EN: 10k; R0402; MPN 0402WGF1002TCE; LCSC C25744
R_3V3_EN_PD, R_3V3_FB1: 100k; R0402; MPN 0402WGF1003TCE; LCSC C25741
R_3V3_FB2: 22.1k; R0402; MPN 0402WGF2212TCE; LCSC C43473
R_BL_FB: 4.7k; R0402; MPN 0402WGF4701TCE; LCSC C25900
R_BL_PD: 100k; R0402; MPN 0402WGF1003TCE; LCSC C25741
R_BL_SET: 0.91R; R0805; MPN 0805W8F910LT5E; LCSC C17478
R_BOOT_CC1, R_BOOT_CC2: 5.1k; R0402; MPN 0402WGF5101TCE; LCSC C25905
R_BUCK_EN1: 100k; R0402; MPN 0402WGF1003TCE; LCSC C25741
R_BUCK_EN2: 20k; R0402; MPN 0402WGF2002TCE; LCSC C25765
R_BUCK_FB1: 73.2k; R0402; MPN 0402WGF7322TCE; LCSC C26986
R_BUCK_FB2: 10k; R0402; MPN 0402WGF1002TCE; LCSC C25744
R_DSI_DIS: 1k; R0402; MPN 0402WGF1001TCE; LCSC C11702
R_DSI_EN: 100k; R0402; MPN 0402WGF1003TCE; LCSC C25741
R_DSI_OC: 10k; R0402; MPN 0402WGF1002TCE; LCSC C25744
R_DSI_SCL: 1.8k; R0402; MPN 0402WGF1801TCE; LCSC C25871
R_DSI_SDA: 1.8k; R0402; MPN 0402WGF1801TCE; LCSC C25871
R_ENC_A: 1k; R0402; MPN 0402WGF1001TCE; LCSC C11702
R_ENC_B: 1k; R0402; MPN 0402WGF1001TCE; LCSC C11702
R_ENC_SW: 1k; R0402; MPN 0402WGF1001TCE; LCSC C11702
R_FIO_RET1, R_FIO_RET2: 0R; R0402; MPN 0402WGF0000TCE; LCSC C17168
R_KB_DIS: 10k; R0402; MPN 0402WGF1002TCE; LCSC C25744
R_KB_EN: 100k; R0402; MPN 0402WGF1003TCE; LCSC C25741
R_KB_OC: 10k; R0402; MPN 0402WGF1002TCE; LCSC C25744
R_KB_PORT: 4.7k; R0402; MPN 0402WGF4701TCE; LCSC C25900
R_KB_VDET: 910k; R0402; MPN 0402WGF9103TCE; LCSC C25800
R_MOUSE_DIS: 10k; R0402; MPN 0402WGF1002TCE; LCSC C25744
R_MOUSE_EN: 100k; R0402; MPN 0402WGF1003TCE; LCSC C25741
R_MOUSE_OC: 10k; R0402; MPN 0402WGF1002TCE; LCSC C25744
R_MOUSE_PORT: 4.7k; R0402; MPN 0402WGF4701TCE; LCSC C25900
R_MOUSE_VDET: 910k; R0402; MPN 0402WGF9103TCE; LCSC C25800
R_PD_CFG1: 56k; R0402; MPN RC0402FR-0756KL; LCSC C114756
R_PD_PG, R_PD_PG2: 100k; R0402; MPN 0402WGF1003TCE; LCSC C25741
R_PD_VHV: 1k; R0402; MPN 0402WGF1001TCE; LCSC C11702
R_SD_CLK: 33R; R0402; MPN 0402WGF330JTCE; LCSC C25105
R_SD_CMD: 33R; R0402; MPN 0402WGF330JTCE; LCSC C25105
R_SD_CMD_PU: 100k; R0402; MPN 0402WGF1003TCE; LCSC C25741
R_SD_DAT0, R_SD_DAT1, R_SD_DAT2, R_SD_DAT3: 33R; R0402; MPN 0402WGF330JTCE; LCSC C25105
R_SD_DAT0_PU, R_SD_DAT1_PU, R_SD_DAT2_PU, R_SD_DAT3_PU: 100k; R0402; MPN 0402WGF1003TCE; LCSC C25741
R_SD_PWR_PD: 100k; R0402; MPN 0402WGF1003TCE; LCSC C25741
R_VBUS_EN: 100k; R0402; MPN 0402WGF1003TCE; LCSC C25741
SW_BOOT: PTS526SM15SMTR2LFS; SW-SMD_4P-L5.2-W5.2-P3.70-LS6.4; MPN PTS526SM15SMTR2LFS; LCSC C2689538
SW_PWR: PTS526SM15SMTR2LFS; SW-SMD_4P-L5.2-W5.2-P3.70-LS6.4; MPN PTS526SM15SMTR2LFS; LCSC C2689538
U_3V3: TLV62569DBVR; SOT-23-5_L3.0-W1.7-P0.95-LS2.8-BR; MPN TLV62569DBVR; LCSC C141836
U_BL: TPS61165DBVR; SOT-23-6_L2.9-W1.6-P0.95-LS2.8-BR; MPN TPS61165DBVR; LCSC C58756
U_BUCK: SY8205FCC; SOIC-8_L5.0-W4.0-P1.27-LS6.0-BL-EP2.0; MPN SY8205FCC; LCSC C111875
U_CC_KB: TUSB320LIRWBR; X2QFN-12_L1.6-W1.6-P0.40-TL; MPN TUSB320LIRWBR; LCSC C2836598
U_CC_MOUSE: TUSB320LIRWBR; X2QFN-12_L1.6-W1.6-P0.40-TL; MPN TUSB320LIRWBR; LCSC C2836598
U_CM5: DF40C-100DS-0.4V(51); Raspberry-Pi-5-Compute-Module; MPN DF40C-100DS-0.4V(51); LCSC C597931
U_PD: CH224A; ESSOP-10_L4.9-W3.9-P1.0-LS6.0-TL-EP; MPN CH224A; LCSC C42459160
U_SW_DSI: TPS2051BDBVR; SOT-23-5_L3.0-W1.7-P0.95-LS2.8-BR; MPN TPS2051BDBVR; LCSC C24593
U_SW_HDMI: AP2331SA-7; SOT-23-3_L2.9-W1.3-P1.90-LS2.4-BR; MPN AP2331SA-7; LCSC C500764
U_SW_KB: TPS2041BDBVR; SOT-23-5_L3.0-W1.7-P0.95-LS2.8-BR; MPN TPS2041BDBVR; LCSC C51386
U_SW_MOUSE: TPS2041BDBVR; SOT-23-5_L3.0-W1.7-P0.95-LS2.8-BR; MPN TPS2041BDBVR; LCSC C51386

Connections:
/1V8_CM5: C_CM5_1V8.1, U_CM5.88 (+1.8v_(Output)), U_CM5.90 (+1.8v_(Output))
/3V3_CM5: C_3V3_1.1, C_3V3_2.1, C_3V3_3.1, D_3V3_CLAMP.1 (K), R_3V3_EN.1, R_DSI_OC.1, R_KB_OC.1, R_MOUSE_OC.1, R_SD_CMD_PU.1, R_SD_DAT0_PU.1, R_SD_DAT1_PU.1, R_SD_DAT2_PU.1, R_SD_DAT3_PU.1, U_CM5.78 (GPIO_VREF(1.8v/3.3v_Input)), U_CM5.84 (+3.3v_(Output)), U_CM5.86 (+3.3v_(Output))
/3V3_DIS_D: Q_3V3_DIS.3 (D), R_3V3_DIS.2
/3V3_DIS_G: Q_3V3_DIS.1 (G), Q_3V3_INV.3 (D), R_3V3_DIS_PU.2
/3V3_DSI: C_DSI_3V3.1, J_DSI.22, R_DSI_DIS.1, R_DSI_SCL.1, R_DSI_SDA.1, U_SW_DSI.1 (OUT)
/3V3_FB: R_3V3_FB1.2, R_3V3_FB2.1, U_3V3.5 (FB)
/3V3_SW: L_3V3.1, U_3V3.3 (SW)
/3V3_SYS: C_3V3_HF.1, C_3V3_OUT1.1, C_3V3_OUT2.1, C_DSI_IN.1, D_3V3_CLAMP.2 (A), J_FIO.1, J_FIO.2, L_3V3.2, R_3V3_BLEED.1, R_3V3_DIS.1, R_3V3_FB1.1, U_SW_DSI.5 (IN)
/3V3_SYS_EN: Q_3V3_INV.1 (G), R_3V3_EN.2, R_3V3_EN_PD.1, U_3V3.1 (EN)
/5V_HDMI: C_HDMI_5V.1, J_HDMI.18 (+5VPower), U_SW_HDMI.2 (OUT)
/5V_SYS: C_3V3_IN.1, C_5V1.1, C_5V2.1, C_5V3.1, C_5V4.1, C_BL_IN.1, C_CC_KB.1, C_CC_MOUSE.1, C_CM5_5V.1, C_CM5_BULK.1, C_HDMI_IN.1, L_BL.1, L_BUCK.2, R_3V3_DIS_PU.1, R_BUCK_FB1.1, R_KB_EN.1, R_KB_PORT.1, R_MOUSE_EN.1, R_MOUSE_PORT.1, U_3V3.4 (VIN), U_BL.1 (VIN), U_CC_KB.12 (VDD), U_CC_MOUSE.12 (VDD), U_CM5.77 (+5v_(Input)), U_CM5.79 (+5v_(Input)), U_CM5.81 (+5v_(Input)), U_CM5.83 (+5v_(Input)), U_CM5.85 (+5v_(Input)), U_CM5.87 (+5v_(Input)), U_SW_HDMI.3 (IN), U_SW_KB.5 (IN), U_SW_MOUSE.5 (IN)
/5V_USB_KB: C_KB_DEC.1, C_KB_VBUS.1, D_ESD_KB.5 (VBUS), J_KB.A4 (VBUS), J_KB.A9 (VBUS), J_KB.B4 (VBUS), J_KB.B9 (VBUS), R_KB_DIS.1, R_KB_VDET.1, U_SW_KB.1 (OUT)
/5V_USB_MOUSE: C_MOUSE_DEC.1, C_MOUSE_VBUS.1, D_ESD_MOUSE.5 (VBUS), J_MOUSE.A4 (VBUS), J_MOUSE.A9 (VBUS), J_MOUSE.B4 (VBUS), J_MOUSE.B9 (VBUS), R_MOUSE_DIS.1, R_MOUSE_VDET.1, U_SW_MOUSE.1 (OUT)
/BL_COMP: C_BL_COMP.1, U_BL.5 (COMP)
/BL_FB: R_BL_FB.2, U_BL.6 (FB)
/BL_K: D_BL_FB.1, J_BL.2, R_BL_FB.1, R_BL_SET.1
/BL_LED_A: C_BL_OUT.1, D_BL.1, D_BL_A.1 (K), J_BL.1
/BL_PWM: R_BL_PD.1, U_BL.2 (CTRL), U_CM5.49 (GPIO18)
/BL_SW: D_BL.2, L_BL.2, U_BL.3 (SW)
/BOOT_CC1: D_BOOT_CC1.1, J_BOOT.A5 (CC1), R_BOOT_CC1.1
/BOOT_CC2: D_BOOT_CC2.1, J_BOOT.B5 (CC2), R_BOOT_CC2.1
/BUCK_BST: C_BUCK_BST.1, U_BUCK.1 (BS)
/BUCK_EN: C_BUCK_EN.1, R_BUCK_EN1.2, R_BUCK_EN2.1, U_BUCK.3 (EN)
/BUCK_FB: R_BUCK_FB1.2, R_BUCK_FB2.1, U_BUCK.5 (FB)
/BUCK_SS: C_BUCK_SS.1, U_BUCK.4 (SS)
/BUCK_SW: C_BUCK_BST.2, L_BUCK.1, U_BUCK.2 (LX)
/BUCK_VREG5: C_BUCK_VREG.1, U_BUCK.6 (VCC)
/DSI1_EN: J_DSI.18, R_DSI_EN.1, U_CM5.100 (CAM_GPIO1), U_SW_DSI.4 (EN)
/DSI1_OC_N: R_DSI_OC.2, U_CM5.40 (GPIO9), U_SW_DSI.3 (~OC)
/DSI1_RST: J_DSI.17, U_CM5.97 (CAM_GPIO0)
/ENC_A: J_FIO.16, R_ENC_A.2
/ENC_A_CM5: R_ENC_A.1, U_CM5.50 (GPIO17)
/ENC_B: J_FIO.17, R_ENC_B.2
/ENC_B_CM5: R_ENC_B.1, U_CM5.26 (GPIO19)
/ENC_SW: J_FIO.18, R_ENC_SW.2
/ENC_SW_CM5: R_ENC_SW.1, U_CM5.27 (GPIO20)
/GND: C_3V3_1.2, C_3V3_2.2, C_3V3_3.2, C_3V3_HF.2, C_3V3_IN.2, C_3V3_OUT1.2, C_3V3_OUT2.2, C_5V1.2, C_5V2.2, C_5V3.2, C_5V4.2, C_BL_COMP.2, C_BL_IN.2, C_BL_OUT.2, C_BOOT_VBUS.2, C_BUCK_EN.2, C_BUCK_SS.2, C_BUCK_VREG.2, C_CC_KB.2, C_CC_MOUSE.2, C_CM5_1V8.2, C_CM5_5V.2, C_CM5_BULK.2, C_DSI_3V3.2, C_DSI_IN.2, C_HDMI_5V.2, C_HDMI_IN.2, C_KB_DEC.2, C_KB_VBUS.2, C_MOUSE_DEC.2, C_MOUSE_VBUS.2, C_PD_BULK.2, C_PD_IN.2, C_PD_VHV.2, C_VIN1.2, C_VIN2.2, C_VIN3.2, D_BL_A.2 (A), D_BL_FB.2, D_BOOT_CC1.2, D_BOOT_CC2.2, D_ESD_BOOT.2 (GND), D_ESD_KB.2 (GND), D_ESD_MOUSE.2 (GND), D_ESD_PWR.3 (GND), D_ESD_PWR.8 (GND), D_HDMI_ESD1.3 (GND), D_HDMI_ESD1.8 (GND), D_HDMI_ESD2.3 (GND), D_HDMI_ESD2.8 (GND), D_HDMI_ESD3.3 (GND), D_HDMI_ESD3.8 (GND), D_KB_TVS1.2, D_KB_TVS2.2, D_MOUSE_TVS1.2, D_MOUSE_TVS2.2, D_PD_CC1.2, D_PD_CC2.2, D_PD_VBUS.2 (A), D_SW_BOOT.2, D_SW_PWR.2, J_BL.3, J_BL.4, J_BL.5, J_BL.6, J_BOOT.A1 (GND), J_BOOT.A12 (GND), J_BOOT.B1 (GND), J_BOOT.B12 (GND), J_BOOT.EP, J_DSI.1, J_DSI.4, J_DSI.7, J_DSI.10, J_DSI.13, J_DSI.16, J_DSI.19, J_DSI.23, J_DSI.24, J_FIO.3, J_FIO.5, J_FIO.11, J_FIO.15, J_FIO.22, J_FIO.23, J_FIO.24, J_HDMI.2 (TMDSData2Shield), J_HDMI.5 (TMDSData1Shield), J_HDMI.8 (TMDSData0Shield), J_HDMI.11 (TMDSClockShield), J_HDMI.17 (DDC/CECGround), J_HDMI.20 (EH), J_HDMI.21 (EH), J_HDMI.22 (EH), J_KB.A1 (GND), J_KB.A12 (GND), J_KB.B1 (GND), J_KB.B12 (GND), J_KB.EP, J_MOUSE.A1 (GND), J_MOUSE.A12 (GND), J_MOUSE.B1 (GND), J_MOUSE.B12 (GND), J_MOUSE.EP, J_PWR.A1 (GND), J_PWR.A12 (GND), J_PWR.B1 (GND), J_PWR.B12 (GND), J_PWR.EP, Q_3V3_DIS.2 (S), Q_3V3_INV.2 (S), Q_KB_EN.2 (S), Q_MOUSE_EN.2 (S), R_3V3_BLEED.2, R_3V3_EN_PD.2, R_3V3_FB2.2, R_BL_PD.2, R_BL_SET.2, R_BOOT_CC1.2, R_BOOT_CC2.2, R_BUCK_EN2.2, R_BUCK_FB2.2, R_DSI_DIS.2, R_DSI_EN.2, R_FIO_RET1.2, R_FIO_RET2.2, R_KB_DIS.2, R_MOUSE_DIS.2, R_PD_CFG1.2, R_SD_PWR_PD.2, R_VBUS_EN.2, SW_BOOT.3, SW_BOOT.4, SW_PWR.3, SW_PWR.4, U_3V3.2 (GND), U_BL.4 (GND), U_BUCK.9 (GND), U_CC_KB.10 (GND), U_CC_MOUSE.10 (GND), U_CM5.1 (GND), U_CM5.2 (GND), U_CM5.7 (GND), U_CM5.8 (GND), U_CM5.13 (GND), U_CM5.14 (GND), U_CM5.22 (GND), U_CM5.23 (GND), U_CM5.32 (GND), U_CM5.33 (GND), U_CM5.42 (GND), U_CM5.43 (GND), U_CM5.52 (GND), U_CM5.53 (GND), U_CM5.59 (GND), U_CM5.60 (GND), U_CM5.65 (GND), U_CM5.66 (GND), U_CM5.71 (GND), U_CM5.74 (GND), U_CM5.98 (GND), U_CM5.107 (GND), U_CM5.108 (GND), U_CM5.113 (GND), U_CM5.114 (GND), U_CM5.119 (GND), U_CM5.120 (GND), U_CM5.125 (GND), U_CM5.126 (GND), U_CM5.131 (GND), U_CM5.132 (GND), U_CM5.137 (GND), U_CM5.138 (GND), U_CM5.144 (GND), U_CM5.150 (GND), U_CM5.155 (GND), U_CM5.156 (GND), U_CM5.161 (GND), U_CM5.162 (GND), U_CM5.167 (GND), U_CM5.168 (GND), U_CM5.173 (GND), U_CM5.174 (GND), U_CM5.179 (GND), U_CM5.180 (GND), U_CM5.185 (GND), U_CM5.186 (GND), U_CM5.191 (GND), U_CM5.192 (GND), U_CM5.197 (GND), U_CM5.198 (GND), U_PD.11 (GND), U_SW_DSI.2 (GND), U_SW_HDMI.1 (GND), U_SW_KB.2 (GND), U_SW_MOUSE.2 (GND)
/HDMI0_CEC: D_HDMI_ESD3.1 (D1+), J_HDMI.13 (CEC), U_CM5.151 (HDMI0_CEC)
/HDMI0_CLK_N: D_HDMI_ESD2.5 (D2-), J_HDMI.12 (TMDSClock-), U_CM5.190 (HDMI0_CLK_N)
/HDMI0_CLK_P: D_HDMI_ESD2.4 (D2+), J_HDMI.10 (TMDSClock+), U_CM5.188 (HDMI0_CLK_P)
/HDMI0_HOTPLUG: D_HDMI_ESD3.5 (D2-), J_HDMI.19 (HotPlugDetect), U_CM5.153 (HDMI0_HOTPLUG)
/HDMI0_SCL: D_HDMI_ESD3.2 (D1-), J_HDMI.15 (SCL), U_CM5.200 (HDMI0_SCL)
/HDMI0_SDA: D_HDMI_ESD3.4 (D2+), J_HDMI.16 (SDA), U_CM5.199 (HDMI0_SDA)
/HDMI0_TX0_N: D_HDMI_ESD2.2 (D1-), J_HDMI.9 (TMDSData0-), U_CM5.184 (HDMI0_TX0_N)
/HDMI0_TX0_P: D_HDMI_ESD2.1 (D1+), J_HDMI.7 (TMDSData0+), U_CM5.182 (HDMI0_TX0_P)
/HDMI0_TX1_N: D_HDMI_ESD1.5 (D2-), J_HDMI.6 (TMDSData1-), U_CM5.178 (HDMI0_TX1_N)
/HDMI0_TX1_P: D_HDMI_ESD1.4 (D2+), J_HDMI.4 (TMDSData1+), U_CM5.176 (HDMI0_TX1_P)
/HDMI0_TX2_N: D_HDMI_ESD1.2 (D1-), J_HDMI.3 (TMDSData2-), U_CM5.172 (HDMI0_TX2_N)
/HDMI0_TX2_P: D_HDMI_ESD1.1 (D1+), J_HDMI.1 (TMDSData2+), U_CM5.170 (HDMI0_TX2_P)
/KB_CC1: D_KB_TVS1.1, J_KB.A5 (CC1), U_CC_KB.1 (CC1)
/KB_CC2: D_KB_TVS2.1, J_KB.B5 (CC2), U_CC_KB.2 (CC2)
/KB_CC_EN_N: Q_KB_EN.3 (D), U_CC_KB.11 (EN_N)
/KB_CC_PORT: R_KB_PORT.2, U_CC_KB.3 (PORT)
/KB_EN_N: R_KB_EN.2, U_CC_KB.9 (ID), U_SW_KB.4 (~EN)
/KB_VDET: R_KB_VDET.2, U_CC_KB.4 (VBUS_DET)
/MIPI1_C_N: J_DSI.8, U_CM5.187 (MIPI1_C_N)
/MIPI1_C_P: J_DSI.9, U_CM5.189 (MIPI1_C_P)
/MIPI1_D0_N: J_DSI.2, U_CM5.175 (MIPI1_D0_N)
/MIPI1_D0_P: J_DSI.3, U_CM5.177 (MIPI1_D0_P)
/MIPI1_D1_N: J_DSI.5, U_CM5.181 (MIPI1_D1_N)
/MIPI1_D1_P: J_DSI.6, U_CM5.183 (MIPI1_D1_P)
/MIPI1_D2_N: J_DSI.11, U_CM5.193 (MIPI1_D2_N)
/MIPI1_D2_P: J_DSI.12, U_CM5.195 (MIPI1_D2_P)
/MIPI1_D3_N: J_DSI.14, U_CM5.194 (MIPI1_D3_N)
/MIPI1_D3_P: J_DSI.15, U_CM5.196 (MIPI1_D3_P)
/MIPI1_SCL: J_DSI.20, R_DSI_SCL.2, U_CM5.80 (SCL0)
/MIPI1_SDA: J_DSI.21, R_DSI_SDA.2, U_CM5.82 (SDA0)
/MOUSE_CC1: D_MOUSE_TVS1.1, J_MOUSE.A5 (CC1), U_CC_MOUSE.1 (CC1)
/MOUSE_CC2: D_MOUSE_TVS2.1, J_MOUSE.B5 (CC2), U_CC_MOUSE.2 (CC2)
/MOUSE_CC_EN_N: Q_MOUSE_EN.3 (D), U_CC_MOUSE.11 (EN_N)
/MOUSE_CC_PORT: R_MOUSE_PORT.2, U_CC_MOUSE.3 (PORT)
/MOUSE_EN_N: R_MOUSE_EN.2, U_CC_MOUSE.9 (ID), U_SW_MOUSE.4 (~EN)
/MOUSE_VDET: R_MOUSE_VDET.2, U_CC_MOUSE.4 (VBUS_DET)
/PD_CC1: D_PD_CC1.1, J_PWR.A5 (CC1), U_PD.7 (CC1)
/PD_CC2: D_PD_CC2.1, J_PWR.B5 (CC2), U_PD.6 (CC2)
/PD_CFG1: R_PD_CFG1.1, U_PD.9 (CFG1)
/PD_DM: D_ESD_PWR.1 (D1+), J_PWR.A7 (DN1), J_PWR.B7 (DN2), U_PD.5 (DM)
/PD_DP: D_ESD_PWR.4 (D2+), J_PWR.A6 (DP1), J_PWR.B6 (DP2), U_PD.4 (DP)
/PD_PG: R_PD_PG2.1, U_PD.10 (PG)
/PD_SW_G: C_PD_SS.2, Q_PD_SW.1 (G), R_PD_PG.2, R_PD_PG2.2
/PD_VHV: C_PD_VHV.1, R_PD_VHV.2, U_PD.1 (VHV)
/PWR_BUT: D_SW_PWR.1, SW_PWR.1, SW_PWR.2, U_CM5.92 (PWR_BUT)
/SDIO_RET: J_FIO.8, J_FIO.13, R_FIO_RET1.1, R_FIO_RET2.1
/SD_CD_VSS_GPIO6: J_FIO.20, U_CM5.30 (GPIO6)
/SD_CLK_CM5: R_SD_CLK.1, U_CM5.46 (GPIO22)
/SD_CLK_GPIO22: J_FIO.4, R_SD_CLK.2
/SD_CMD_CM5: R_SD_CMD.1, U_CM5.47 (GPIO23)
/SD_CMD_GPIO23: J_FIO.6, R_SD_CMD.2, R_SD_CMD_PU.2
/SD_DAT0_CM5: R_SD_DAT0.1, U_CM5.45 (GPIO24)
/SD_DAT0_GPIO24: J_FIO.7, R_SD_DAT0.2, R_SD_DAT0_PU.2
/SD_DAT1_CM5: R_SD_DAT1.1, U_CM5.41 (GPIO25)
/SD_DAT1_GPIO25: J_FIO.9, R_SD_DAT1.2, R_SD_DAT1_PU.2
/SD_DAT2_CM5: R_SD_DAT2.1, U_CM5.24 (GPIO26)
/SD_DAT2_GPIO26: J_FIO.10, R_SD_DAT2.2, R_SD_DAT2_PU.2
/SD_DAT3_CM5: R_SD_DAT3.1, U_CM5.48 (GPIO27)
/SD_DAT3_GPIO27: J_FIO.12, R_SD_DAT3.2, R_SD_DAT3_PU.2
/SD_FAULT_VSS_N: J_FIO.19, U_CM5.38 (GPIO11)
/SD_PWR_ON: J_FIO.14, R_SD_PWR_PD.1, U_CM5.34 (GPIO5)
/SD_WP_VSS_GPIO13: J_FIO.21, U_CM5.28 (GPIO13)
/USB2_N: D_ESD_BOOT.1 (IO1), D_ESD_BOOT.6 (IO1), J_BOOT.A7 (DN1), J_BOOT.B7 (DN2), U_CM5.103 (USB2_N)
/USB2_P: D_ESD_BOOT.3 (IO2), D_ESD_BOOT.4 (IO2), J_BOOT.A6 (DP1), J_BOOT.B6 (DP2), U_CM5.105 (USB2_P)
/USB3-0-D_N: D_ESD_KB.1 (IO1), D_ESD_KB.6 (IO1), J_KB.A7 (DN1), J_KB.B7 (DN2), U_CM5.136 (USB3-0-D_N)
/USB3-0-D_P: D_ESD_KB.3 (IO2), D_ESD_KB.4 (IO2), J_KB.A6 (DP1), J_KB.B6 (DP2), U_CM5.134 (USB3-0-D_P)
/USB3-1-D_N: D_ESD_MOUSE.1 (IO1), D_ESD_MOUSE.6 (IO1), J_MOUSE.A7 (DN1), J_MOUSE.B7 (DN2), U_CM5.165 (USB3-1-D_N)
/USB3-1-D_P: D_ESD_MOUSE.3 (IO2), D_ESD_MOUSE.4 (IO2), J_MOUSE.A6 (DP1), J_MOUSE.B6 (DP2), U_CM5.163 (USB3-1-D_P)
/USB_KB_OC_N: R_KB_OC.2, U_CM5.25 (GPIO21), U_SW_KB.3 (~OC)
/USB_MOUSE_OC_N: R_MOUSE_OC.2, U_CM5.29 (GPIO16), U_SW_MOUSE.3 (~OC)
/VBUS_BOOT: C_BOOT_VBUS.1, D_ESD_BOOT.5 (VBUS), J_BOOT.A4 (VBUS), J_BOOT.A9 (VBUS), J_BOOT.B4 (VBUS), J_BOOT.B9 (VBUS)
/VBUS_EN: Q_KB_EN.1 (G), Q_MOUSE_EN.1 (G), R_VBUS_EN.1, U_CM5.111 (VBUS_EN)
/VBUS_IN: C_PD_IN.1, C_PD_SS.1, D_PD_VBUS.1 (K), J_PWR.A4 (VBUS), J_PWR.A9 (VBUS), J_PWR.B4 (VBUS), J_PWR.B9 (VBUS), Q_PD_SW.2 (S), R_PD_PG.1, R_PD_VHV.1, U_PD.8 (VBUS)
/VBUS_PD: C_PD_BULK.1, C_VIN1.1, C_VIN2.1, C_VIN3.1, Q_PD_SW.3 (D), R_BUCK_EN1.1, U_BUCK.7 (VIN), U_BUCK.8 (VIN)
/nRPIBOOT: D_SW_BOOT.1, SW_BOOT.1, SW_BOOT.2, U_CM5.93 (nRPIBOOT)
