CopperPilot/desktop-computer-retro/modules/desktop/hardware/compact-cm5-desktop.kicad_pcb

## KiCad design modules/desktop/hardware/compact-cm5-desktop.kicad_pcb (continued)

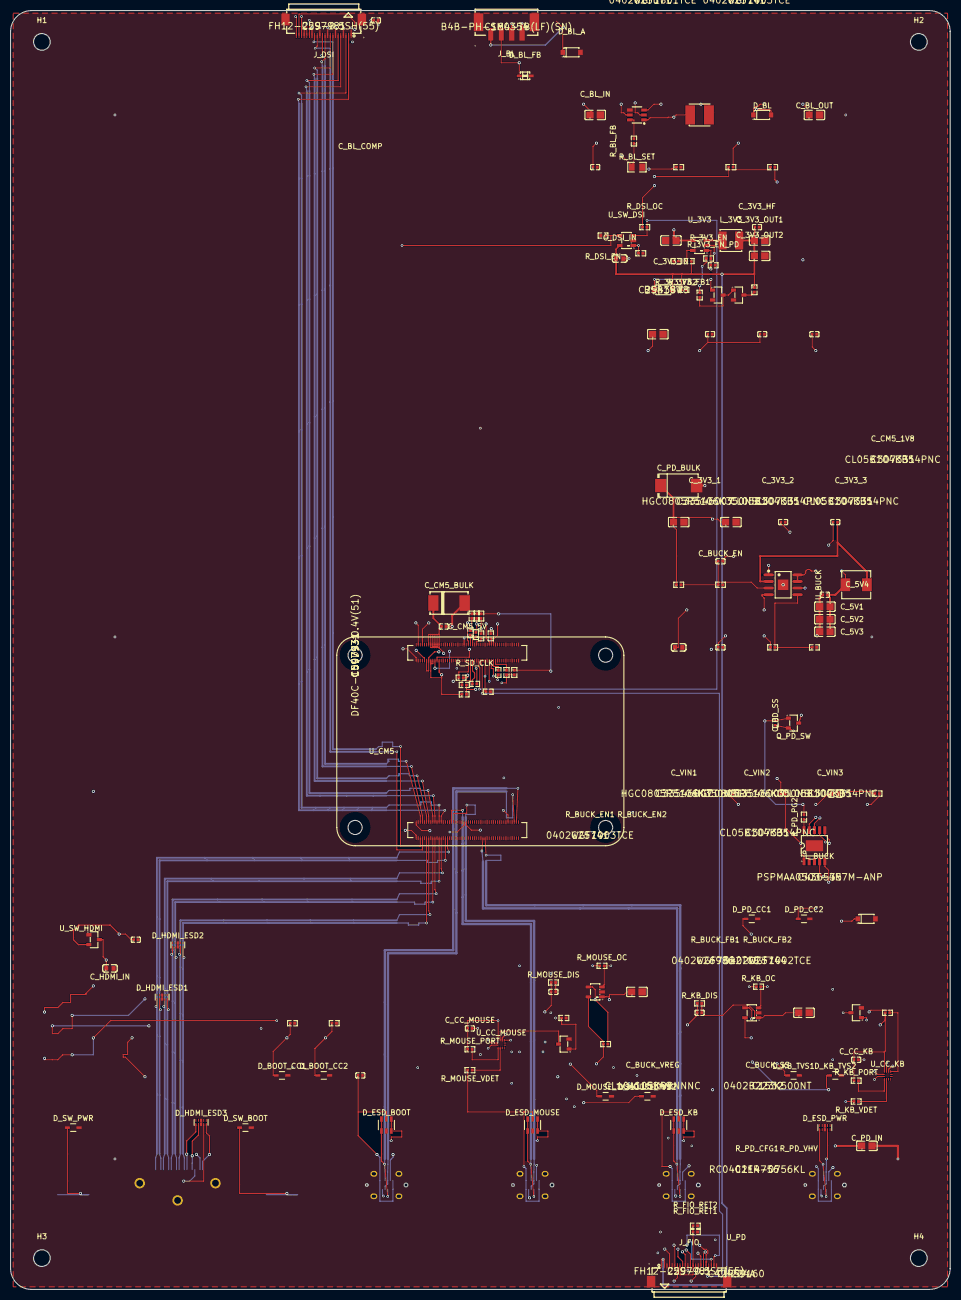
[picture p52: board compact-cm5-desktop.kicad_pcb from above]

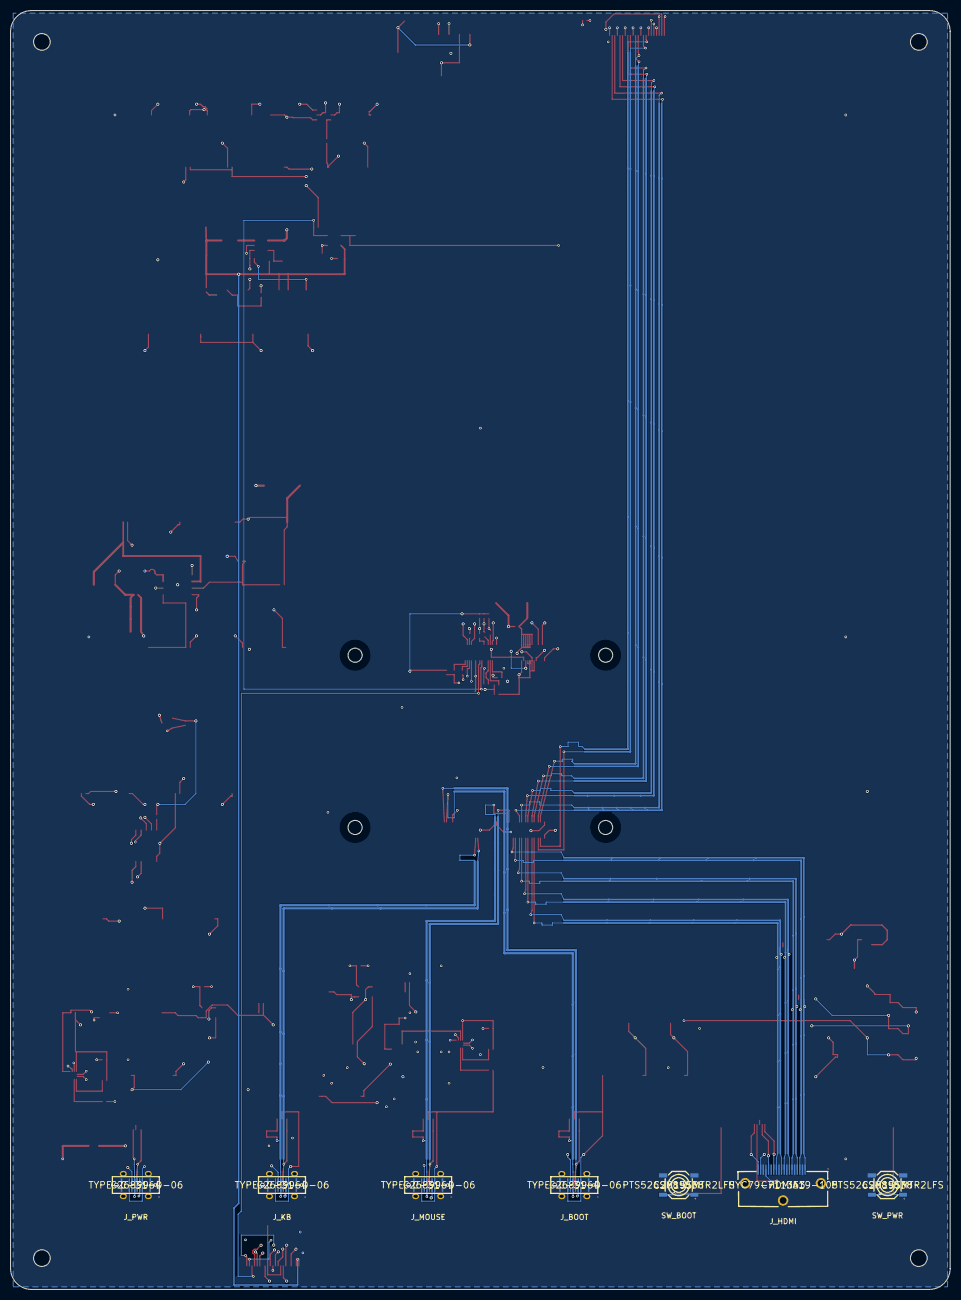
[picture p53: board compact-cm5-desktop.kicad_pcb from below]

Board: 4 copper layers, 180.0 x 245.0 mm, 147 parts (7 on the bottom side), 112 nets.

Other parts of the board:
H1, H2, H3, H4: MountingHole_3.2mm_M3
