CopperPilot/desktop-computer-retro/modules/keyboard/hardware/compact-58key-keyboard.kicad_pcb

## KiCad design modules/keyboard/hardware/compact-58key-keyboard.kicad_pcb (2026-11-03)

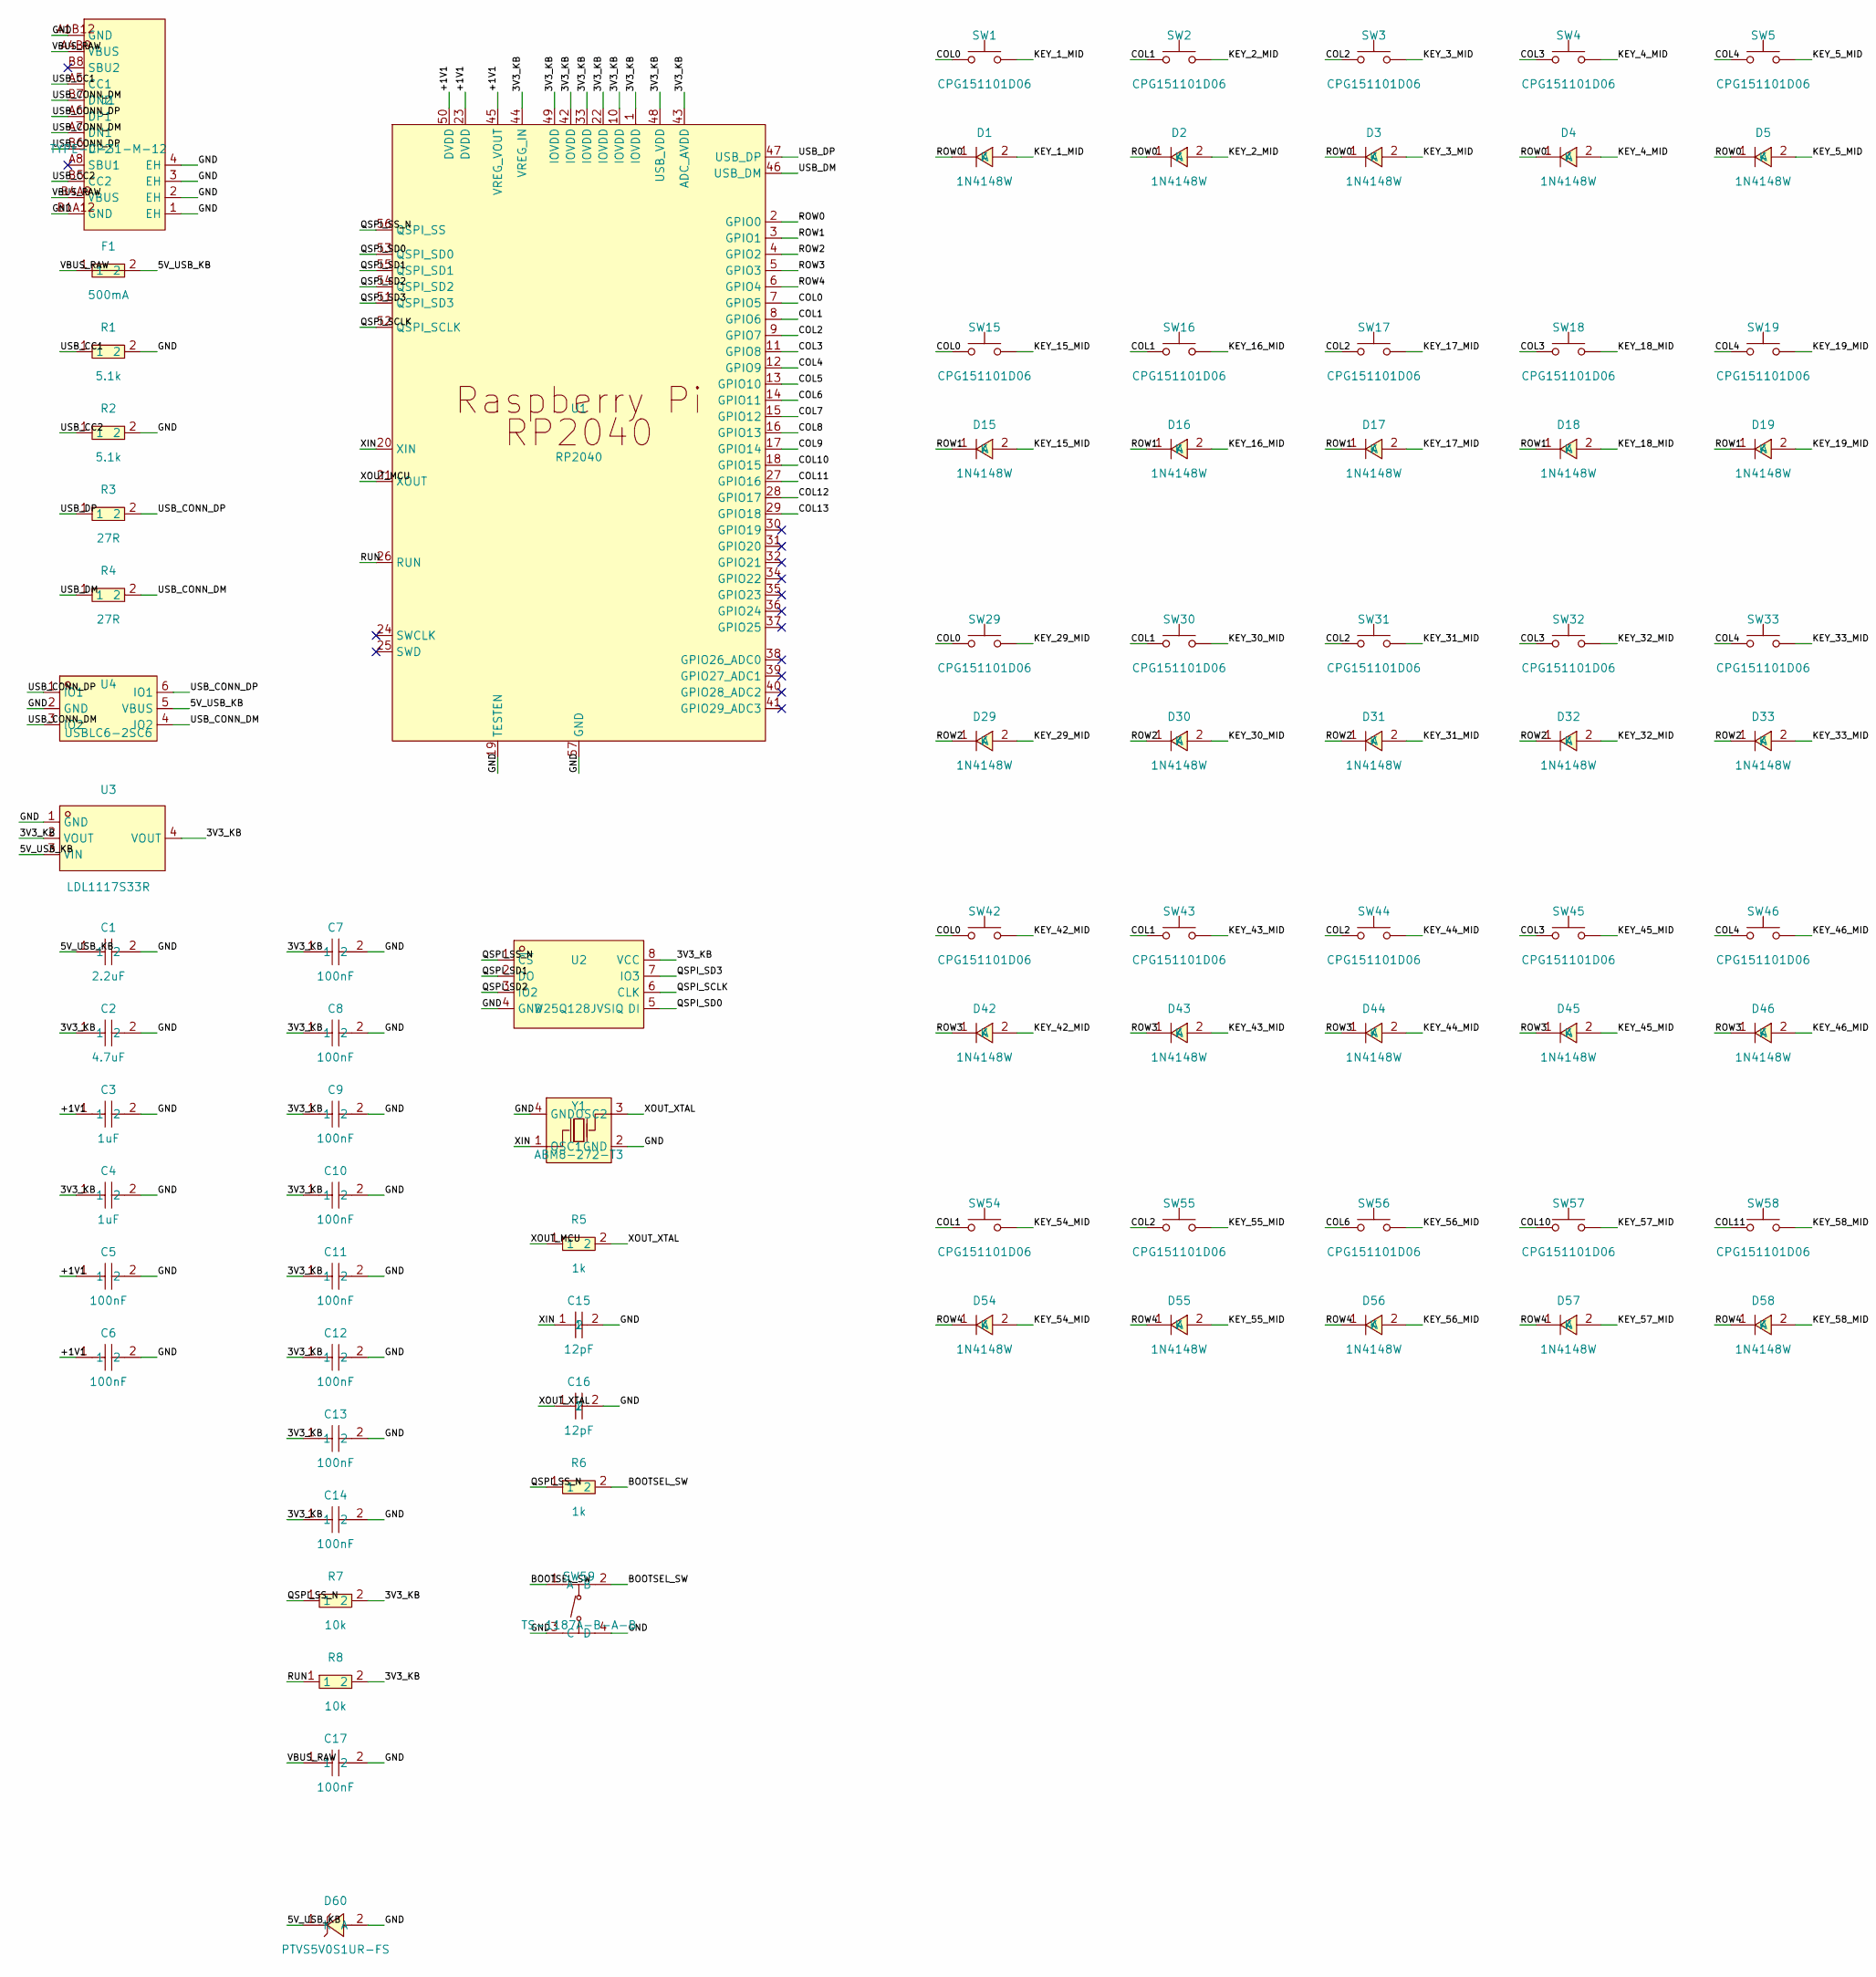
[picture p54: schematic compact-58key-keyboard.kicad_sch, Compact 58-key mechanical desktop keyboard, part in row 1, column 1]

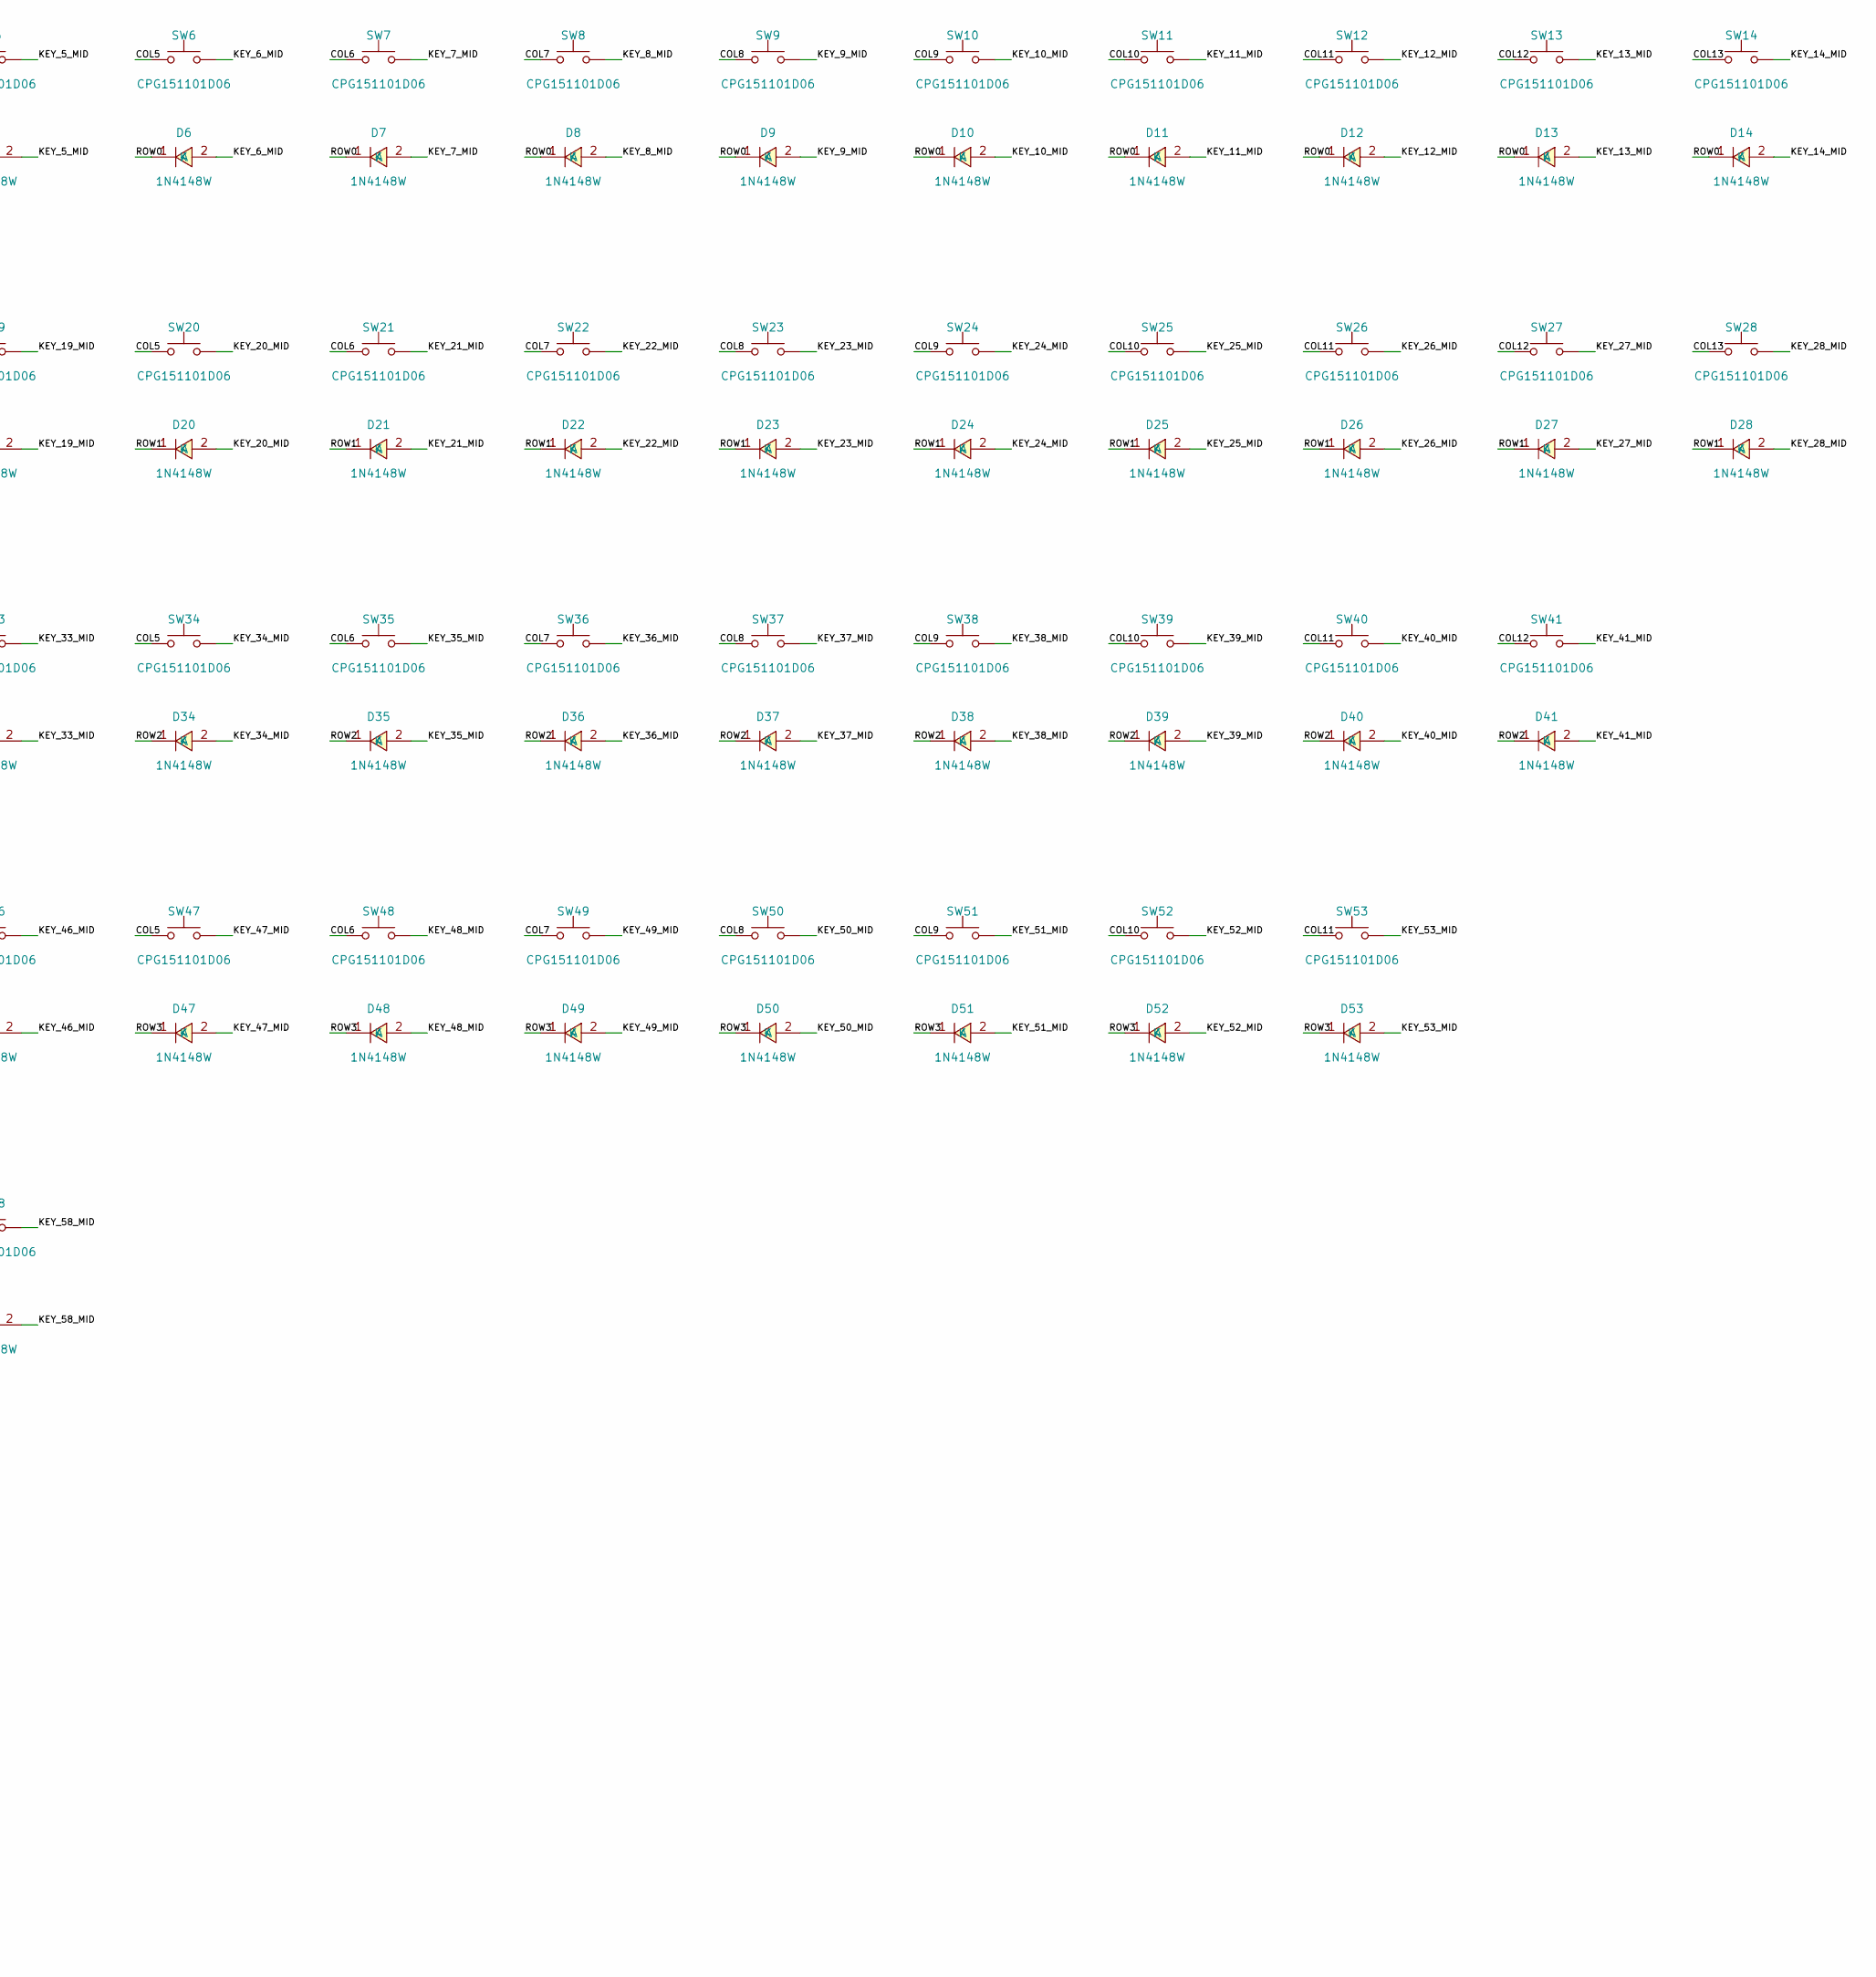
[picture p55: schematic compact-58key-keyboard.kicad_sch, Compact 58-key mechanical desktop keyboard, part in row 1, column 2]

Parts:
C1: 2.2uF; C0805; MPN CL21B225KAFNNNE; LCSC C19110
C2: 4.7uF; C0805; MPN CL21A475KAQNNNE; LCSC C1779
C3, C4: 1uF; C0402; LCSC C52923
C5, C6, C7, C8, C9, C10, C11, C12, C13, C14, C17: 100nF; C0402; LCSC C1525
C15, C16: 12pF; C0402; LCSC C1547
D1, D2, D3, D4, D5, D6, D7, D8, D9, D10, D11, D12, D13, D14, D15, D16, D17, D18, D19, D20, D21, D22, D23, D24, D25, D26, D27, D28, D29, D30, D31, D32, D33, D34, D35, D36, D37, D38, D39, D40, D41, D42, D43, D44, D45, D46, D47, D48, D49, D50, D51, D52, D53, D54, D55, D56, D57, D58: 1N4148W; SOD-123F_L2.7-W1.6-LS3.8-RD; LCSC C81598
D60: PTVS5V0S1UR-FS; SOD-123FL_L2.7-W1.8-LS3.8-RD; MPN PTVS5V0S1UR-FS; LCSC C5380694
F1: 500mA; F0805; MPN BSMD0805-050-24V; LCSC C910822
J1: TYPE-C-31-M-12; USB-C_SMD-TYPE-C-31-M-12_1; LCSC C165948
R1, R2: 5.1k; R0402; LCSC C25905
R3, R4: 27R; R0402; LCSC C25156
R5, R6: 1k; R0402; LCSC C11702
R7, R8: 10k; R0402; MPN 0402WGF1002TCE; LCSC C25744
SW1, SW2, SW3, SW4, SW5, SW6, SW7, SW8, SW9, SW10, SW11, SW12, SW13, SW16, SW17, SW18, SW19, SW20, SW21, SW22, SW23, SW24, SW25, SW26, SW27, SW30, SW31, SW32, SW33, SW34, SW35, SW36, SW37, SW38, SW39, SW40, SW43, SW44, SW45, SW46, SW47, SW48, SW49, SW50, SW51, SW52: CPG151101D06; SW_Cherry_MX_1.00u_PCB; LCSC C49234237
SW14: CPG151101D06; SW_Cherry_MX_2.00u_PCB; LCSC C49234237
SW15, SW28, SW55, SW57: CPG151101D06; SW_Cherry_MX_1.50u_PCB; LCSC C49234237
SW29: CPG151101D06; SW_Cherry_MX_1.75u_PCB; LCSC C49234237
SW41, SW42: CPG151101D06; SW_Cherry_MX_2.25u_PCB; LCSC C49234237
SW53: CPG151101D06; SW_Cherry_MX_2.75u_PCB; LCSC C49234237
SW54, SW58: CPG151101D06; SW_Cherry_MX_1.25u_PCB; LCSC C49234237
SW56: CPG151101D06; SW_Cherry_MX_6.25u_PCB; LCSC C49234237
SW59: TS-1187A-B-A-B; SW-SMD_4P-L5.1-W5.1-P3.70-LS6.5-TL_H1.5; LCSC C318884
U1: RP2040; LQFN-56_L7.0-W7.0-P0.4-EP; LCSC C2040
U2: W25Q128JVSIQ; SOIC-8_L5.3-W5.3-P1.27-LS8.0-BL; LCSC C97521
U3: LDL1117S33R; SOT-223-4_L6.5-W3.5-P2.30-LS7.0-BR; MPN LDL1117S33R; LCSC C435835
U4: USBLC6-2SC6; SOT-23-6_L2.9-W1.6-P0.95-LS2.8-BL; LCSC C2827654
Y1: ABM8-272-T3; CRYSTAL-SMD_4P-L3.2-W2.5-BL; MPN ABM8-272-T3; LCSC C20625731

Connections:
/3V3_KB: C2.1, C4.1, C7.1, C8.1, C9.1, C10.1, C11.1, C12.1, C13.1, C14.1, R7.2, R8.2, U1.1 (IOVDD), U1.10 (IOVDD), U1.22 (IOVDD), U1.33 (IOVDD), U1.42 (IOVDD), U1.43 (ADC_AVDD), U1.44 (VREG_IN), U1.48 (USB_VDD), U1.49 (IOVDD), U2.8 (VCC), U3.2 (VOUT), U3.4 (VOUT)
/5V_USB_KB: C1.1, D60.1 (K), F1.2, U3.3 (VIN), U4.5 (VBUS)
/+1V1: C3.1, C5.1, C6.1, U1.23 (DVDD), U1.45 (VREG_VOUT), U1.50 (DVDD)
/BOOTSEL_SW: R6.2, SW59.1 (A), SW59.2 (B)
/COL0: SW1.1, SW15.1, SW29.1, SW42.1, U1.7 (GPIO5)
/COL1: SW2.1, SW16.1, SW30.1, SW43.1, SW54.1, U1.8 (GPIO6)
/COL2: SW3.1, SW17.1, SW31.1, SW44.1, SW55.1, U1.9 (GPIO7)
/COL3: SW4.1, SW18.1, SW32.1, SW45.1, U1.11 (GPIO8)
/COL4: SW5.1, SW19.1, SW33.1, SW46.1, U1.12 (GPIO9)
/COL5: SW6.1, SW20.1, SW34.1, SW47.1, U1.13 (GPIO10)
/COL6: SW7.1, SW21.1, SW35.1, SW48.1, SW56.1, U1.14 (GPIO11)
/COL7: SW8.1, SW22.1, SW36.1, SW49.1, U1.15 (GPIO12)
/COL8: SW9.1, SW23.1, SW37.1, SW50.1, U1.16 (GPIO13)
/COL9: SW10.1, SW24.1, SW38.1, SW51.1, U1.17 (GPIO14)
/COL10: SW11.1, SW25.1, SW39.1, SW52.1, SW57.1, U1.18 (GPIO15)
/COL11: SW12.1, SW26.1, SW40.1, SW53.1, SW58.1, U1.27 (GPIO16)
/COL12: SW13.1, SW27.1, SW41.1, U1.28 (GPIO17)
/COL13: SW14.1, SW28.1, U1.29 (GPIO18)
/GND: C1.2, C2.2, C3.2, C4.2, C5.2, C6.2, C7.2, C8.2, C9.2, C10.2, C11.2, C12.2, C13.2, C14.2, C15.2, C16.2, C17.2, D60.2 (A), J1.1 (EH), J1.2 (EH), J1.3 (EH), J1.4 (EH), J1.A1B12 (GND), J1.B1A12 (GND), R1.2, R2.2, SW59.3 (C), SW59.4 (D), U1.19 (TESTEN), U1.57 (GND), U2.4 (GND), U3.1 (GND), U4.2 (GND), Y1.2 (GND), Y1.4 (GND)
/KEY_1_MID: D1.2 (A), SW1.2
/KEY_2_MID: D2.2 (A), SW2.2
/KEY_3_MID: D3.2 (A), SW3.2
/KEY_4_MID: D4.2 (A), SW4.2
/KEY_5_MID: D5.2 (A), SW5.2
/KEY_6_MID: D6.2 (A), SW6.2
/KEY_7_MID: D7.2 (A), SW7.2
/KEY_8_MID: D8.2 (A), SW8.2
/KEY_9_MID: D9.2 (A), SW9.2
/KEY_10_MID: D10.2 (A), SW10.2
/KEY_11_MID: D11.2 (A), SW11.2
/KEY_12_MID: D12.2 (A), SW12.2
/KEY_13_MID: D13.2 (A), SW13.2
/KEY_14_MID: D14.2 (A), SW14.2
/KEY_15_MID: D15.2 (A), SW15.2
/KEY_16_MID: D16.2 (A), SW16.2
/KEY_17_MID: D17.2 (A), SW17.2
/KEY_18_MID: D18.2 (A), SW18.2
/KEY_19_MID: D19.2 (A), SW19.2
/KEY_20_MID: D20.2 (A), SW20.2
/KEY_21_MID: D21.2 (A), SW21.2
/KEY_22_MID: D22.2 (A), SW22.2
/KEY_23_MID: D23.2 (A), SW23.2
/KEY_24_MID: D24.2 (A), SW24.2
/KEY_25_MID: D25.2 (A), SW25.2
/KEY_26_MID: D26.2 (A), SW26.2
/KEY_27_MID: D27.2 (A), SW27.2
/KEY_28_MID: D28.2 (A), SW28.2
/KEY_29_MID: D29.2 (A), SW29.2
/KEY_30_MID: D30.2 (A), SW30.2
/KEY_31_MID: D31.2 (A), SW31.2
/KEY_32_MID: D32.2 (A), SW32.2
/KEY_33_MID: D33.2 (A), SW33.2
/KEY_34_MID: D34.2 (A), SW34.2
/KEY_35_MID: D35.2 (A), SW35.2
/KEY_36_MID: D36.2 (A), SW36.2
/KEY_37_MID: D37.2 (A), SW37.2
/KEY_38_MID: D38.2 (A), SW38.2
/KEY_39_MID: D39.2 (A), SW39.2
/KEY_40_MID: D40.2 (A), SW40.2
/KEY_41_MID: D41.2 (A), SW41.2
/KEY_42_MID: D42.2 (A), SW42.2
/KEY_43_MID: D43.2 (A), SW43.2
/KEY_44_MID: D44.2 (A), SW44.2
/KEY_45_MID: D45.2 (A), SW45.2
/KEY_46_MID: D46.2 (A), SW46.2
/KEY_47_MID: D47.2 (A), SW47.2
/KEY_48_MID: D48.2 (A), SW48.2
/KEY_49_MID: D49.2 (A), SW49.2
/KEY_50_MID: D50.2 (A), SW50.2
/KEY_51_MID: D51.2 (A), SW51.2
/KEY_52_MID: D52.2 (A), SW52.2
/KEY_53_MID: D53.2 (A), SW53.2
/KEY_54_MID: D54.2 (A), SW54.2
/KEY_55_MID: D55.2 (A), SW55.2
/KEY_56_MID: D56.2 (A), SW56.2
/KEY_57_MID: D57.2 (A), SW57.2
/KEY_58_MID: D58.2 (A), SW58.2
/QSPI_SCLK: U1.52 (QSPI_SCLK), U2.6 (CLK)
/QSPI_SD0: U1.53 (QSPI_SD0), U2.5 (DI)
/QSPI_SD1: U1.55 (QSPI_SD1), U2.2 (DO)
/QSPI_SD2: U1.54 (QSPI_SD2), U2.3 (IO2)
/QSPI_SD3: U1.51 (QSPI_SD3), U2.7 (IO3)
/QSPI_SS_N: R6.1, R7.1, U1.56 (QSPI_SS), U2.1 (~CS)
/ROW0: D1.1 (K), D2.1 (K), D3.1 (K), D4.1 (K), D5.1 (K), D6.1 (K), D7.1 (K), D8.1 (K), D9.1 (K), D10.1 (K), D11.1 (K), D12.1 (K), D13.1 (K), D14.1 (K), U1.2 (GPIO0)
/ROW1: D15.1 (K), D16.1 (K), D17.1 (K), D18.1 (K), D19.1 (K), D20.1 (K), D21.1 (K), D22.1 (K), D23.1 (K), D24.1 (K), D25.1 (K), D26.1 (K), D27.1 (K), D28.1 (K), U1.3 (GPIO1)
/ROW2: D29.1 (K), D30.1 (K), D31.1 (K), D32.1 (K), D33.1 (K), D34.1 (K), D35.1 (K), D36.1 (K), D37.1 (K), D38.1 (K), D39.1 (K), D40.1 (K), D41.1 (K), U1.4 (GPIO2)
/ROW3: D42.1 (K), D43.1 (K), D44.1 (K), D45.1 (K), D46.1 (K), D47.1 (K), D48.1 (K), D49.1 (K), D50.1 (K), D51.1 (K), D52.1 (K), D53.1 (K), U1.5 (GPIO3)
/ROW4: D54.1 (K), D55.1 (K), D56.1 (K), D57.1 (K), D58.1 (K), U1.6 (GPIO4)
/RUN: R8.1, U1.26 (RUN)
/USB_CC1: J1.A5 (CC1), R1.1
/USB_CC2: J1.B5 (CC2), R2.1
/USB_CONN_DM: J1.A7 (DN1), J1.B7 (DN2), R4.2, U4.3 (IO2), U4.4 (IO2)
/USB_CONN_DP: J1.A6 (DP1), J1.B6 (DP2), R3.2, U4.1 (IO1), U4.6 (IO1)
/USB_DM: R4.1, U1.46 (USB_DM)
/USB_DP: R3.1, U1.47 (USB_DP)
/VBUS_RAW: C17.1, F1.1, J1.A4B9 (VBUS), J1.B4A9 (VBUS)
/XIN: C15.1, U1.20 (XIN), Y1.1 (OSC1)
/XOUT_MCU: R5.1, U1.21 (XOUT)
/XOUT_XTAL: C16.1, R5.2, Y1.3 (OSC2)

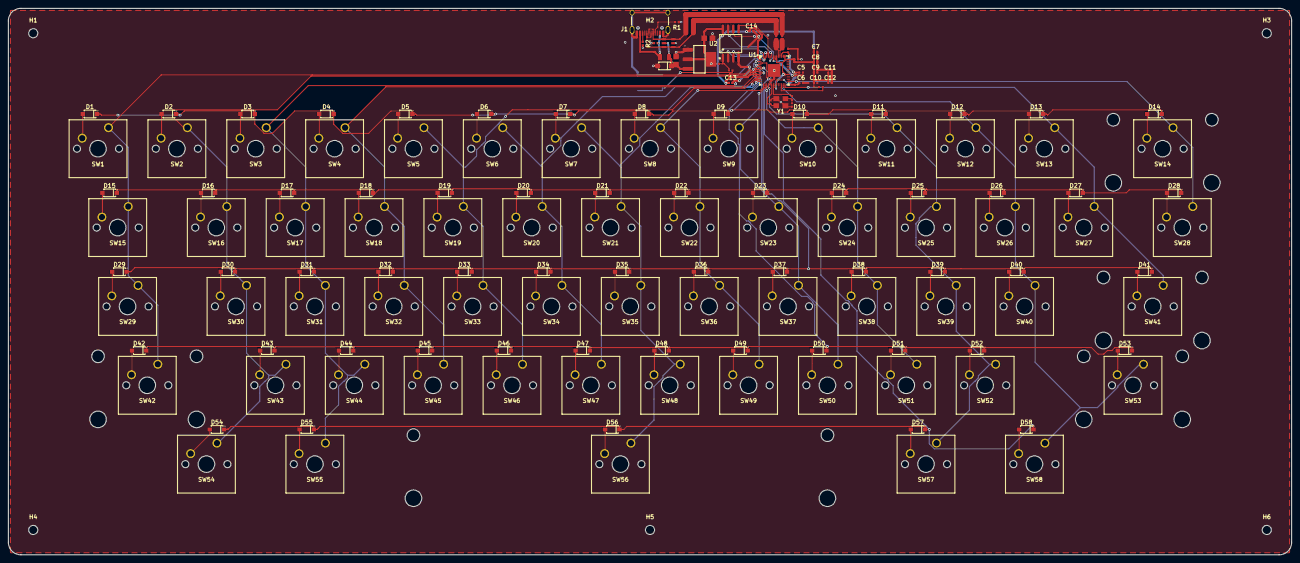
[picture p56: board compact-58key-keyboard.kicad_pcb from above]

Board: 2 copper layers, 310.0 x 132.0 mm, 156 parts (1 on the bottom side), 99 nets.

Other parts of the board:
H1, H2, H3, H4, H5, H6: MountingHole_2.2mm_M2
