CopperPilot/desktop-computer-retro/(commit log)

2026-11-03 CopperPilot Retro Desktop Computer: 1980s-style all-in-one with keyboard and mouse, designed end to end by CopperPilot
    Raspberry Pi CM5, 8-inch 4:3 IPS, front SD slot and brightness wheel, 58-key mechanical keyboard (RP2040),
    one-button optical mouse (STM32F042), 15 V USB-C PD. Three modules, four KiCad 10 boards, enclosures, fab
    outputs, gate report (142 pass, 6 warn, 0 fail), design reviews (0 P0, 0 P1 open), judge notes (8/10) and build
    film. Not yet built; open for review.
    [boot_button.stl, bootsel_button.stl, bottom_shell.stl, brightness_wheel.stl, cm5_module.stl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]
2026-11-08 Build film and renders re-rendered: the computer stands facing you, the keyboard and mouse lie flat, checked frame by frame
    The desktop stood on its back with its screen to the sky, and the keyboard and mouse stood on their edges. Each now
    rests as it is used, every part backs out along the direction it was fitted, every frame is replayed against the 3D
    models, and a separate critic watched each module's film (reviews/film.md). The system segment is in the same dark
    studio, with the camera kept outside every module.
